raudiez/tfg/README.md

**Deaf Alert System**
=================

This **Final Degree Project** consist in a **alert system** that does rgb leds bulvs change its color light and state with every alert, and simultaneously notify an android app with the alert.

You can find more information in "*MemoriaTFG.pdf*" file (in Spanish), like setup instructions.
