raudiez/tfg/src_tex/portadas/portada-especificaciones.tex

\thispagestyle{empty}
\normalsize
\mdseries
\begin{center}

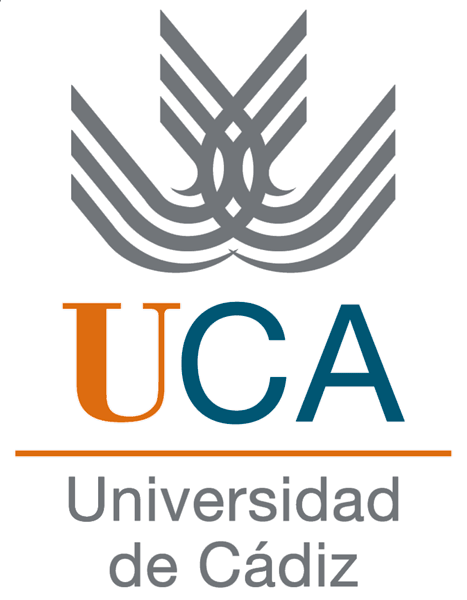
[picture p11: src_tex/img/logo-uca.png]
   \\\

  \vspace{1.5cm}

  \huge{SISTEMA DE AVISOS PARA DISCAPACITADOS AUDITIVOS} \\
  
  \vspace{0.6cm}

  \large{REF: 000001} \\
  
  \vspace{1.0cm}

  \Huge{\textbf{ESPECIFICACIONES DEL SISTEMA}} \\

  \vspace{2.5cm}

\end{center}
\begin{itemize}
\item {\textbf{CLIENTE:} UNIVERSIDAD DE CÁDIZ (ESCUELA SUPERIOR DE INGENIERÍA)\\
            AVENIDA DE LA UNIVERSIDAD DE CÁDIZ Nº 10, 11519 PUERTO REAL\\
            956 48 32 00\\
            \underline{DIRECCION.ESI@UCA.ES}
            }
            \vspace{0.5cm}
\item {\textbf{AUTOR:} RAÚL DÍEZ SÁNCHEZ\\
            INGENIERO INFORMÁTICO\\
            77171812-G\\
            \underline{RA.DIEZSANCHEZ@ALUM.UCA.ES}}
\end{itemize}

\vspace{0.2cm}

\begin{flushright}
  \large{Cádiz, \today} \\
\end{flushright}
