raudiez/tfg/src_tex/contenido/0_hoja_identificacion.tex

\begin{itemize}
    \item \textbf{Título del proyecto:} Sistema de avisos para discapacitados auditivos \\
    \item \textbf{Código del proyecto:} 000001 \\
    \item \textbf{Datos del cliente:} \\
        \begin{itemize}
            \vspace{-0.4cm}
            \item Universidad de Cádiz (Escuela Superior de Ingeniería)
            \item Avenida de la Universidad de Cádiz Nº10, 11519 Puerto Real
            \item 956 48 32 00
            \item direccion.esi@uca.es
        \end{itemize}
    \item \textbf{Datos del suministrador:} \\
        \begin{itemize}
            \vspace{-0.4cm}
            \item Raúl Díez Sánchez
            \item Ingeniero Informático
            \item Calle Sagasta Nº 56 1ºA, 11002 Cádiz
            \item 653 50 41 47
            \item ra.diezsanchez@alum.uca.es
        \end{itemize}
\end{itemize}

\vspace{2cm}

Firmado:

\vspace{-0.9cm} 
\begin{flushright} Cádiz, \today \end{flushright}

\vspace{2cm}

\begin{table}[h]
    \centering
    \begin{tabular}{lr}
        Raúl Díez Sánchez & \hspace{9cm}Cliente
    \end{tabular}
\end{table}
