raudiez/tfg/src_tex/contenido/18_presupuesto.tex

\section{Presupuesto para la realización del Proyecto}

En la tabla~\ref{tab:presupuesto_demo} se incluye el presupuesto total para la realización de este Proyecto, incluyendo también los costes asociados a la implementación del sistema de demostración, IVA incluido.

\begin{table}[!ht]
    \centering
    \resizebox{\textwidth}{!}{%
    \begin{tabular}{|P{4.5cm}|c|c|c|c|}
        \hline
        \textbf{Artículo} & \textbf{Detalles} & \textbf{Cantidad} & \textbf{Precio} & \textbf{Total} \\ \hline
        Raspberry Pi B &~\cite{presupuesto_raspberry} & 1 & 31,52 €/u & 31,52 €\\ \hline
        Adaptador de corriente para Raspberry Pi &~\cite{presupuesto_corriente_raspi} & 1 & 5,78 €/u & 5,78 € \\ \hline
        Relé 40.31 12V &~\cite{presupuesto_rele12} & 1 & 5,37 €/u & 5,37 € \\ \hline
        Relé T92S7A12-240 240V &~\cite{presupuesto_rele240} & 1 & 17,69 €/u & 17,69 € \\ \hline
        Terminal para PCB &~\cite{presupuesto_terminal} & 4 & 0,24 €/u & 0,96 € \\ \hline
        Tarjeta SD 8GB para Raspberry Pi &~\cite{presupuesto_sd} & 1 & 12,95 €/u & 12,95 € \\ \hline
        Kit de inicio Philips Hue &~\cite{huestarterprice} & 1 & 199,95 €/u & 199,95 € \\ \hline
        Latiguillo 1m RJ-45 Cat5e &~\cite{presupuesto_rj45} & 1 & 2,06 €/u & 2,06 € \\ \hline
        Resistencia de 4,7K$\Omega$ &\cite{presupuesto_resistencia} & 2 & 0,04 €/u & 0,8 € \\ \hline
        Arduino Mega &~\cite{presupuesto_arduino} & 1 & 56,94 €/u & 56,94 € \\ \hline
        Arduino Ethernet Shield &~\cite{presupuesto_arduino_shield} & 1 & 24,01 €/u & 24,01 € \\ \hline
        Cable USB para Arduino Mega &~\cite{presupuesto_arduino_usb} & 1 & 3,31 €/u & 3,31 € \\ \hline
        Zumbador 230V para timbre & - & 1 & 4,50 €/u & 4,50 € \\ \hline
        Zumbador 12V para telefonillo &~\cite{presupuesto_timbre} & 1 & 2,71 €/u & 2,71 € \\ \hline
        Fuente de alimentación 12V &~\cite{presupuesto_fuente12v} & 1 & 14,92 €/u & 14,92 € \\ \hline
        Pulsador timbre & - & 1 & 2,75 €/u & 2,75 € \\ \hline
        Portalámparas E27 & - & 2 & 0,90 €/u & 1,80 € \\ \hline
        \textbf{Total}& \multicolumn{3}{c|}{} & 388,02 € \\ \hline
    \end{tabular}
    }
    \caption{Presupuesto para la realización del Proyecto.}
    \label{tab:presupuesto_demo}
\end{table}

\clearpage
\section{Presupuesto de implantación del Proyecto}
\label{sec:presupuesto}

En la tabla~\ref{tab:presupuesto_final} se incluye el presupuesto total para la implantación de este Proyecto, IVA incluido.

\begin{table}[!ht]
    \centering
    \resizebox{\textwidth}{!}{%
    \begin{tabular}{|P{4cm}|c|c|c|c|}
        \hline
        \textbf{Artículo} & \textbf{Detalles} & \textbf{Cantidad} & \textbf{Precio} & \textbf{Total} \\ \hline
        Raspberry Pi B &~\cite{presupuesto_raspberry} & 1 & 31,52 €/u & 31,52 €\\ \hline
        Adaptador de corriente para Raspberry Pi &~\cite{presupuesto_corriente_raspi} & 1 & 5,78 €/u & 5,78 € \\ \hline
        Relé 40.31 12V &~\cite{presupuesto_rele12} & 1 & 5,37 €/u & 5,37 € \\ \hline
        Relé T92S7A12-240 240V &~\cite{presupuesto_rele240} & 1 & 17,69 €/u & 17,69 € \\ \hline
        Terminal para PCB &~\cite{presupuesto_terminal} & 4 & 0,24 €/u & 0,96 € \\ \hline
        Tarjeta SD 8GB para Raspberry Pi &~\cite{presupuesto_sd} & 1 & 12,95 €/u & 12,95 € \\ \hline
        Kit de inicio Philips Hue &~\cite{huestarterprice} & 1 & 199,95 €/u & 199,95 € \\ \hline
        Latiguillo 1m RJ-45 Cat5e &~\cite{presupuesto_rj45} & 1 & 2,06 €/u & 2,06 € \\ \hline
        Resistencia de 4,7K$\Omega$ &\cite{presupuesto_resistencia} & 2 & 0,04 €/u & 0,8 € \\ \hline
        \textbf{Total}& \multicolumn{3}{c|}{} & 277,08 € \\ \hline
    \end{tabular}
    }
    \caption{Presupuesto de implantación del Proyecto.}
    \label{tab:presupuesto_final}
\end{table}

Este presupuesto no cubre el coste de un router integrado, el cual como se observa en el apartado~\ref{sec:routerintegrado}, se supone ya instalado en la vivienda.

    \subsection{Mano de obra}

    La mano de obra asociada al Proyecto es de 35 € por instalación de dispositivo en portal, más 35 € por instalación de dispositivo en la puerta de la vivienda, más 60 € por instalación del sistema central y configuración. Esto hace un total de \textbf{130 €}, tal como se observa en la tabla~\ref{tab:presupuesto_manoobra}.

    \begin{table}[!ht]
        \centering
        \resizebox{0.6\textwidth}{!}{%
        \begin{tabular}{|l|c|}
            \hline
            \textbf{Descripción} & \textbf{Precio} \\ \hline
            Instalación de dispositivo en portal & 35 €\\ \hline
            Instalación de dispositivo en puerta de la vivienda & 35 €\\ \hline
            Instalación de sistema central y configuración & 60 €\\ \hline
            \textbf{Total}& 130 € \\ \hline
        \end{tabular}
        }
        \caption{Presupuesto de mano de obra.}
        \label{tab:presupuesto_manoobra}
    \end{table}

    \subsection{Resumen del presupuesto}

    Los costes de presupuesto para la implantación en una vivienda real son de 277.08 €, debiéndose sumar además el coste de mano de obra, que asciende a los 130 €. Esto supone un \textbf{coste total de 407.08 €}. Se debe tener en cuenta además que este precio es el relativo a instalar 3 bombillas Hue, teniendo un coste de 52.99 € por bombilla extra a instalar~\cite{hueindividualprice}, tal como se muestra en la tabla~\ref{tab:presupuesto_resumen}.

    \begin{table}[!ht]
        \centering
        \resizebox{0.6\textwidth}{!}{%
        \begin{tabular}{|l|c|}
            \hline
            \textbf{Descripción} & \textbf{Precio} \\ \hline
            Implantación del Proyecto en vivienda real & 277.08 €\\ \hline
            Mano de obra & 130 €\\ \hline
            \textbf{Total}& 407.08 € \\ \hline
        \end{tabular}
        }
        \caption{Resumen del presupuesto de implantación del Proyecto}
        \label{tab:presupuesto_resumen}
    \end{table}
