raudiez/tfg/src_tex/portadas/portada-inicial.tex

\begin{titlepage}

  \begin{center}

     \\
    
    \vspace{2.5cm}
    
    \LARGE{\textbf{ESCUELA SUPERIOR DE INGENIERÍA}} \\
    
    \vspace{1.0cm}
    
    \Large{\textbf{GRADO EN INGENIERÍA INFORMÁTICA}} \\
    
    \vspace{3.0cm}
    
    \Large{SISTEMA DE AVISOS PARA DISCAPACITADOS AUDITIVOS} \\
    
    \vspace{2.5cm}
    
    \Large{Raúl Díez Sánchez} \\
  
    \vspace{0.5cm}

    \large{\today}
    
  \end{center}
\end{titlepage}
