raudiez/tfg/src_tex/portadas/portada-secundaria.tex

\begin{center}

   \\

  \vspace{2.0cm}

  \Large{ESCUELA SUPERIOR DE INGENIERÍA} \\

  \vspace{1.0cm}

  \large{GRADO EN INGENIERÍA EN INFORMÁTICA} \\

  \vspace{1.5cm}

  \huge{SISTEMA DE AVISOS PARA DISCAPACITADOS AUDITIVOS} \\

  \vspace{2.0cm}

\end{center}

\begin{itemize}
\item \large{Departamento: Ingeniería Automática, Electrónica, Arquitectura y Redes de Computadores.}
\item \large{Director del proyecto: Carlos Rodríguez Cordón}
\item \large{Codirector del proyecto: Arturo Morgado Estévez}
\item \large{Autor del proyecto: Raúl Díez Sánchez}
\end{itemize}

\vspace{0.2cm}

\begin{flushright}
  \large{Cádiz, \today} \\

  \vspace{1.5cm}

  \large{Fdo: Raúl Díez Sánchez}
\end{flushright}
