raudiez/tfg/MemoriaTFG.pdf

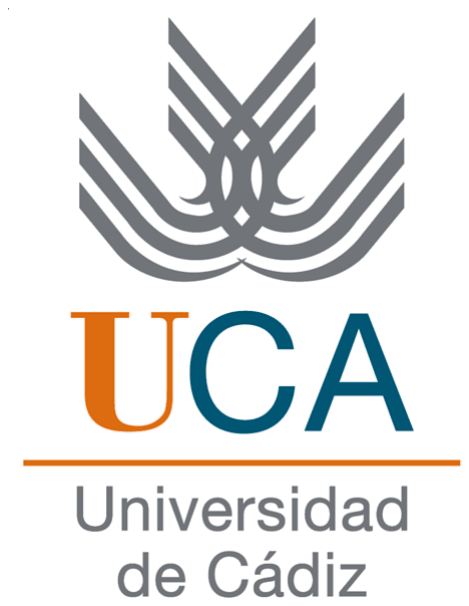
[picture p22: figure]

## ESCUELA SUPERIOR DE INGENIERÍA

## GRADO EN INGENIERÍA INFORMÁTICA

## SISTEMA DE AVISOS PARA DISCAPACITADOS AUDITIVOS

## Raúl Díez Sánchez

3 de febrero de 2016

## ESCUELA SUPERIOR DE INGENIERÍA

GRADO EN INGENIERÍA EN INFORMÁTICA

# SISTEMA DE AVISOS PARA DISCAPACITADOS

# AUDITIVOS

Departamento: Ingeniería Automática, Electrónica, Arquitectura y Redes de Computadores.

Director del proyecto: Carlos Rodríguez Cordón

Codirector del proyecto: Arturo Morgado Estévez

Autor del proyecto: Raúl Díez Sánchez

Cádiz, 3 de febrero de 2016

Fdo: Raúl Díez Sánchez

## Agradecimientos

Quiero agradecer este trabajo a todas las personas que siempre han estado cerca, apoyándome y animándome a continuar en esta etapa de mi vida, gracias a ellos he conseguido cumplir uno de los grandes sueños de mi vida.

A mi familia, en especial a mis padres, por enseñarme que la vida es dura, y que hay que estudiar y trabajar para salir adelante en la vida. Por toda la confianza depositada en mí a lo largo de todos mis estudios. También a Rafael, que aunque no sea de la familia es como si lo fuese, y siempre está ahí para ayudar y apoyar en lo que haga falta.

A mis amigos de toda la vida, Iñaki, José, y María, que, desde el instituto en especial, me han apoyado en todo lo que he hecho, además de pasar muy buenos momentos que siempre me han servido para desconectar. También a todos los demás, los que han estado ahí, todos aportando su granito de arena en todo momento.

A todos mis compañeros, con los que de verdad he hecho amistad, en especial a Alejandro (a ambos), David, Ismael, Joaquín, Paco y Pepe, que tanta ayuda me han proporcionado y con los que tan buenos momentos he pasado a lo largo de mi etapa universitaria.

Por último, a todos los profesores que he tenido, en especial mis profesores del instituto y de la universidad, todos los que me han ayudado a ver que la informática era lo mío. A Javier, que desde el instituto me enseñó lo interesante que puede llegar a ser el mundo de los ordenadores. A Arturo y Carlos, mis tutores, quienes han sabido guiarme para que este trabajo llegase a buen puerto, y me han enseñado lo bonito que puede ser el tema que trato en él.

A todos, gracias. Se acabó.

# SISTEMA DE AVISOS PARA DISCAPACITADOS

# AUDITIVOS

REF: 000001

# ÍNDICE GENERAL

CLIENTE: UNIVERSIDAD DE CÁDIZ (ESCUELA SUPERIOR DE INGENIERÍA) AVENIDA DE LA UNIVERSIDAD DE CÁDIZ No 10, 11519 PUERTO REAL
956 48 32 00
DIRECCION.ESI@UCA.ES

AUTOR: RAÚL DÍEZ SÁNCHEZ
INGENIERO INFORMÁTICO
77171812-G
RA.DIEZSANCHEZ@ALUM.UCA.ES

Cádiz, 3 de febrero de 2016

# Índice general

I | Memoria | 1
0. Hoja de Identificación | 1
1. Introducción | 2
2. Objetivo | 2
3. Antecedentes | 2
4. Descripción de la Situación Actual | 3
5. Normas y Referencias | 4
6. Definiciones y Abreviaturas | 8
7. Requisitos Iniciales | 10
8. Alcance | 10
9. Estudio de Alternativas y Viabilidad | 10

10.Descripción de la Solución Propuesta | 19
11.Planificación Temporal | 45

12.Resumen del Presupuesto | 47
II | Planos | 49
13.Plano 1: Esquemático PCB para conexión con telefonillo | 53
14.Plano 2: Layout PCB para conexión con telefonillo | 54
15.Plano 3: Esquemático PCB para conexión con timbre | 55
16.Plano 4: Layout PCB para conexión con timbre | 56
III | Anexos | 57
17.Documentación de Entrada | 61
18.Análisis y Diseño del Sistema | 62
19.Plan de Pruebas | 76
20.Instalación de Sistema Operativo en Raspberry Pi | 82
21.Estimación de Tamaño y Esfuerzos | 85

22.Hojas técnicas de componentes empleados | 86
IV | Especificaciones del Sistema | 89
23.Especificaciones del Sistema | 93
V | Presupuesto | 101
24.Presupuesto | 105

# Índice de figuras

10.1. Diagrama de bloques del sistema | | 19
10.2. Estructura de directorios y ficheros del software del nodo central | | 32
10.3. Diseño del circuito de interconexión telefonillo-nodo central | | 33
10.4. Diseño del circuito de interconexión timbre-nodo central | | 33
10.5. Diagrama de integración del sistema con el nodo central | | 34
10.6. Diseño final de la arquitectura del sistema | | 35
10.7. Pantalla principal de la aplicación para Android | | 36
10.8. Borrado de alertas en aplicación para Android | | 36
10.9. Menú de configuración de aplicación para Android | | 37
11.1. Diagrama de Gantt de la planificación temporal del Proyecto | | 46
18.1. Diagrama de subsistemas | | 63
18.2. Diagrama de subsistema de gestión de alertas | | 63
18.3. Diagrama de subsistema de gestión de puente Hue | | 64
18.4. Diagrama de casos de uso de aplicación para smartphone | | 69
18.5. Diagrama de diseño del sistema software del nodo central | | 72
18.6. Diagrama de diseño de la aplicación para smartphone | | 72
18.7. Prototipo de la pantalla principal de la aplicación para smartphones | | 73
18.8. Prototipo del menú desplegable | | 74
18.9. Prototipo de ventana emergente para eliminar alertas | | 74
18.10.Prototipo de menú de configuración | | 75
23.1. Resultados para “¿Qué avisos son importantes para ti en tu hogar?” | | 93
23.2. Resultados para “En la actualidad, ¿cómo te percatas de estos avisos?” | | 94
23.3. Resultados para “Haciendo uso de las nuevas tecnologías, ¿crees que puede mejo-
rarse?,¿cómo te gustaría percatarte de los avisos?” | 94
23.4. Resultados para “Continuando con las nuevas tecnologías, ¿crees que sería útil
recibir las mismas alertas en smartphones Android?” | | 94
23.5. Diagrama de Casos de Uso | | 96

# Índice de tablas

9.1. Comparativa de bombillas LED | | 11
9.2. Especificaciones técnicas principales de interés del estándar Bluetooth | | 12
9.3. Especificaciones técnicas principales de interés del estándar IEEE 802.11n | | 13
9.4. Características técnicas principales de interés de Arduino Mega | | 15
9.5. Características técnicas principales de interés de Raspberry Pi B | | 18
12.1. Resumen del presupuesto de implantación del Proyecto | | 47
18.1. Objetivo 1 del nodo central: Utilizar el puente Hue | | 62
18.2. Objetivo 2 del nodo central: Detectar llamadas | | 62
18.3. Objetivo 3 del nodo central: Alertar mediante bombillas | | 62
18.4. Objetivo 4 del nodo central: Alertar mediante smartphone | | 63
18.5. Actor 01: Sistema | | 64
18.6. Caso de Uso 01: Conectar con puente Hue | | 65
18.7. Caso de Uso 02: Configurar puente Hue | | 65
18.8. Caso de Uso 03: Enviar petición a puente Hue | | 66
18.9. Caso de Uso 04: Encontrar nuevas bombillas | | 66
18.10.Caso de Uso 05: Leer estado de pines GPIO | | 67
18.11.Caso de Uso 06: Cambiar estado de bombillas | | 67
18.12.Caso de Uso 07: Enviar alerta a smartphone | | 68
18.13.Objetivo 1 de la aplicación para smartphone: Conectar con nodo central | | 68
18.14.Objetivo 2 de la aplicación para smartphone: Mostrar alerta a usuario | | 68
18.15.Objetivo 3 de la aplicación para smartphone: Gestionar alertas | | 69
18.16.Actor 01: Usuario | | 69
18.17.Caso de Uso 01: Configurar aplicación | | 70
18.18.Caso de Uso 02: Mostrar alerta en pantalla | | 70
18.19.Caso de Uso 03: Mostrar notificación en sistema | | 71
18.20.Caso de Uso 04: Eliminar alerta vista | | 71
19.1. Trazabilidad de Casos de Prueba - Requisitos (Casos de Uso) | | 76
19.2. CP-01: Comprobar recepción de alertas en Raspberry Pi y Hue | | 76
19.3. CP-02: Comprobar recepción de alertas en smartphone | | 77
19.4. CP-03: Comprobar funcionamiento con nuevas bombillas Hue | | 77
19.5. CP-04: Comprobar recepción de alerta de telefonillo en bombillas Hue y aplicación
para smartphone | 78
19.6. CP-05: Comprobar recepción de alerta de timbre en bombillas Hue y aplicación
para smartphone | | 79
19.7. CP-06: Comprobar recepción de notificación en smartphone | | 79

19.8. CP-07: Comprobar gestión de alertas en smartphone | | 80
19.9. CP-08: Comprobar funcionamiento tras caída de red eléctrica | | 80
19.10.CP-09: Comprobar compatibilidad con aplicación oficial de control de bombillas
Hue | | 81
23.1. Objetivo 1 del sistema: Alertar a usuario de llamada al timbre | | 95
23.2. Objetivo 2 del sistema: Alertar a usuario de llamada al telefonillo | | 95
23.3. Requisitos de restricciones de información | | 96
23.4. Requisitos de almacenamiento de información | | 96
23.5. Actor 01: agente externo | | 97
23.6. Actor 02: usuario del sistema | | 97
23.7. Caso de Uso 01: Alertar telefonillo | | 97
23.8. Caso de Uso 02: Alertar timbre | | 98
23.9. Caso de Uso 03: Mostrar alerta en bombilla RGB | | 98
23.10.Caso de Uso 04: Mostrar alerta en smartphone | | 99
24.1. Presupuesto para la realización del Proyecto | 105
24.2. Presupuesto de implantación del Proyecto | 106
24.3. Presupuesto de mano de obra | 106
24.4. Resumen del presupuesto de implantación del Proyecto | 107

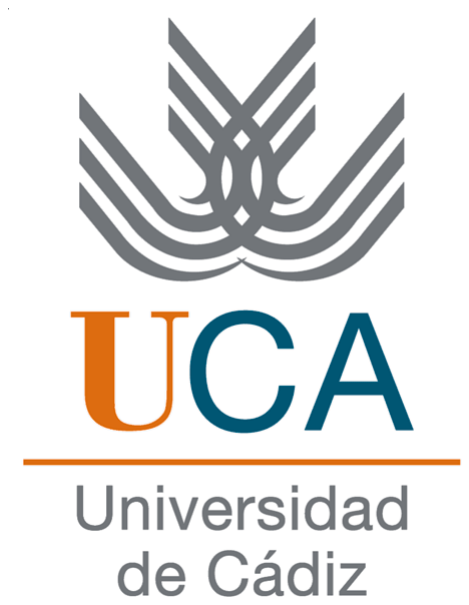
[picture p23: figure]
Parte I

# SISTEMA DE AVISOS PARA DISCAPACITADOS

# AUDITIVOS

REF: 000001

# MEMORIA

CLIENTE: UNIVERSIDAD DE CÁDIZ (ESCUELA SUPERIOR DE INGENIERÍA) AVENIDA DE LA UNIVERSIDAD DE CÁDIZ No 10, 11519 PUERTO REAL
956 48 32 00
DIRECCION.ESI@UCA.ES

AUTOR: RAÚL DÍEZ SÁNCHEZ
INGENIERO INFORMÁTICO
77171812-G
RA.DIEZSANCHEZ@ALUM.UCA.ES

Cádiz, 3 de febrero de 2016

# Índice

0. Hoja de Identificación | 1
1. Introducción | 2
2. Objetivo | 2
3. Antecedentes | 2
4. Descripción de la Situación Actual | 3
5. Normas y Referencias | 4
6. Definiciones y Abreviaturas | 8
7. Requisitos Iniciales | 10

8. Alcance | 10
9. Estudio de Alternativas y Viabilidad | 10
10. Descripción de la Solución Propuesta | 19
11. Planificación Temporal | 45
12. Resumen del Presupuesto | 47

# Hoja de Identificación

Título del proyecto: Sistema de avisos para discapacitados auditivos

Código del proyecto: 000001

Datos del cliente:

- Universidad de Cádiz (Escuela Superior de Ingeniería)
- Avenida de la Universidad de Cádiz No10, 11519 Puerto Real
- 956 48 32 00
- direccion.esi@uca.es

Datos del suministrador:

- Raúl Díez Sánchez
- Ingeniero Informático
- Calle Sagasta No 56 1oA, 11002 Cádiz
- 653 50 41 47
- ra.diezsanchez@alum.uca.es
Firmado: | Cádiz, 3 de febrero de 2016
Raúl Díez Sánchez | Cliente

MEMORIA

SISTEMA DE AVISOS PARA DISCAPACITADOS AUDITIVOS

# 1. Introducción

Cada día más, la tecnología nos muestra lo útil que puede llegar a ser para simplificar o ayudar en nuestro día a día. Un ejemplo de esto son la domótica y los proyectos AAL (o de vida asistida en la vivienda, por sus siglas en inglés) que surgen a raíz de la domotización.

La tecnología ayuda a solventar grandes necesidades, con soluciones cada vez mejores y más adaptadas. La accesibilidad es una de las grandes necesidades de la sociedad: permitir que un producto o servicio pueda ser utilizado por todos los posibles usuarios, incluyendo personas con diferentes capacidades o discapacidades.

Existen diversas discapacidades, y todas presentan un gran problema a la hora de que las personas que las padecen sean autónomas. Una de estas discapacidades es la auditiva. El simple hecho de estar en casa puede ser un gran problema, como lo es no saber cuándo llaman a la puerta.

# 2. Objetivo

El objetivo de este proyecto es crear un sistema para adaptar la vivienda de una persona o personas con discapacidad auditiva, de manera que puedan determinar en todo momento si alguien del exterior está intentando comunicarse con alguien en el interior de la vivienda.

Se pretende implantar un sistema de avisos visuales, que el discapacitado pueda ver, comprender y actuar conforme a la alerta.

# 3. Antecedentes

Actualmente existen varias soluciones a los problemas que pueda tener una persona con discapacidad auditiva, independientes del grado de discapacidad que padezca.

Una de las soluciones consiste en un aparato de bolsillo de avisos por señales de vibración y luces de colores [42], que recibe los avisos de distintos aparatos receptores de ruido que pueden obtener información del ruido generado por el timbre, el teléfono, el portero automático...

Esta solución requeriría que el discapacitado lleve consigo siempre un aparato en el bolsillo, lo cual puede ser un poco molesto. Además, tiene una limitación de número de alarmas a captar.

Otra posible solución es la instalación de ventanas en la mayoría de las paredes de la vivienda (paredes interiores), que permitiría ver las alertas visuales desde cualquier habitación. Este sistema necesitaría que previamente se modificasen los aparatos que emiten alertas sonoras para que emitan alertas visuales, además de reducir la intimidad de las personas que habiten en la

MEMORIA

vivienda.

Una solución diferente a las anteriores es adaptar la instalación eléctrica de la vivienda [41], instalando tantas lámparas por habitación como alertas visuales se quieran mostrar. Estas lámparas mostrarían alertas visuales para el teléfono, el timbre, etc. La mayor desventaja aquí es el consumo de bombillas necesarias para una instalación completa, y el espacio que estas ocuparían.

# 4. Descripción de la Situación Actual

Hoy día, en cualquier vivienda existen demasiadas alertas sonoras como para controlarlas todas. Se pretende así por tanto tratar las alertas más importantes para que las personas con discapacidad puedan percibir los avisos más importantes.

## 4.1. Informe de diagnóstico

En este punto se tratan los distintos aspectos a tener en cuenta dentro de una vivienda estándar en cuanto a alertas se refiere. Este informe es la base de parte de los requisitos no funcionales.

### 4.1.1. Timbre de la puerta

Un caso es el timbre de la puerta, donde una persona con discapacidad auditiva es poco probable que sea capaz de percibir las alertas que genere.

### 4.1.2. Telefonillo (portero automático)

Otro caso es el del portero automático, del cual existen 2 tipos básicos: analógicos y digitales. Pese a que los telefonillos digitales son tecnológicamente superiores, se siguen utilizando telefonillos analógicos, debido a su bajo coste en comparación. Además, históricamente, el uso del telefonillo analógico es más extendido. Debido a estas razones, en este Proyecto se tendrá en cuenta el uso de telefonillo analógico, para abarcar un mayor rango de posibles instalaciones.
Entre los telefonillos analógicos, existen 2 tipos atendiendo al tipo de llamada que realizan:

Llamada zumbador.

Llamada electrónica.

La diferencia principal entre ambos reside en su funcionamiento y la forma de generar la alerta sonora [1].

Telefonillos analógicos de llamada zumbador: En los telefonillos con llamada zumbador, una vez que se realiza la llamada, el grupo fónico de la placa exterior a la vivienda genera una señal alterna de 12 Vac que envía por el hilo de llamada. La señal alterna llega al zumbador situado en el teléfono, haciendo que el zumbador vibre y finalmente produzca el sonido de la llamada.

Telefonillos analógicos de llamada electrónica: En los telefonillos con llamada electrónica, una vez que se realiza la llamada, el grupo fónico de la placa exterior a la vivienda genera una señal formada por diferentes frecuencias, y la envía por el hilo de llamada. La

MEMORIA

señal llega al altavoz del auricular del teléfono, produciendo el sonido de la llamada. La llamada puede ser de varios tipos en función del número de frecuencias utilizadas.

Teniendo en cuenta que los de llamada zumbador envían una señal de 12 Vac, y los de llamada electrónica una señal de varias frecuencias, es más fácil trabajar con los del primer tipo, pudiendo darse soluciones electrónicas bastante sencillas. Además, son el tipo más extendido, y el que más probabilidades hay de encontrar en una vivienda. Se utilizará por tanto un telefonillo de este tipo para la implementación del sistema y la demostración de funcionamiento.

### 4.1.3. Bombillas

En cuanto a las bombillas existentes en una vivienda, las más empleadas son las bombillas de casquillo E27, también llamadas bombillas de rosca Edison. Por tanto, para abarcar un mayor rango de posibles instalaciones, este Proyecto se basará en el uso de bombillas de este tipo.

En caso de manipular estas bombillas, existen dos posibilidades: hacerlo mediante la propia instalación eléctrica, o manipularlas de manera inalámbrica.

### 4.1.4. Router integrado

Dentro de una vivienda habitualmente se puede encontrar un router integrado, dispositivo que integra las funciones y conexiones de un router, un punto de acceso WiFi y un switch Ethernet. Este dispositivo suele ser instalado por el Proveedor de Servicio de Internet (ISP) o incluso hay usuarios que adquieren un router integrado neutro (no ligado a un ISP) por separado.

# 5. Normas y Referencias

## 5.1. Disposiciones legales y Normas aplicadas

UNE 157801:2007 - Criterios generales para la elaboración de proyectos de sistemas de información.

UNE 157001:2014 - Criterios generales para la elaboración formal de los documentos que constituyen un proyecto técnico.

## 5.2. Bibliografía

[1] ALCAD Electronics. Manual Técnico Sistemas Convencionales. http://www.alcad.net/uploads/publicaciones/catalogos/pdf/MANUAL%20CONVENCIONAL.pdf. (http://www.alcad.net/uploads/publicaciones/catalogos/pdf/MANUAL%20CONVENCIONAL.pdf) [29-01-2016].
[2] Amazon. | Phillips Hue Bombilla Individual - Amazon. | http://www.amazon.es/
Philips-Hue-8718696461730-individual-app-control/dp/B016151IW6. (http://www.amazon.es/Philips-Hue-8718696461730-individual-app-control/dp/B016151IW6) [29-01-2016].
[3] Amazon. | Phillips Hue Starter Kit - Amazon. | http://www.amazon.es/
Philips-Hue-eficiencia-energ%C3%A9tica-a_plus_plus_plus/dp/ B016H0R0EA. (http://www.amazon.es/Philips-Hue-eficiencia-energ%C3%A9tica-a_plus_plus_plus/dp/B016H0R0EA) [29-01-2016].

MEMORIA

[4] Arduino. | Arduino Mega Specifications. | https://www.arduino.cc/en/Main/
ArduinoBoardMega. (https://www.arduino.cc/en/Main/ArduinoBoardMega) [29-01-2016].
[5] Arduino. Arduino Playground - Available Memory. http://playground.arduino.cc/Code/AvailableMemory. (http://playground.arduino.cc/Code/AvailableMemory) [29-01-2016].
[6] Arduino. Memory leak in WString / TextString Library? - Arduino Forum. http://forum.arduino.cc/index.php?topic=46753.0. [29-01-2016].
[7] Belkin. | Belkin | WeMo | - | Página | oficial. | http://www.belkin.es/
productos-el-hogar-conectado-domotica-wemo/. (http://www.belkin.es/productos-el-hogar-conectado-domotica-wemo/) [29-01-2016].
[8] Belkin. | Belkin | WeMo | Bombilla | Individual. | http://www.belkin.es/
f7c033vfe27es-bombilla-wemo-smart-led.html. (http://www.belkin.es/f7c033vfe27es-bombilla-wemo-smart-led.html) [29-01-2016].
[9] Belkin. | Belkin | WeMo | | Starter | Kit. | http://www.belkin.es/
f5z0489vfes-kit-basico-wemo-iluminacion-led.html. (http://www.belkin.es/f5z0489vfes-kit-basico-wemo-iluminacion-led.html) [29-01-2016].
[10] Benoît Blanchon. | ArduinoJson - GitHub. | https://github.com/bblanchon/
ArduinoJson. (https://github.com/bblanchon/ArduinoJson) [29-01-2016].
[11] Castro, Rodrigo. Avanzando en la seguridad de las redes WIFI. http://www.rediris.es/difusion/publicaciones/boletin/73/ENFOQUE1.pdf, (http://www.rediris.es/difusion/publicaciones/boletin/73/ENFOQUE1.pdf) 2005. [29-01-2016].
[12] Chris Continanza. | RestClient - GitHub. | https://github.com/csquared/
arduino-restclient. (https://github.com/csquared/arduino-restclient) [29-01-2016].
[13] Cisco Networking Academy. Switched Networks Companion Guide. Cisco Press, 2014.
[14] Durán Toro, Amador y Bernárdez Jiménez, Beatriz. Metodología para la Elicitación de Requisitos de Sistemas Software. http://www.infor.uva.es/~mlaguna/is1/materiales/metodologia_elicitacion.pdf, (http://www.infor.uva.es/~mlaguna/is1/materiales/metodologia_elicitacion.pdf) 2002. [29-01-2016].
[15] Gadgetoid. Raspberry Pi Pinout. http://pinout.xyz/pinout/pin1_3v3_power. [29-01-2016].
[16] Google Inc. | Android Developers. | http://developer.android.com/intl/es/
index.html. (http://developer.android.com/intl/es/index.html) [29-01-2016].
[17] Houda Labiod, Houssam Afifi y Constantino de Santis. Wi-Fi, Bluetooth, ZigBee and WiMax. Springer, 2007.
[18] Interactive | Matter. | aJson | - | GitHub. | https://github.com/
interactive-matter/aJson. (https://github.com/interactive-matter/aJson) [29-01-2016].
[19] LimitlessLED. LimitlessLED Bombilla Individual. http://www.limitlessled.com/shop/rgbw-color-led-light-bulb. (http://www.limitlessled.com/shop/rgbw-color-led-light-bulb) [29-01-2016].
[20] LimitlessLED. LimitlessLED Puente WiFi. http://www.limitlessled.com/shop/wifi-udp-receiver-bridge. (http://www.limitlessled.com/shop/wifi-udp-receiver-bridge) [29-01-2016].
[21] LimitlessLED. | LimitlessLED Smart-Light - Página oficial. | http://www.
limitlessled.com. [29-01-2016].

MEMORIA

[22] LimitlessLED. LimitlessLED Starter Kit. http://www.limitlessled.com/shop/limitless-led-starter-kit. (http://www.limitlessled.com/shop/limitless-led-starter-kit) [29-01-2016].
[23] Neil McNeight. | MemoryFree - GitHub. | https://github.com/McNeight/
MemoryFree. (https://github.com/McNeight/MemoryFree) [29-01-2016].
[24] Philips. How Hue Works - Philips Hue API. http://www.developers.meethue.com/documentation/how-hue-works. (http://www.developers.meethue.com/documentation/how-hue-works) [29-01-2016].
[25] Philips. Philips Hue - Página oficial. http://www2.meethue.com/es-ES. [29-01-2016].
[26] Raspberry Pi Foundation. GPIO: Raspberry Pi models A and B - Raspberry Pi Documentation. https://www.raspberrypi.org/documentation/usage/gpio/. [29-01-2016].
[27] Raspberry Pi Foundation. Raspberry Pi Hardware - Raspberry Pi Documentation. https://www.raspberrypi.org/documentation/hardware/raspberrypi. [29-01-2016].
[28] RS Components. Arduino Ethernet Shield 2 - RS Online. http://es.rs-online.com/web/p/kits-de-desarrollo-de-procesador-y-microcontrolador/8732285. (http://es.rs-online.com/web/p/kits-de-desarrollo-de-procesador-y-microcontrolador/8732285) [29-01-2016].
[29] RS Components. Arduino Mega - RS Online. http://es.rs-online.com/web/p/kits-de-desarrollo-de-procesador-y-microcontrolador/7154084. (http://es.rs-online.com/web/p/kits-de-desarrollo-de-procesador-y-microcontrolador/7154084) [29-01-2016].
[30] RS Components. Cable USB 1m A macho a B macho - RS Online. http://es.rs-online.com/web/p/latiguillos-usb/7587490. (http://es.rs-online.com/web/p/latiguillos-usb/7587490) [29-01-2016].
[31] RS Components. | Conexión de fuente de alimentación - RS Online. | http://es.
rs-online.com/web/p/fuente-de-alimentacion-enchufable/8226373. (http://es.rs-online.com/web/p/fuente-de-alimentacion-enchufable/8226373) [29-01-2016].
[32] RS Components. Fuente de alimentación 12 V - RS Online. http://es.rs-online.com/web/p/fuente-de-alimentacion-enchufable/7300234. (http://es.rs-online.com/web/p/fuente-de-alimentacion-enchufable/7300234) [29-01-2016].
[33] RS Components. Latiguillo de Ethernet Cat5e - RS Online. http://es.rs-online.com/web/p/latiguillos-cat5e/0557032. (http://es.rs-online.com/web/p/latiguillos-cat5e/0557032) [29-01-2016].
[34] RS Components. | Raspberry Pi Type B - RS Online. | http://es.rs-online.
com/web/p/kits-de-desarrollo-de-procesador-y-microcontrolador/ 7568308. (http://es.rs-online.com/web/p/kits-de-desarrollo-de-procesador-y-microcontrolador/7568308) [29-01-2016].
[35] RS Components. Relé 40.31 12V - RS Online. http://es.rs-online.com/web/p/reles-sin-enclavamiento/7083131. (http://es.rs-online.com/web/p/reles-sin-enclavamiento/7083131) [29-01-2016].
[36] RS Components. Relé T92S7A12-240 240V - RS Online. http://es.rs-online.com/web/p/reles-sin-enclavamiento/7456031. (http://es.rs-online.com/web/p/reles-sin-enclavamiento/7456031) [29-01-2016].
[37] RS Components. Resistencia de 4,7KΩ - RS Online. http://es.rs-online.com/web/p/resistencias-fijas-de-orificio-pasante/0135904. (http://es.rs-online.com/web/p/resistencias-fijas-de-orificio-pasante/0135904) [29-01-2016].

MEMORIA

[38] RS Components. Tarjeta SD 8GB - RS Online. http://es.rs-online.com/web/p/tarjetas-sd/8752692. (http://es.rs-online.com/web/p/tarjetas-sd/8752692) [29-01-2016].
[39] RS Components. Terminal para PCB - RS Online. http://es.rs-online.com/web/p/bloques-terminales-para-pcb/4258720. (http://es.rs-online.com/web/p/bloques-terminales-para-pcb/4258720) [29-01-2016].
[40] RS Components. Zumbador 12V - RS Online. http://es.rs-online.com/web/p/componentes-de-piezo-buzzer/2456528. (http://es.rs-online.com/web/p/componentes-de-piezo-buzzer/2456528) [29-01-2016].
[41] Valinsta Valencia. Ayudas Técnicas para Sordos: Sistema de aviso luminoso. http: //instatronica.blogspot.com.es/2012/09/pruebas.html. [29-01-2016].
[42] Visiofarma. Aviso para sordos por señales de vibración y luces de colores. https://goo.gl/HinrdW. (https://goo.gl/HinrdW) [29-01-2016].
[43] Wikipedia. Tables of AWG wire sizes - Wikipedia. https://en.wikipedia.org/wiki/American_wire_gauge#Tables_of_AWG_wire_sizes. (https://en.wikipedia.org/wiki/American_wire_gauge#Tables_of_AWG_wire_sizes) [29-01-2016].
[44] Wiznet. WIZnet Ethernet Library - GitHub. https://github.com/Wiznet/WIZ_Ethernet_Library. (https://github.com/Wiznet/WIZ_Ethernet_Library) [29-01-2016].

## 5.3. Metodología de desarrollo

En este Proyecto se ha decidido optar por aplicar lo que se conocen como metodologías ágiles, siendo este tipo de metodologías las que se basan en la división del trabajo en determinadas secciones funcionales o etapas que se van revisando e incrementando, con el objetivo de detectar errores y corregirlos poco a poco, llegando a una solución del Proyecto más rápidamente que con las metodologías de desarrollo clásicas.

Dentro de las metodologías ágiles se ha decidido utilizar la denominada SCRUM, metodología que permite seguir un proceso incremental basado en la división y el desarrollo de funcionalidades que se validan y corrigen conforme se avanza en la realización del Proyecto.

Esto proporciona cierta flexibilidad en el desarrollo frente a cualquier tipo de cambio, ya que se pueden tratar como cambios menores. Si se compara esta con otro tipo de metodología, se puede apreciar que es una gran ventaja, ya que en otras metodologías en las que hay que desarrollar una versión de prototipo o una versión totalmente operativa a partir de la cual se corregirá lo que sea necesario, cualquier modificación puede suponer un sobre-coste o un gasto de tiempo con el que al seguir la metodología SCRUM se ahorra.

Otra gran ventaja de esta metodología es que el resultado suele ser de mayor calidad, ya que al abordar funcionalidades poco a poco, y no la totalidad funcional del producto final, el desarrollo se lleva a cabo de una forma más cuidadosa, y es más fácil evitar fallos en el producto final.

Esta metodología, SCRUM, se ha aplicado durante toda la realización del Proyecto, ya sea para el diseño del sistema, el software del nodo central, la aplicación para smartphone o incluso el diseño de los sistemas de interconexión creados.

MEMORIA

## 5.4. Herramientas

### 5.4.1. Herramientas software

Android Studio - Software para el desarrollo de aplicaciones Android proporcionado por Google, utilizado para la programación de la aplicación desarrollada en este Proyecto.

Eagle - Software de creación de circuitos electrónicos para su implementación en placas de circuito impreso. Utilizado para crear las PCB utilizadas en el Proyecto.

Electrodroid - Aplicación para smartphone que contiene una colección de herramientas software electrónicas y documentación técnica, como calculadoras de ancho de pistas para PCB, de caída de voltaje y otras herramientas útiles.

LPKF Circuit Pro - Software propio de la fresadora para PCB utilizada, usado para la fabricación de las placas de circuito impreso del Proyecto.

NinjaMock - Herramienta online para la creación de mockups o prototipos de diseño de aplicaciones, empleado en la realización del prototipado de la aplicación.

Python - Lenguaje de programación en el que se basa el sistema principal de este Proyecto, cada vez más extendido.

Sublime Text - Editor de texto especialmente diseñado para código, con multitud de complementos para auto-generar código rápidamente.

### 5.4.2. Herramientas mecánicas

Fresadora PCB LPKF ProtoMat S103 - Utilizada para obtener las placas de circuito impreso utilizadas en el Proyecto.

## 5.5. Otras referencias

### 5.5.1. Repositorio en GitHub

Tanto la documentación como el código fuente asociado descrito en este documento, están alojados en GitHub, disponibles en https://github.com/raudiez/tfg.

# 6. Definiciones y Abreviaturas

AAL Ambient Assisted Living (Vida Asistida en la Vivienda).

Arduino Plataforma electrónica de hardware libre de fácil uso, utilizada normalmente para el montaje de dispositivos multifuncionales.

MEMORIA

AWG American Wire Gauge, es una escala de medidas o calibres para conductores eléctricos adoptada como estándar. Es necesario utilizar una tabla de equivalencias [43] para encontrar la correspondencia en diámetro de cable entre AWG y mm.

Bluetooth Especificación industrial para WPAN que posibilita la transmisión de datos entre diferentes dispositivos con corto alcance.

Domótica Conjunto de sistemas capaces de automatizar una vivienda.

Ethernet Estándar de red local para computadores (IEEE 802.3).

GPIO General Purpose Input/Output (Entrada/Salida de Propósito General).

IDE Integrated Development Environment, o Ambiente de Desarrollo Integrado, es una herramienta software que proporciona servicios integrales en el desarrollo software.

IEEE Institute of Electrical and Electronics Engineers (Instituto de Ingeniería Eléctrica y Electrónica).

JSON JavaScript Object Notation, es un formato de texto ligero para el intercambio de datos, muy simple y extendido, y representa la estructura de los datos en el propio texto.

Metodología Una metodología es el conjunto de pasos, procedimientos, técnicas, herramientas y el soporte documental que ayudan a desarrollar un producto.

LAN Local Area Network (Red de Área Local).

PAN Personal Area Network (Red de Área Personal).

PCB Printed Circuit Board (Placa de Circuito Impreso).

Piconet Red informática cuyos nodos se conectan utilizando Bluetooth. Puede constar de 2 a 7 dispositivos.

Raspberry Pi Computador embebido de bajo coste desarrollado en Reino Unido por la Raspberry Pi Foundation.

REST Representational State Transfer, es un estilo de arquitectura software para sistemas hipermedia distribuidos, y describe cualquier interfaz entre sistemas que utilice directamente métodos HTTP (GET, POST, PUT y DELETE) realizar operaciones con datos.

WEP Wired Equivalent Privacy (Privacidad Equivalente a Cableado).

WiFi WiFi (o Wi-Fi) es el nombre de una marca comercial de Wi-Fi Alliance, definido como cualquier producto basado en conexión WLAN que cumple con el estándar IEEE 802.11. Comúnmente se confunde con ese estándar, IEEE 802.11.

WLAN Wireless Local Area Network (Red de Área Local Inalámbrica).

WPA Wi-Fi Protected Access (Acceso Wi-Fi Protegido).

WPAN Wireless Personal Area Network (Red de Área Personal Inalámbrica).

MEMORIA

# 7. Requisitos Iniciales

A partir de la encuesta realizada, disponible en el apartado 23, junto con información facilitada por el Cliente, se obtienen los requisitos iniciales del Proyecto:

Se deben detectar las llamadas de timbre.

Se deben detectar las llamadas de telefonillo.

Alertar de los avisos mediante luces de distintos colores.

Conectar smartphones Android al sistema de avisos.

Notificar las alertas en smartphones Android.

Estos requisitos se exponen de una manera más detallada en el apartado 23, “Especificaciones del Sistema”.

# 8. Alcance

El alcance de este proyecto engloba los siguientes puntos:

Desarrollo de la especificación de requisitos del sistema y su análisis.

Diseño de la arquitectura general del sistema.

Diseño de la interfaz de conexión entre los dispositivos generadores de alertas y los nodos informativos visuales.

Elección de la tecnología de comunicación a emplear en el sistema.

Implementación del software del sistema.

Implementación del sistema con dos nodos informativos visuales como demostración.

# 9. Estudio de Alternativas y Viabilidad

Para la realización del Proyecto, se han tenido en cuenta diversas alternativas para los diferentes aspectos del Proyecto, ya sea la plataforma a utilizar para la recogida de datos de los generadores de alertas, la forma de generar las alertas visuales o la comunicación entre los diferentes elementos que engloben el sistema, entre otros.

Por ello se analizarán en distintos apartados las alternativas para cada caso.

MEMORIA

## 9.1. Nodos informativos visuales

Teniendo claro a raíz del estudio de requisitos y de los resultados obtenidos en las encuestas realizadas, disponible en el apartado 23, los elementos principales que conformarán las alertas visuales serán luces RGB, a modo de bombillas de rosca E27 de acuerdo con los requisitos no funcionales NFR-01 y NFR-03, que puedan ser fácilmente implantadas en una vivienda real; y algún smartphone Android que conectar al sistema, de acuerdo con el requisito no funcional NFR-02, que recibirá las alertas en forma de notificación de texto.

Se analizaron por tanto las principales bombillas LED del mercado que fuesen controlables mediante alguna tecnología de red, para poder comunicar estas con el nodo central de recogida y envío de información. Las bombillas tenidas en cuenta fueron las que se muestran en la tabla 9.1.

Modelo | Color | Comunicación | Precio | Observaciones
Philips Hue [25] | RGB | Puente- bombillas: ZigBee
Conexión | a
| | puente median- te Ethernet | Starter Kit: 199.95 e [3] Bombilla E27: 52.99 e [2] | El puente no se vende por sepa- rado, es necesario adquirir el Starter Kit.
Belkin | We-
Mo [7]

Blanco Puentebombillas:
ZigBee
Conexión a
puente mediante WiFi

Starter Kit: 99.90 e [9]
Bombilla E27: 29.99 e [8]

El puente no se
vende por separado, es necesario
adquirir el Starter
Kit.

LimitLessLED
[21]
RGB | Puente-
bombillas:
WiFi
Conexión a
puente mediante WiFi

Starter Kit: 62.45 e [22]
Bombilla E27: 20.82 e
[19]
Puente: 17.65 e [20]

Puente disponible
por separado.

Tabla 9.1: Comparativa de bombillas LED

Ya sea a través de ZigBee o WiFi, queda claro observando la tabla que las 3 opciones de bombillas disponibles requieren de un puente inalámbrico al que conectar, que será el controlador principal de las bombillas y su estado. En todo caso, estos puentes deben ir conectados a través de red local al nodo central que manejará las alertas, ya sea mediante WiFi o cable Ethernet.

MEMORIA

## 9.2. Conexión nodo central-smartphone

Como se ha comprobado, en el sistema se debe contemplar el uso de un smartphone Android que reciba las mismas alertas a modo de texto, para que el usuario pueda recibir las alertas de varias formas, pudiendo no estar atento a las luces de la vivienda o pudiendo tenerlas apagadas.

Será necesario por tanto conectar de alguna forma este dispositivo al sistema. Existen en esencia 2 alternativas para ello:

Conexión mediante red WiFi (IEEE 802.11).

Conexión mediante Bluetooth.

Para la primera opción, teniendo en cuenta que las bombillas utilizadas también requerirán conexión de red, lo más apropiado será utilizar un router WiFi con capacidad para varias conexiones Ethernet. De este modo, el nodo central podrá conectarse al router WiFi ya sea mediante WiFi o cable Ethernet, y a su vez estarán conectados también al router el puente controlador de las bombillas, y el smartphone Android.

Para la segunda opción, será necesario que el nodo central cuente con algún dispositivo de comunicación Bluetooth, mediante el cual enviar las alertas al smartphone Android.

### 9.2.1. Bluetooth

El Bluetooth es un tipo de red WPAN de los más utilizados en el mercado. Cualquier smartphone Android cuenta hoy día con conexión Bluetooth. Aunque la distancia que cubre es relativamente pequeña (10 metros normalmente, hasta 100 metros utilizando repetidores), el objetivo de esta tecnología es sustituir los cables de interconexión entre dispositivos, objetivo que cumple porque la mayoría de estas conexiones no superan los 10 metros de distancia.

### 9.2.1.1. Especificaciones técnicas

Las especificaciones técnicas principales del estándar Bluetooth de interés para este proyecto se recogen en la tabla 9.2.

Banda de Frecuencia | 2,4 GHz.
Velocidad de datos | Hasta 721 kbps por piconet.
Distancia máxima | 10 m.

Tabla 9.2: Especificaciones técnicas principales de interés del estándar Bluetooth.

### 9.2.1.2. Seguridad

Bluetooth define tres niveles de seguridad:

No seguro: no se emplea ningún mecanismo de seguridad.

Seguridad a nivel de servicio: permiso concedido por servicio (se puede acceder a un servicio pero no al resto).

MEMORIA

Seguridad a nivel de enlace: requiere de autenticación y autorización del dispositivo al que desea conectarse.

El último es el nivel más seguro y el más extendido en la actualidad.

### 9.2.1.3. Aplicaciones

Las características del estándar Bluetooth hacen de esta conexión adecuada para:

Conexión a otras redes a través de otro dispositivo que funcione como punto de acceso.

Conexión entre periféricos y dispositivos, sustituyendo el cable por un enlace inalámbrico.

Conexión entre dispositivos para transferencia de datos y sincronización.

En resumen, una conexión Bluetooh es apta para cualquier conexión entre dispositivos que no requiera un gran alcance (10 metros).

### 9.2.2. WiFi (IEEE 802.11)

Aunque comúnmente conocido como WiFi (o Wi-Fi), el estándar IEEE 802.11 es un conjunto de especificaciones que implementan WLAN en las bandas de frecuencia 2.4 GHz, 3.6 GHz, 5 GHz y 60GHz. Inicialmente, Wi-Fi es el nombre de una marca comercial de la WECA (actualmente Wi-Fi Alliance), organización comercial que aprueba y certifica que los dispositivos de comunicación WLAN cumplen con el estándar IEEE 802.11. Actualmente, la misma Wi-Fi Alliance define “Wi-Fi” como cualquier producto basado en conexión WLAN que cumple con ese estándar IEEE 802.11. Aún así, es tan extendido el uso de la palabra “WiFi” que resulta raro hablar del estándar. En este documento, cuando se emplee la palabra “WiFi”, se referirá a una red WLAN que cumpla con el estándar IEEE 802.11.

La distancia que es capaz de cubrir es bastante amplia (si el dispositivo cumple con 802.11g u 802.11n), pudiendo llegar hasta los 100 metros con facilidad.

### 9.2.2.1. Especificaciones técnicas

Las especificaciones técnicas principales del estándar 802.11n (utilizado actualmente) de interés para este proyecto se recogen en la tabla 9.3.

Banda de Frecuencia | 2,4 GHz y 5 GHz.
Velocidad de datos | Hasta 150 Mbps.
Distancia máxima | 70 m en interior, 250 m en exterior.

Tabla 9.3: Especificaciones técnicas principales de interés del estándar IEEE 802.11n.

### 9.2.2.2. Seguridad

Actualmente existen varias formas de securizar una red WiFi, entre las que destacan:

Sin seguridad: Red abierta, sin necesidad de autenticar el dispositivo a conectar.

MEMORIA

WEP: Cifrado muy común en los inicios de esta tecnología, se compone de claves de entre 64 y 128 bits. Cada cierto tiempo, el dispositivo conectado envía parte de la clave al dispositivo que genera la conexión de red, para verificar que está conectado a la red. Esto supone una brecha importante de seguridad.

WPA: Cifrado que mejora a su predecesor WEP, e incluye otras mejoras, generación dinámica de claves, y anticipa el entonces en desarrollo estándar IEEE 802.11i. Además palia los fallos de seguridad del cifrado WEP. Incrementa el tamaño de las claves y el número en uso e introduce un nuevo mensaje de control de integridad más seguro.

WPA2: Mejora de WPA, que cambia el esquema de encriptado utilizado por AES, por lo que mejora nuevamente en nivel de seguridad.

### 9.2.2.3. Aplicaciones

Gracias a sus características, y sobre todo a su amplia distancia máxima que cubre, hacen de esta tecnología adecuada para:

Conexión a otras redes a través de un dispositivo que funcione como punto de acceso.

Conexión entre periféricos, cada vez más extendido, gracias a la inclusión de chips con conexión WiFi en los dispositivos más modernos.

Conexión entre dispositivos para transferencia de datos, sincronización y creación de redes locales con otros fines.

En resumen, una conexión WiFi es apta para cualquier conexión entre dispositivos, con la posibilidad de abarcar una gran distancia (100 metros).

## 9.3. Plataforma para nodo central

El sistema deberá contar con un nodo central que maneje la información recibida, y genere las alertas necesarias, activando las alertas visuales mediante luces, y enviando las mismas alertas al smartphone Android. Este nodo central estará integrado en el sistema implementado en la vivienda, y no será visible ni accesible por el usuario final una vez instalado.

Por ello, se han tenido en cuenta dos alternativas: utilizar una placa Arduino, o usar una computadora Raspberry Pi.

### 9.3.1. Arduino

Arduino es una plataforma de hardware libre, basada en una placa con microcontrolador. En concreto, para este Proyecto se ha tenido en cuenta la placa Arduino Mega, al ser una de las placas Arduino con mayor capacidad de memoria flash programable.

La programación de estas placas es bastante sencilla, bastando con conectar la placa mediante su conector USB a un ordenador, y utilizar el entorno de desarrollo de Arduino (o cualquier editor que admita el uso de este entorno como plug-in) para escribir y cargar los programas en la placa.

MEMORIA

### 9.3.1.1. Características técnicas

La Arduino Mega está basada en el microcontrolador ATMega1280, es una de las de mayor tamaño, sus pines digitales operan con una corriente de 5 V y sus características principales son las reflejadas en la tabla 9.4 [4].

Pines I/O digitales | 54, de los cuales 15 proporcionan salida PWM.
Pines de entrada analógica | 16.
Memoria flash | 128 kB, de los cuales 4 kB son utilizados por el bootloader.
Alimentación | USB o conector jack, con voltaje máximo recomendado de entre 7 y 12 V.
Consumo | ∼ 50 mA, 0.3 W.

Tabla 9.4: Características técnicas principales de interés de Arduino Mega.

Las placas Arduino son cada vez más utilizadas en entornos donde el funcionamiento del sistema será siempre el mismo, sin desaprovechar así un sistema operativo interno ni funcionalidades extra no necesarias.

Además, Arduino cuenta con una gran variedad de placas adicionales para dotar a sus placas Arduino de características o conexiones que no están disponibles por defecto.

### 9.3.1.2. Estudio de viabilidad de la alternativa

Como paso previo a la solución final, se estudió la posibilidad de utilizar Arduino como nodo central del sistema para la solución del Proyecto. Por ello, es necesario tener en cuenta en este apartado la elección de solución para cada alternativa anteriormente mencionada, expuesta en el apartado 10.

Es necesario por tanto acoplar una Shield propia de Arduino a la Arduino Mega, para dotarla de conexión a la red. Existen dos alternativas: utilizar una Shield WiFi, o utilizar una Shield Ethernet. Con la segunda opción se asegura una conexión estable (cable). Además, la Shield WiFi ha sido descatalogada como producto oficial de Arduino, y ya no se le da soporte ni a la placa ni a la documentación sobre esta. Por tanto se utilizará una Shield Ethernet para conectar la Arduino a la red, y con ello conectar con el smartphone Android y con el puente Hue de Phillips.

La Shield Ethernet utilizada monta un chip Ethernet nuevo (WIZnet W5500) para el que, a fecha de realización de este estudio, Arduino no da soporte a través de su entorno de desarrollo, por lo que es necesario utilizar una librería del propio fabricante del chip [44].

Para la comunicación con el puente Philips Hue, es necesario realizar peticiones HTTP mediante una interfaz RESTful [24] (peticiones GET, PUT, POST y DELETE), de acuerdo además con el requisito no funcional NFR-04. El puente además gestionará las peticiones y dará como resultado a estas, respuestas en formato JSON, por lo que será necesario gestionar estas cadenas formateadas para poder obtener los datos necesarios facilitados por la interfaz del puente. De acuerdo a la API de Philips Hue, las peticiones y respuestas se dan únicamente en formato JSON, por lo que se hace obligatorio utilizarlo (requisito no funcional NFR-05). Arduino no cuenta entre las librerías de su entorno con ninguna herramienta para el manejo de cadenas JSON (parser de JSON),

MEMORIA

por lo que de entre todas las posibilidades existentes para el manejo de estas cadenas en lenguaje C/C++, se estudian dos alternativas posibles desarrolladas con licencia de software libre: utilizar la librería ArduinoJson desarrollada por Benoît Blanchon disponible en GitHub [10], o utilizar la librería aJson desarrollada por el equipo Interactive Matter disponible también en GitHub [18].

La primera librería, ArduinoJson, está más optimizada para su uso en placas Arduino, gestionando de mejor manera la corta memoria programable de la placa. La segunda, es una librería para manejo de cadenas JSON, desarrollada también para placas Arduino, pero sin optimizar tanto la memoria, sino centrándose en las funcionalidades. La segunda librería es más completa, pero la primera está más optimizada. Debido a la escasa memoria con la que cuenta Arduino, se decidió utilizar la librería ArduinoJson, para optimizar el uso de recursos de la placa.

Con Arduino además, al estar bastante limitado en lo que a memoria se refiere, se encuentran problemas al utilizar cadenas de caracteres en objetos de la clase String, los cuales consumen mucha memoria. Además, entre las implementaciones de la clase String con las que cuenta Arduino en su entorno de desarrollo, String es la más ligera de las implementaciones, contando además con WString o TextString dentro de las librerías del entorno. Esto hace que sea necesario utilizar variables de tipos más ligeros, como el tipo char, utilizando arrays dinámicos de este tipo.

Tras varias pruebas, se decidió además optar por usar una adaptación de la librería de software libre para el manejo de peticiones REST, RestClient [12], optimizando el uso de recursos de la librería, y cambiando el uso de variables de la clase String por arrays dinámicos de caracteres char. Esta librería modificada puede consultarse en el código asociado a este documento, disponible también en un repositorio en GitHub (apartado 5.5.1).

Para comprobar el uso de memoria que tenía el programa en la placa Arduino, se utilizó un sencillo código puesto a disposición en la web oficial de Arduino [5][23], el cual examina la memoria disponible restante de la placa.

#include <Ethernet.h>

#include <SPI.h>

#include "RestClient.h"

//https://github.com/bblanchon/ArduinoJson #include "ArduinoJson.h"
//http://playground.arduino.cc/Code/AvailableMemory #include "MemoryFree.h"
byte mac[]={ 0x90, 0xA2, 0xDA, 0x0F, 0xF9, 0x41 }; //MAC byte ip[] = { 192, 168, 2, 146 };//IP
const char* hueuser = "d3dede62b969c73f21574a17b7a8fb";

RestClient hue = RestClient("192.168.2.121");

StaticJsonBuffer<200> jsonBuffer;

void setup(){
Serial.print("Inicio - freeMemory()="); Serial.println(freeMemory());
Serial.begin(9600);
Ethernet.begin(mac,ip);
Serial.print("Tras conectar por ethernet - freeMemory()="); Serial.println(freeMemory());

MEMORIA

}

void loop(){
initHue();
Serial.print("freeMemory()="); Serial.println(freeMemory()); int n = getNumHueLights(); Serial.println(n);
delay(5000);

}

void initHue(){
hue.setContentType("application/json");

}

char* getHueList(){
char* response;
char* aux = new char[13+strlen(hueuser)]; strcpy(aux,"/api/");
strcat(aux,hueuser);
strcat(aux,"/lights");
const char* path = aux;
int status = hue.get(path, response); return response;

}

int getNumHueLights(){
char* json = getHueList();
Serial.print(json);
JsonObject& root = jsonBuffer.parseObject(json);
int num = 0;
for(JsonObject::iterator it=root.begin(); it!=root.end(); ++it) num++;

return num;

}

En el último programa de test realizado para Arduino, los resultados obtenidos seguían siendo desfavorables:

Al iniciar el programa, e inicializar la Shield Ethernet (sin realizar aún conexión con el puente), la función freeMemory() devolvía un resultado de 7198 B, ejecutando todo esto en la función setup() propia de Arduino.

Tras terminar la función setup(), y conectar con el puente Philips Hue, freeMemory() retornaba un valor de 6920 B.

Finalmente, al concluir toda una iteración de la función loop() (la primera iteración), freeMemory() devolvía un valor de 2560 B, habiendo ahora realizado una petición al puente para recibir un JSON con información sobre todas las bombillas conectadas, y contando estas bombillas para obtener el número que había de ellas (ya que no hay ninguna forma propia en la API para realizar esta operación).

Justo después, al realizar la segunda iteración del loop(), la ejecución quedaba parada con la placa Arduino bloqueada, necesitando realizar un reset a esta para que volviese a iniciar su ejecución.

MEMORIA

Tras dos meses de pruebas, corrección de errores y optimizaciones, y tras obtener estos resultados, esta solución fue descartada, debido a la gran falta de memoria de Arduino, que tenía que trabajar con grandes cadenas JSON de caracteres, dando paso a la solución final del Proyecto.

### 9.3.2. Raspberry Pi

Raspberry Pi es un computador embebido de bajo coste, el cual opera un sistema operativo GNU/Linux. En concreto, para este Proyecto se ha estudiado la posibilidad de utilizar una Raspberry Pi modelo B, al tener un rendimiento más que suficiente para la tarea que realizaría.

### 9.3.2.1. Características técnicas

La Raspberry Pi B, la versión más básica a la venta de Raspberry Pi con conexión Ethernet, cuenta con un procesador Broadcom BCM2835, un lector de tarjetas microSD en la cual se carga el sistema operativo y cuenta con las características mostradas en la tabla 9.5 [27].

Pines I/O digitales | 26 pines GPIO.
Pines de entrada analógica | No.
Memoria | 512 MB de memoria RAM, sin memoria flash. Los programas se ejecutan bajo el sistema operativo GNU/Linux.
Alimentación | MicroUSB.
Consumo | 700 mA, 3.5 W.

Tabla 9.5: Características técnicas principales de interés de Raspberry Pi B.

Gracias a ejecutar un sistema operativo GNU/Linux completo, este ordenador embebido es bastante completo y potente, pudiéndose ejecutar casi cualquier tipo de código y programas en él. Los pines GPIO de Raspberry Pi operan a 3.3 V, y utilizar un mayor voltaje derivaría en la destrucción del bloque GPIO y el SoC.

### 9.3.2.2. Sistema operativo

Existen varias alternativas, como son ArchLinux ARM, Raspbian o Minibian; pero se decide instalar como sistema operativo ArchLinux ARM, siendo más ligero que las variantes basadas en la distribución GNU/Linux Debian, al incluir un sistema más limpio de serie, sin entorno de escritorio ni servicios externos ya incluidos. Cualquiera de los 3 sistemas puede utilizarse para este Proyecto, siendo Raspbian el más pesado.

En el anexo 20 se detalla el procedimiento de instalación de Arch Linux ARM en una Raspberry Pi B, además de la configuración del sistema y la instalación de las herramientas software necesarias.

## 9.4. Electrónica para la detección de alertas

Para la detección de la señal enviada por el telefonillo y el timbre, se han tenido en cuenta varias alternativas que surgen a raíz de la elección del tipo de telefonillo y de la necesidad de detectar las alertas generadas por este y por el timbre.

MEMORIA

La primera de las alternativas es utilizar un relé de 12 Vac con salida hasta 5 V para el telefonillo y un relé de 230 Vac con salida hasta 5 V para el timbre, teniendo la salida conectada directamente al nodo central, y detectando las llamadas a ambos.

La segunda alternativa propuesta es utilizar un conversor de 12 Vac a 5 V para el telefonillo y un relé de 230 Vac con salida hasta 5 V para el timbre, realizando un sistema basado en un regulador de tensión o utilizando un conversor ya implementado que se encuentre en el mercado para la detección de llamadas al telefonillo.

# 10. Descripción de la Solución Propuesta

Una vez vistas todas las alternativas para cada caso en el capítulo anterior, es necesario elegir las alternativas que se adapten más a la solución pretendida para este Proyecto.

## 10.1. Diseño de arquitectura de la solución

En la figura 10.1 se observa el diagrama de bloques del sistema. El timbre conecta con el nodo central a través de un sistema de interconexión. El telefonillo conecta de la misma manera con el nodo central, a través de otro sistema de interconexión. A su vez, el nodo central se conecta al smartphone y a los nodos informativos visuales a través de un sistema de comunicación. Es necesario considerar este diagrama de bloques a lo largo de la exposición de la solución propuesta, para entender todo el conjunto que conforma el sistema final.


Figura 10.1: Diagrama de bloques del sistema.

MEMORIA

## 10.2. Elección de los nodos informativos visuales

Teniendo en cuenta la tabla 9.1, a raíz del estudio de Requisitos dentro de las Especificaciones del Sistema [ 23], y sobre todo, de acuerdo con el requisito no funcional NFR-01, se busca utilizar bombillas capaces de generar luces de colores (RGB), la segunda alternativa mostrada en la tabla queda descartada, pues tan solo proporciona luz en distintos tonos de blanco (ya sea luz más cálida o más fría, y variaciones de luminosidad).

Además, la tercera opción expuesta podría resultar a primera vista la solución más económica, pues permite la compra por separado del puente que comunica con las bombillas, pero debido a ser compra en el extranjero, con importantes gastos de transporte, y la imposibilidad de facturar estos gastos a través de la universidad, se descarta también esta opción.

Queda claro por tanto que la opción elegida es la primera, utilizar las bombillas Hue de Philips. Estas bombillas utilizan un puente ZigBee-Ethernet, al que se conecta mediante cable Ethernet y se utiliza una interfaz propia para alterar el estado de las bombillas. Estas se controlan mediante métodos HTTP a través de una interfaz RESTful, los cuales deben recibir y generar cadenas en formato JSON, por lo que es necesario poder manipular estas cadenas de alguna manera.

## 10.3. Elección de dispositivo de interconexión de red

Se ha visto la necesidad de conectar un smartphone Android al sistema (según el requisito no funcional NFR-02), y la solución más acertada para la conexión de este dispositivo parece Wi-Fi, ya que como se ha visto, tiene mayor alcance que Bluetooth, pudiendo funcionar por tanto mucho mejor en el entorno del interior de una vivienda (teniendo en cuenta las paredes que se encuentran dentro de una vivienda).

Con Bluetooth, se tiene un alcance de 10 metros, 100 en condiciones óptimas (sin obstáculos) y mediante el uso de repetidores. Con WiFi, el alcance es mucho mayor, llegando a 70-100 metros en interior, y hasta 250 metros en condiciones óptimas (en exteriores). Siendo estas dos las únicas opciones de conexión posibles para un smartphone Android, queda descartado el uso de Bluetooth, eligiendo así utilizar WiFi como medio de comunicación.

Es necesario por tanto el uso de un punto de acceso WiFi al que el smartphone Android pueda conectar, comunicando así el smartphone y el nodo central. Además, para la conexión del nodo central con el puente Hue utilizado para la comunicación con las bombillas elegidas, es necesario el uso de un dispositivo que realice la función de un switch Ethernet. Debido a estas necesidades y teniendo en cuenta lo expuesto en el apartado 4.1.4 del Informe de Diagnóstico, en el que se explica que habitualmente dentro de una vivienda se cuenta con un dispositivo que cumple con estas características (un router integrado)[13], se decide utilizar este dispositivo para la interconexión de los tres sistemas: el nodo central, el smartphone y el puente Hue.

Tanto Arduino como Raspberry Pi, las dos opciones analizadas para utilizar como nodo central, pueden lograr conexión a la red mediante un latiguillo Ethernet como solución más simple, necesitando Arduino de una placa Ethernet para lograr la conexión.

MEMORIA

## 10.4. Elección del nodo central

Tras descartar Arduino como placa programable que funcionase como nodo central, se decidió continuar con la otra alternativa estudiada: utilizar una Raspberry Pi B como nodo central.

En la Raspberry Pi B se cuenta ya con interfaz de red Ethernet, por lo que no es necesario utilizar ninguna placa añadida. Además esta placa también cuenta con pines de entrada/salida programables, lo cual es indispensable para el desarrollo del Proyecto.

## 10.5. Aplicación para nodo central

Se utilizará Python como lenguaje de programación para los programas del sistema, lenguaje cada vez más utilizado en proyectos de este tipo en los que se necesita dotar a Raspberry Pi de funcionamiento junto a sensores y otros sistemas hardware. Además, Python incluye librerías que permiten manejar cadenas JSON, establecer comunicaciones mediante peticiones HTTP, y más. Se utilizará la implementación 2.7 de Python, con soporte para todas las librerías necesarias en el Proyecto, como son las de manejo de direcciones URL.

Es necesario además instalar en el sistema operativo la librería RPi.GPIO, librería externa facilitada por Python para el manejo de los pines GPIO de Raspberry Pi, necesario para la lectura del estado de los relés empleados para la detección de llamadas al telefonillo o al timbre.

### 10.5.1. Librerías desarrolladas

Se ha desarrollado por tanto un conjunto de programas que sean capaces de comunicarse con el puente Philips Hue mediante métodos REST y cadenas JSON (utilizadas tanto para parámetros como para respuestas del puente), detectar las alertas de las llamadas entrantes tanto de telefonillo como de timbre a través de los relés empleados para ello, y comunicarse con un dispositivo Android para replicar las mismas alertas, a modo de texto.

Se desarrollan para ello dos librerías en Python: una para el uso de métodos REST, y otra para el control del puente Philips Hue.

### 10.5.1.1. Librería RESTful

Para ello, se ha desarrollado en primer lugar una librería REST en Python, que facilita la comunicación de Raspberry Pi con el puente Philips Hue. Esta librería, implementada en un único fichero, cuenta con 4 métodos principales, que serán los utilizados por el usuario: get, post, put y delete. Cada uno de ellos recibe la dirección del dispositivo al que realizar la petición, el dato a utilizar en caso de que sea necesario (POST y PUT), y el tipo de contenido del mensaje, que en este caso será siempre texto formateado en JSON.

1 | import json
2 | import urllib
3 | import urllib2

MEMORIA

4 class RestObject:

5
6 | def get(self, url, data=None, content_type=’application/json’):
7 | return self._request(url, data, ’GET’, content_type)

8
9 | def post(self, url, data={}, content_type=’application/json’):
10 | return self._request(url, data, ’POST’, content_type)

11
12 | def put(self, url, data={}, content_type=’application/json’):
13 | return self._request(url, data, ’PUT’, content_type)

14
15 | def delete(self, url, data=None, content_type=’application/json’):
16 | return self._request(url, data, ’DELETE’, content_type)

Además, la misma clase de la librería cuenta con un método genérico privado el cual utilizan las 4 funciones anteriores. Este método es el verdadero encargado de establecer la conexión con el dispositivo deseado, y realizar la petición REST proporcionando además los datos que sean necesarios, y recogiendo la respuesta proporcionada por el dispositivo en formato JSON.

1 | def _request(self, url, data, method, content_type):
2 | if ((data or isinstance(data, dict)) and method not in (’GET’,’DELETE’)):
3 | # "data" is defined or is an instance of "dict" type.
4 | data = json.dumps(data)
5 | if (method == ’PUT’):
6 | url_opener = urllib2.build_opener(urllib2.HTTPHandler)
7 | request = urllib2.Request(url, data=data)
8 | request.add_header(’Content-Type’, content_type)
9 | request.get_method = lambda: ’PUT’
10 | conn = url_opener.open(request)
11 | else: # (method == ’POST’)
12 | headers = {’Content-Type’: content_type}
13 | try:
14 | request = urllib2.Request(url, data, headers)
15 | conn = urllib2.urlopen(request)
16 | except TypeError:
17 | # POST without body.
18 | data = urllib.urlencode(data, 1)
19 | request = urllib2.Request(url, data, headers)
20 | conn = urllib2.urlopen(request)
21 | elif (method == ’DELETE’):
22 | url_opener = urllib2.build_opener(urllib2.HTTPHandler)
23 | request = urllib2.Request(url)
24 | request.get_method = lambda: ’DELETE’
25 | conn = url_opener.open(request)
26 | else: # (method == ’GET’)
27 | request = urllib2.Request(url)
28 | conn = urllib2.urlopen(request)
29 | response = conn.read()
30 | conn.close()
31 | try:
32 | content = json.loads(response)
33 | except:
34 | content = response
35 | return content

MEMORIA

Lo primero que hace este método es comprobar si hay datos entrantes, si los hay, los formatea como JSON mediante la librería propia de Python, y luego comprueba el tipo de petición (PUT o POST, las dos peticiones que pueden recibir datos entrantes).

Para efectuar el PUT, establece la conexión utilizando la dirección recibida, añade los datos a enviar, y la cabecera con el tipo de contenido. Finalmente realiza la petición. Por otro lado, para POST, se distinguen dos tipos: con y sin cuerpo del mensaje. Se realizan los mismos pasos, salvo que efectuando una petición POST.

En cambio, si no hay datos entrantes, la petición podrá ser GET o DELETE. Se realizan las mismas acciones que en el caso anterior, solo que sin incluir datos en la petición. Finalmente, se almacena la respuesta, se cierra la conexión y se devuelve la respuesta.

### 10.5.1.2. Librería Hue

Por otra parte, se ha creado una librería Python para el control del puente Philips Hue, así como de las bombillas asociadas a él. Gracias a esta librería, se evita utilizar la interfaz web propia del puente, que únicamente debe utilizarse como herramienta para desarrolladores, en concreto para depuración y pruebas. Esta librería se divide en tres clases:

Bridge: clase principal, de la que se debe crear un objeto para poder utilizar el sistema. Contendrá información como el usuario del puente Philips Hue a utilizar, o la dirección IP del mismo.

Light: clase que implementa todas las funciones necesarias para el control de las bombillas, como obtener su estado o modificarlo.

Config: clase que contiene funciones necesarias para la configuración del puente Philips Hue desde el mismo programa, sin necesidad de acceder a la interfaz web de depuración.

Estas clases están repartidas en distintos archivos.

### 10.5.1.2.1. Clase Bridge

La clase principal de la librería está implementada en el fichero __init__.py del paquete de la librería, siguiendo las directrices de Python para la implementación de clases, métodos y otras funciones que se deseen ejecutar como inicialización de las librerías o paquetes creados. Esta clase principal, Bridge, cuenta únicamente con un constructor.

1 class Bridge():

2
3 | def __init__(self, device, user):
4 | from config import Config
5 | from light import Light

6
7 | self.config = Config(device, user)
8 | self.light = Light(device, user)

9
10 | # After create Light object, search for new lights.
11 | self.light.findNewLights()

MEMORIA

El constructor recibe la dirección IP del puente y el nombre del usuario del puente a utilizar, crea un objeto de cada una de las otras clases, Config y Light, utilizando estos parámetros; y busca en la misma inicialización bombillas que hayan sido recientemente instaladas en la vivienda, para asociarlas al puente Hue.

### 10.5.1.2.2. Clase Config

La clase Config únicamente contiene 3 métodos relacionados con la configuración y estado del puente. Esta clase además, utiliza la librería REST anteriormente expuesta, para la comunicación con el puente.

1
2 from libs.rest import RestObject

3
4 class Config:

5
6 | def __init__(self, bridge, user):
7 | self.bridge = bridge
8 | self.user = user

9
10 | def isConnected(self):
11 | rest_obj = RestObject()
12 | path = ’api/{username}’.format(username=self.user[’name’])
13 | url = ’http://{bridge_ip}/{path}’.format(bridge_ip=self.bridge[’ip’], path=path)
14 | response = rest_obj.get(url)
15 | response = dict(resource=response)
16 | if ’lights’ in response[’resource’]:
17 | return True
18 | elif ’error’ in response[’resource’][0]:
19 | error = response[’resource’][0][’error’]
20 | if error[’type’] == 1:
21 | return False

Obviando el constructor, el cual es trivial, el primero de los métodos es un observador que comprueba si se puede conectar al puente con el usuario dado, o por el contrario, es un usuario no autorizado a utilizar dicho dispositivo. Este método realiza una petición GET a la dirección “http://IP_PUENTE/api/USUARIO”, recibiendo como respuesta una cadena JSON con toda la configuración del puente si el usuario está autorizado, o un error si el usuario no está dentro de la lista de usuarios autorizados a realizar operaciones con el puente.

1 | def createUser(self, user):
2 | rest_obj = RestObject()
3 | url = ’http://{bridge_ip}/api’.format(bridge_ip=self.bridge[’ip’])
4 | resource = {’devicetype’: user, ’username’: user}
5 | response = rest_obj.post(url, resource)
6 | return dict(resource=response)

El segundo método recibe una cadena con el nombre de un nuevo usuario, y crea un usuario en el puente con ese nombre. De nuevo, utilizando peticiones REST, en concreto POST, se realiza la operación, resultando una cadena JSON que informará si la operación se ha realizado con éxito.

MEMORIA

1 | def deleteUser(self, user):
2 | rest_obj = RestObject()
3 | service = ’config/whitelist/{id}’.format(id=user)
4 | path = ’api/{username}/{service}’.format(username=self.user[’name’], service=
| service)
5 | url = ’http://{bridge_ip}/{path}’.format(bridge_ip=self.bridge[’ip’], path=path)
6 | response = rest_obj.delete(url)
7 | return dict(resource=response)

Por último, el tercer método realiza justo lo contrario que el anterior: elimina un usuario de la lista de usuarios autorizados a utilizar el puente, recibiendo como parámetro el nombre del usuario a eliminar. Mediante una petición DELETE a la dirección necesaria, se elimina ese usuario, y se devuelve información relativa al resultado de la operación.

### 10.5.1.2.3. Clase Light

La última clase de la librería Python para Hue es Light. Esta clase implementa las funciones necesarias para controlar las bombillas Hue, como son obtener el estado de las bombillas, el número de bombillas conectadas, el estado de una bombilla individual, encontrar nuevas bombillas que conectar al puente Hue, y diversos modificadores de su estado.

1 from libs.rest import RestObject

2
3 class Light:

4
5 | def __init__(self, bridge, user):
6 | self.bridge = bridge
7 | self.user = user

8
9 | def get(self, resource={’which’:’all’}):
10 | rest_obj = RestObject()
11 | services = {
12 | ’all’:{’service’:’lights’},
13 | ’new’:{’service’:’lights/new’}
14 | }
15 | if (isinstance(resource[’which’], int)):
16 | resource[’id’] = resource[’which’]
17 | resource[’which’] = ’one’
18 | if (resource[’which’] == ’one’):
19 | services[’one’] = {’service’:’lights/{id}’.format(id=resource[’id’])}
20 | service = services[resource[’which’]][’service’]
21 | path = ’api/{username}/{service}’.format(username=self.user[’name’], service=
| service)
22 | url = ’http://{bridge_ip}/{path}’.format(bridge_ip=self.bridge[’ip’], path=path)
23 | response = rest_obj.get(url)
24 | if service == ’lights’:
25 | lights = []
26 | for (k, v) in response.items():
27 | v[’id’] = int(k)
28 | lights.append(v)
29 | response = lights
30 | return dict(resource=response)

MEMORIA

Al igual que en la clase Config, el constructor es bastante trivial. El primer método de interés que se encuentra es get, el cual se encarga de obtener del puente Philips Hue la información de todas las bombillas conectadas, las nuevas, o una única bombilla determinada, dependiendo de la información que reciba como parámetro. Una vez controlado de qué bombilla o bombillas debe obtener la información, realiza una petición GET, y devuelve el resultado de esta operación, exceptuando si debe obtener información de todas las bombillas, caso en el que reagrupa la información de las bombillas en un vector de bombillas (vector de información de cada una de las bombillas).

1 | def getNumLights(self):
2 | rest_obj = RestObject()
3 | path = ’api/{username}/lights’.format(username=self.user[’name’])
4 | url = ’http://{bridge_ip}/{path}’.format(bridge_ip=self.bridge[’ip’], path=path)
5 | response = rest_obj.get(url)
6 | lights = []
7 | for (k, v) in response.items():
8 | v[’id’] = int(k)
9 | lights.append(v)
10 | return len(lights)

El método getNumLights se basa en el método anterior, y a diferencia de este no recibe parámetros. Este método realiza directamente una petición GET para obtener el estado de todas las bombillas conectadas al puente, para después transformar la respuesta en un vector de bombillas, y finalmente devolver la longitud de ese vector (o lo que es lo mismo, el número de bombillas).

1 | def getLightState(self, light):
2 | return self.get({’which’:light})[’resource’][’state’]

3
4 | def isPhisicallyOn(self, light):
5 | return self.get({’which’:light})[’resource’][’state’][’reachable’]

Los siguientes métodos, getLightState y isPhisicallyOn reciben como parámetro el número identificador de una bombilla, y utilizan internamente el método get expuesto anteriormente. El primero, filtra la salida de get, devolviendo únicamente el campo state del JSON generado. El segundo, hace lo mismo y además se queda solo con el parámetro reachable de state, el cual determinar si una bombilla está encendida físicamente o no (y no a través del puente Hue).

1 | def findNewLights(self):
2 | rest_obj = RestObject()
3 | path = ’api/{username}/lights’.format(username=self.user[’name’])
4 | url = ’http://{bridge_ip}/{path}’.format(bridge_ip=self.bridge[’ip’], path=path)
5 | response = rest_obj.post(url)
6 | return dict(resource=response)

La función findNewLights realiza una operación parecida a get, cambiando que ejecuta una petición POST en lugar de GET. El resultado de realizar POST a la misma dirección mediante la cual se obtiene información de todas las bombillas con get, es buscar nuevas bombillas pendientes de conectar al puente, y asociarlas automáticamente a este.

MEMORIA

1 | def update(self, resource):
2 | rest_obj = RestObject()
3 | if (resource[’data’].has_key(’attr’)):
4 | service = ’lights/{id}’.format(id=resource[’which’])
5 | data = resource[’data’][’attr’]
6 | elif (resource[’data’].has_key(’state’)):
7 | service = ’lights/{id}/state’.format(id=resource[’which’])
8 | data = resource[’data’][’state’]
9 | else:
10 | raise Exception(’Unknown data type.’)
11 | path = ’api/{username}/{service}’.format(username=self.user[’name’], service=
| service)
12 | url = ’http://{bridge_ip}/{path}’.format(bridge_ip=self.bridge[’ip’], path=path)
13 | response = rest_obj.put(url, data)
14 | return dict(resource=response)

Utilizado por los modificadores de estado como método base, el método update es un método genérico para modificar el estado de una bombilla conectada al puente Hue. Este método recibe un dato, y dependiendo de si ese dato es interno al parámetro attr o state de la bombilla, realiza la petición POST a distintas URL, junto al dato que se ha proporcionado. El resultado de este método es la modificación del estado de la bombilla, además de devolver información sobre la operación realizada.

1 | def setLightColor(self, light, bri, hue, sat):
2 | resource = {
3 | ’which’:light,
4 | ’data’:{’state’:{’bri’:bri,’hue’:hue,’sat’:sat}}
5 | }
6 | return self.update(resource)

7
8 | def setLightState(self, light, on, bri, hue, sat, xy):
9 | resource = {
10 | ’which’:light,
11 | ’data’:{’state’:{’on’:on,’bri’:bri,’hue’:hue,’sat’:sat, ’xy’:xy}}
12 | }
13 | return self.update(resource)

14
15 | def setLightOn(self, light):
16 | resource = {
17 | ’which’:light,
18 | ’data’:{’state’:{"on":True}}
19 | }
20 | return self.update(resource)

21
22 | def setLightOff(self, light):
23 | resource = {
24 | ’which’:light,
25 | ’data’:{’state’:{"on":False}}
26 | }
27 | return self.update(resource)

Los últimos métodos de la clase, los modificadores de estado, son bastante simples, al utilizar internamente el método update genérico anterior. setLightColor recibe el identificador de una bombilla y los parámetros relacionados con el color, y realiza un update para modificar

MEMORIA

estos parámetros. setLightState realiza lo mismo y además, modifica también si la bombilla quedará encendida o apagada, recibiendo este atributo de estado como parámetro. Por otra parte, setLightOn y su contrapartida, setLightOff sirven para alterar el estado de encendido de la bombilla: encenderla y apagarla, respectivamente.

### 10.5.2. Programa principal

El programa principal del nodo central utiliza las librerías anteriores para conectar con el puente Philips y controlar las bombillas. Este programa además utiliza también varias librerías de Python como son socket, sys, threading, y la librería externa RPi.GPIO, entre otras.

### 10.5.2.1. Cabecera del programa y definición de variables globales

1 | ##########################
2 | # Configurable zone:
3 | USERNAME = ’ucahueuser’
4 | DING=17
5 | INTERCOM=18
6 | LANG=’es’
7 | # End of configurable zone.
8 | ###########################

9
10 | # GPIO setup:
11 | GPIO.setmode(GPIO.BCM)
12 | GPIO.setwarnings(False)
13 | GPIO.setup(DING,GPIO.IN)
14 | GPIO.setup(INTERCOM,GPIO.IN)

15
16 | # Used colors:
17 | RED=0
18 | BLUE=46920

19
20 | # Global vars without initial value:
21 | data=""
22 | bridge=None
23 | sock=None

24
25 | # Command to discover Philips Hue bridge’s IP.
26 | cmd = ’repeat_scan=true ; while ($repeat_scan); do hue_ip=$(ip route show|grep \’src
| \’|egrep -o \’([0-9]{1,3}\.){3}[0-9]{1,3}/[0-9]{1,2}\’|xargs arp-scan|grep -i "
| Philips Lighting"|awk \’{print $1}\’) ; if [ "$hue_ip" != "" ]; then repeat_scan
| =false ; echo $hue_ip ; sleep 2 ; fi ; done’

27
28 | # Messages vars:
29 | MSG_LINK = ""
30 | MSG_LINK_ES ="Presiona el botón del puente Hue."
31 | MSG_LINK_EN ="Press the button on the Hue bridge."
32 | MSG_DING = ""
33 | MSG_DING_ES = "Alguien llama al timbre."
34 | MSG_DING_EN = "Somebody rings the bell."
35 | MSG_INTERCOM = ""
36 | MSG_INTERCOM_ES = "Alguien llama al telefonillo."
37 | MSG_INTERCOM_EN = "Somebody calls the intercom."

En la primera parte del programa, se definen varias variables utilizadas a lo largo de este. Las

MEMORIA

cuatro primeras variables pueden modificarse, definiéndose en ellas el nombre de usuario a utilizar para conectar al puente, el idioma de los mensajes enviados al smartphone (español o inglés), y el número de los pines GPIO a los que se conectarán las señales del telefonillo y el timbre.

El resto de variables definidas son variables de cadenas de caracteres en los distintos idiomas, el identificador Hue de los colores a utilizar para mostrar las alertas mediante las bombillas, la configuración de los pines GPIO, y el comando a utilizar para descubrir la dirección IP asociada al puente Hue de manera automática. Este último utiliza comandos de consola del sistema para obtener la dirección IP de la red a la que se está conectado mediante ip route show y varios grep (uno de ellos utilizando expresiones regulares para determinar el formato de la dirección IP), proporcionar ese comando a la herramienta de escaneo ARP arp-scan, la cual proporcionará la dirección IP de los dispositivos conectados a la red, filtrando por último el dispositivo de interés (el puente Philips Hue) para obtener únicamente su dirección IP mediante awk. Mientras no se obtenga la dirección del puente Hue como resultado y por tanto no se pueda conectar con él, el programa quedará iterando en estos comandos, a la espera de realizar la conexión.

### 10.5.2.2. Asociación de usuario al puente Philips Hue

1 | def linkUserConfig():
2 | global data
3 | created = False
4 | print MSG_LINK
5 | data = MSG_LINK
6 | while not created:
7 | response = bridge.config.createUser(USERNAME)[’resource’]
8 | if ’error’ in response[0]:
9 | if response[0][’error’][’type’] != 101:
10 | print ’Unhandled error creating configuration on the Hue’
11 | sys.exit(response)
12 | else:
13 | created = True

Entre los métodos de este programa se encuentra linkUserConfig, el cual se encarga de asociar el usuario configurado al puente Philips Hue si no estuviese ya creado y admitido dentro de la lista de usuarios con permisos para controlar el puente, mediante la función createUser de la clase Config.

### 10.5.2.3. Alerta mediante puente Philips Hue

1 | def lightAlert(alert_color):
2 | global bridge
3 | if not bridge.config.isConnected():
4 | print ’Unauthorized user’
5 | linkUserConfig()
6 | bridge.light.findNewLights()
7 | numlights = bridge.light.getNumLights()
8 | oldstate = dict()
9 | for i in range(1,numlights+1):
10 | oldstate[i] = bridge.light.getLightState(i)
11 | for i in range(1,4):
12 | for j in range(1,numlights+1):
13 | if bridge.light.isPhisicallyOn(j):

MEMORIA

bridge.light.setLightOn(j) bridge.light.setLightColor(j, 254, alert_color, 254) time.sleep(1)
for j in range(1,numlights+1):
if bridge.light.isPhisicallyOn(j):
bridge.light.setLightState(j, oldstate[j][’on’], oldstate[j][’bri’], oldstate[ j][’hue’], oldstate[j][’sat’], oldstate[j][’xy’])
time.sleep(0.3)
for j in range(1,numlights+1):
if bridge.light.isPhisicallyOn(j) and not oldstate[j][’on’]: bridge.light.setLightOff(j)
time.sleep(1)

El método para mostrar las alertas a modo de parpadeo de luces de colores en las bombillas es lightAlert, el cual recibe el identificador de color de la alerta y comprueba si el usuario tiene permisos de conexión al puente mediante el método isConnected de la clase Config. Si no los tiene, se utilizará el método linkUserConfig() de este mismo programa. Además, al igual que se realiza al principio de la ejecución del programa al crear el objeto Bridge, se comprueba si se pueden asociar nuevas bombillas al puente Hue, para tener control en todo momento sobre todas las bombillas al alcance del puente. Tras esto se realiza una serie de operaciones para almacenar el estado previo de todas las bombillas conectadas al puente (mediante el método getLightState de la clase Light), cambia su estado a uno de encendido y con el color suministrado mediante parámetro, y vuelve a colocar las bombillas en su estado anterior (teniendo en cuenta si alguna de ellas estaba anteriormente apagada). Esta operación se realiza varias veces para dar un efecto de parpadeo a la alerta.

### 10.5.2.4. Alerta mediante aplicación para smartphone

def sendAlertToAndroid():
while True:
global data
req, client_address = sock.recvfrom(1024) # get the request, 1kB max # Look in the first line of the request for a valid command
# The command should be ’http://server/getAlert’

match = re.match(’GET /getAlert’, req)
if match:
if data != "":
sock.sendto(data,(client_address[0],8081)) data = ""
else:
sock.sendto("",(client_address[0],8081))
else:
# If there was no recognised command then return a 404 (page not found) print "Returning 404"

sock.sendto("HTTP/1.1 404 Not Found\r\n",(client_address,8081))

El último de los métodos secundarios del programa principal, sendAlertToAndroid es el encargado de quedar a la espera de conexiones entrantes mediante el socket establecido en el método principal del programa. Si se recibe una petición, se controla que es una petición válida (deberá contener el texto “/getAlert”), y se envían los datos definidos en el programa hacia el smartphone, utilizando la dirección IP que realizaba la petición, y el puerto 8081. Si la petición no es válida, se generará un mensaje de error y se enviará de la misma manera.

MEMORIA

Es ya en la función main() donde se realizan los últimos ajustes e inicializaciones para que el sistema se ponga en marcha, y donde se desarrolla la ejecución principal del programa.

### 10.5.2.5. Método principal del programa

def main():
global data
global bridge
global sock

# UDP socket configuration:

sock = socket.socket(socket.AF_INET, socket.SOCK_DGRAM) sock.bind((’’, 8080))

# Gets Hue bridge’s IP and create an Bridge object.

HUE_IP = os.popen(cmd).read().strip()
bridge = Bridge(device={’ip’:HUE_IP}, user={’name’:USERNAME})

# Sets message vars.

if LANG == ’es’:
locale.setlocale(locale.LC_TIME, "es_ES.utf8") MSG_LINK = MSG_LINK_ES
MSG_DING = MSG_DING_ES
MSG_INTERCOM = MSG_INTERCOM_ES
else:
locale.setlocale(locale.LC_TIME, "") MSG_LINK = MSG_LINK_EN
MSG_DING = MSG_DING_EN
MSG_INTERCOM = MSG_INTERCOM_EN

t = threading.Thread(target=sendAlertToAndroid) t.start()
while True:
data = ""
if not GPIO.input(INTERCOM):
cad = MSG_INTERCOM
data = time.strftime(" %d/ %b %H: %M: %S")+" - "+cad lightAlert(RED)

if not GPIO.input(DING):
cad = MSG_DING
data = time.strftime(" %d/ %b %H: %M: %S")+" - "+cad lightAlert(BLUE)

En este método se crea un socket UDP en el puerto 8080, el cual será el encargado de recibir peticiones de nuevas alertas desde el smartphone, y enviar estas alertas hacia el dispositivo.

A continuación, se obtiene la dirección IP del puente Hue con la secuencia de comandos anteriormente descrita, y se crea un objeto de la clase Bridge (el cual creará a su vez una instancia de las clases Config y Light), para poder comunicar este programa con el puente. Tras ajustar las variables de mensajes al idioma seleccionado, se inicia un hilo que tendrá como objetivo el método sendAlertToAndroid().

MEMORIA

Una vez que está listo todo lo anterior, empieza la iteración sin pausa de la parte principal de este programa. Se comprueban los pines GPIO asociados al timbre y al telefonillo, con el objetivo de detectar alertas generadas por estos. De realizar una lectura positiva de alerta, se ejecuta la función lightAlert con el color asociado al tipo de alerta, estableciendo como parámetro la fecha y hora de la alerta, junto con una cadena de texto a mostrar en el smartphone.

### 10.5.3. Estructura final de ficheros

En la figura 10.2 se muestra la estructura final de directorios y ficheros del software implementado para el nodo central.

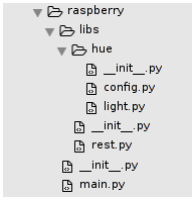
[picture p24: figure]

Figura 10.2: Estructura de directorios y ficheros del software del nodo central.

## 10.6. Elección de electrónica para la detección de alertas

Teniendo en cuenta la facilidad que supone el uso de relés y la sencillez de su montaje electrónico e inclusión en el sistema, se opta por esta opción.

### 10.6.1. Detección de alertas del telefonillo

Para la detección de alertas por parte del telefonillo, se utiliza un relé de 12 Vac para detectar las llamadas. Este relé se conecta, por la toma de entrada, a la salida del telefonillo (la salida de su interruptor) y a corriente eléctrica de 12 Vac. La salida del relé se conecta al nodo central (la Raspberry Pi), conectando un extremo a un pin GND del GPIO (en concreto el pin 9 de la numeración física [26]) y el otro, mediante resistencia de pull-up de 4,7 KΩ, al pin 18 GPIO (de numeración GPIO) y a una salida de corriente de 3,3 V (pin 17 de la numeración física [26]), tal como se observa en la figura 10.3.

### 10.6.1.1. Implementación

Para la implementación de este circuito en el sistema, se crea una placa de circuito impreso (PCB) con los componentes y conexionado necesario. El esquemático y el diseño del layout de

MEMORIA

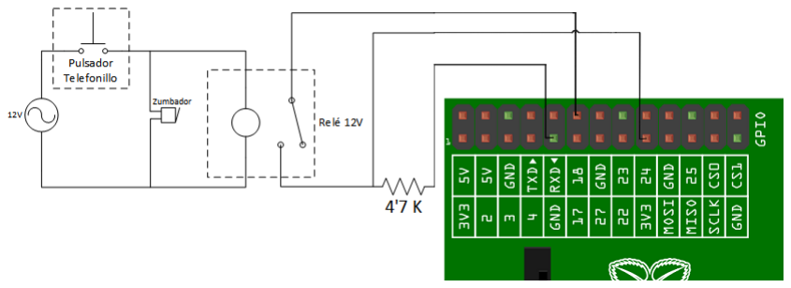
[picture p25: figure]

Figura 10.3: Diseño del circuito de interconexión telefonillo-nodo central.

esta PCB se encuentran en el documento de Planos, en los planos número 1 (apartado 15) y número 2 (apartado 16), respectivamente.

Teniendo en cuenta que el consumo del telefonillo no supera los 2 A de corriente, a un voltaje de 12 V, y utilizando una longitud de pistas de entrada al relé de 2 cm, se calcula que el ancho de las pistas que soporte esta tensión debe ser como mínimo de 780 µm.

Por otro lado, al conectarse esta PCB a los pines GPIO de Raspberry Pi, que generan una corriente de 3,3 V a 50 mA [15], y suponiendo que estas placas de circuito impreso se sitúen a una distancia estimada de 30 m de la Raspberry Pi, utilizando cableado de 20 AWG de diámetro se obtendría una caída de voltaje de 51,35 mV (1,56 %), lo que supone una caída de voltaje despreciable, obteniendo un voltaje final de entrada al pin GPIO de Raspberry Pi de 3,25 V.

### 10.6.2. Detección de alertas del timbre

Para la detección de las alertas producidas por llamadas al timbre, se utiliza un relé de 230 Vac. Este relé se conecta, por la toma de entrada, a la salida del timbre (la salida de su interruptor) y a corriente eléctrica de 230 Vac. A su vez, la salida del relé se conecta a la Raspberry Pi conectando un extremo a un pin GND del GPIO (en concreto el pin 6 de la numeración física [26]) y el otro, mediante resistencia de pull-up de 4,7 KΩ, al pin 17 GPIO (de numeración GPIO) y a una salida de corriente de 3,3 V (pin 1 de la numeración física [26]), tal como se observa en la figura 10.4.

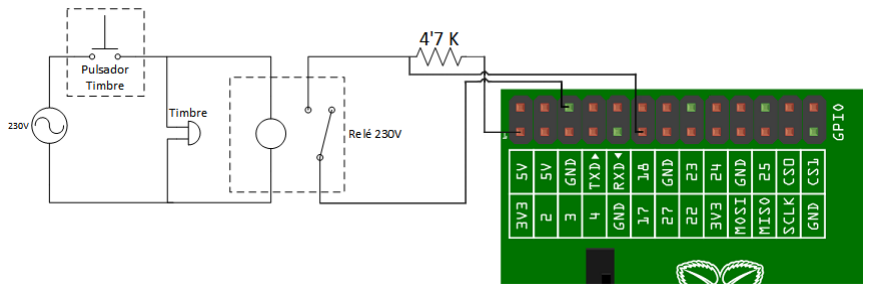
[picture p26: figure]

Figura 10.4: Diseño del circuito de interconexión timbre-nodo central.

MEMORIA

### 10.6.2.1. Implementación

Para la implementación de este circuito en el sistema, se crea una placa de circuito impreso (PCB) con los componentes y conexionado necesario. El esquemático y el diseño del layout de esta PCB se encuentran en el documento de Planos, en los planos número 3 (apartado 13) y número 4 (apartado 14), respectivamente.

Teniendo en cuenta que el consumo del timbre no supera los 0,2 A de corriente, a un voltaje de 220 V, y utilizando una longitud de pistas de entrada al relé de 2,5 cm, se calcula que el ancho de las pistas que soporte esta tensión debe ser como mínimo de 32 µm.

Por otro lado, el cálculo de caída de voltaje se realiza de la misma manera que para la placa anterior, y utilizando el mismo cableado resulta el mismo porcentaje de caída de voltaje, 1,56 %, suponiendo que la entrada del telefonillo a la vivienda también se sitúe a 30 m de la Raspberry Pi y por tanto se ubique ahí esta placa de circuito impreso.

## 10.7. Integración del sistema

Para la integración del sistema completo, el nodo central tendrá que comunicar con el resto de dispositivos y sistemas que conforman el sistema final, siendo el nodo central la Raspberry Pi, y los nodos subyacentes los sistemas de interconexión con el telefonillo y el timbre (de los que recibirá información el nodo central), el puente Philips Hue y el smartphone Android, con los que se comunicará a través del router integrado y se recibirá información además de enviar alertas hacia ellos.


Figura 10.5: Diagrama de integración del sistema con el nodo central.

Complementando este diagrama, en la figura 10.6 se puede observar el diseño final del sistema

MEMORIA

de forma detallada, incluyendo todos los elementos que lo conforman, una vez se ha definido el conexionado entre los sistemas de interconexión, el nodo central, el puente Philips Hue y el smartphone.

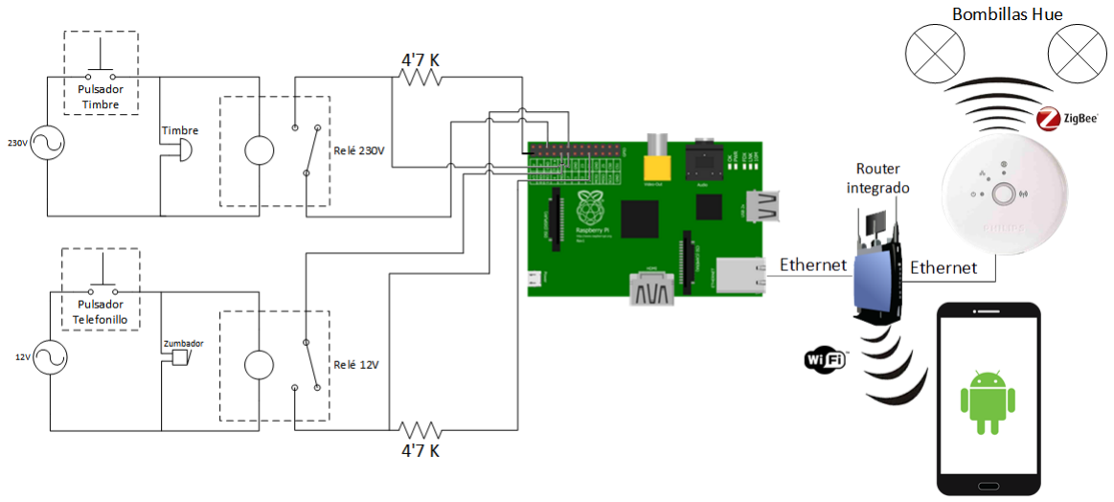
[picture p27: figure]

Figura 10.6: Diseño final de la arquitectura del sistema.

## 10.8. Aplicación para Android

### 10.8.1. Diseño de la aplicación

El diseño de la aplicación sigue las normas de diseño de Google, utilizando una interfaz basada en MaterialDesign. Tras realizar un diseño de prototipo, el cual se puede observar en el apartado 18.3, previo al uso del IDE Android Studio, se decide basar el estilo general de la aplicación en el predeterminado generado por Android Studio al utilizar MaterialDesign como base. En cada pantalla de la aplicación se encuentra la barra superior de la aplicación, ActionBar, en la que se encuentra el acceso al menú de configuración o el botón de vuelta a la pantalla anterior, según la vista en la que se encuentre el usuario. En la figura 10.7 se puede observar la pantalla principal de la aplicación.

MEMORIA


Figura 10.7: Pantalla principal de la aplicación para Android.

En esta pantalla principal se encuentra la lista de alertas recibidas desde el servidor de alertas (la Raspberry Pi), además de un texto que indica el estado de conexión o de alertas entrantes. Tal como se muestra en la figura 10.8, estas alertas pueden ser eliminadas a mano desde la propia aplicación, de tal manera que cuando el usuario pulsa en una de ellas, la aplicación mostrará un mensaje preguntando si se desea eliminar la alerta.


Figura 10.8: Borrado de alertas en aplicación para Android.

MEMORIA

Además de esta pantalla principal, la aplicación cuenta con un menú de configuración, fácilmente accesible mediante el menú desplegable superior, donde se puede configurar la dirección IP del servidor de alertas, tal y como se observa en la figura 10.9.

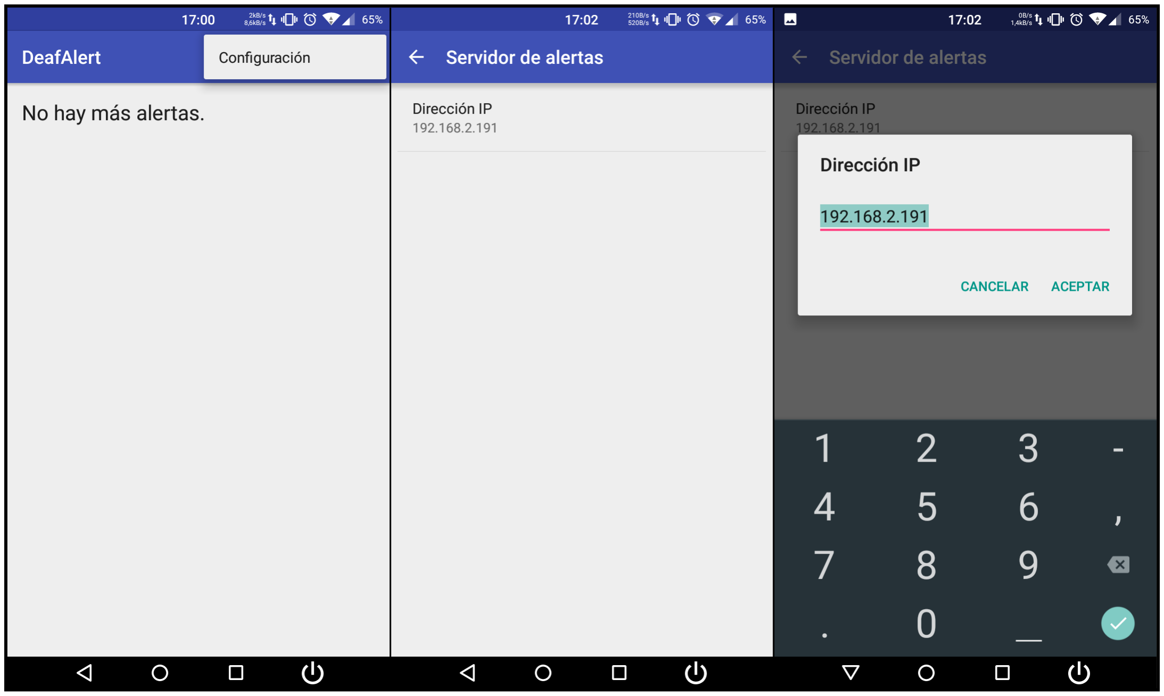
[picture p28: figure]

Figura 10.9: Menú de configuración de aplicación para Android.

### 10.8.2. Estructura software principal

La aplicación Android, desarrollada con el IDE Android Studio, se basa en tres clases java principales, divididas en archivos del mismo nombre:

MainActivity: Clase principal de la aplicación, encargada de construir la vista principal de la aplicación Android, y dar funcionalidad a la misma. Es además la encargada de comunicar con el nodo central, tratar las alertas y mostrarlas en la pantalla principal.

AlertListAdapter: Clase utilizada por MainActivity, para controlar la lista de alertas entrantes e ir refrescando la vista principal de la aplicación con esas alertas.

SettingsActivity: Clase generada por el propio IDE, la cual implementa el menú de configuración de la aplicación, modificada para dotar a la aplicación de un menú de configuración que se adapte a las necesidades.

Además de estas clases java, la aplicación cuenta con otra clase java más generada por Android Studio, la cual no se analizará, pues es código generado automáticamente.

### 10.8.2.1. Actividad principal

En la actividad principal (MainActivity) es donde se desarrolla la funcionalidad principal de la aplicación, y es la encargada de generar la vista principal de la misma (la vista a la que se accede una vez se abre la aplicación).

1 public class MainActivity extends AppCompatActivity {

2

MEMORIA

private InetAddress raspberryAddr; private ListView alertList;
private ArrayList<String> alerts; private AlertListAdapter alertAdapter; private TextView textRaspberry; private int NotifCount;
private boolean appIsInForegroundMode;

@Override
protected void onCreate(Bundle savedInstanceState) { super.onCreate(savedInstanceState); setContentView(R.layout.activity_main);
Toolbar toolbar = (Toolbar) findViewById(R.id.toolbar); setSupportActionBar(toolbar);
textRaspberry = (TextView) findViewById(R.id.textRaspberry); alertList = (ListView) findViewById(R.id.alertList);
alerts = new ArrayList<>();
alertAdapter = new AlertListAdapter(MainActivity.this, alerts); alertList.setAdapter(alertAdapter);
NotifCount = 0;
appIsInForegroundMode = false;
Timer timer = new Timer(); timer.scheduleAtFixedRate(new TimerTask() { @Override
public void run() {
printRaspberryData();

}
}, 0, 1500);
StrictMode.ThreadPolicy policy = new StrictMode.ThreadPolicy.Builder(). permitAll().build();
StrictMode.setThreadPolicy(policy);

}

Esta clase cuenta con varios atributos necesarios para almacenar la dirección IP del servidor de alertas, referencias a partes de la vista principal, una lista de cadenas que constituyen las alertas, un adaptador para estas alertas que será el encargado de refrescar las vistas, y otros atributos utilizados para control de notificaciones.

La función principal de la clase y por tanto de la actividad es el método onCreate, el cual se encarga de dotar de funcionalidad a la aplicación cuando la vista principal es cargada. Además de inicializar algunos de los atributos anteriormente citados con valores predeterminados establecidos en la aplicación, se establece un objeto AlertListAdapter asociado a la actividad y a la lista de alertas. Una vez que esto está hecho, se crea un objeto de la clase Timer, el cual se encarga de ejecutar un método determinado cada cierto periodo de tiempo. Este método es printRaspberryData, el cual se examinará más adelante.

Con todos los atributos inicializados y el Timer puesto en marcha, se establecen las políticas de la aplicación y se pone esta en funcionamiento.

private void printRaspberryData(){this.runOnUiThread(printAlerts);}

private Runnable printAlerts = new Runnable() {
@Override

MEMORIA

5 | public void run() {
6 | ConnectivityManager connManager = (ConnectivityManager) getSystemService(
| Context.CONNECTIVITY_SERVICE);
7 | NetworkInfo wifi = connManager.getNetworkInfo(ConnectivityManager.TYPE_WIFI
| );
8 | boolean stop = false;
9 | if (wifi != null && wifi.isConnected()) {
10 | SharedPreferences sharedPref = PreferenceManager.
| getDefaultSharedPreferences(MainActivity.this);
11 | String raspberry = sharedPref.getString("ip_address", getText(R.string.
| pref_default_ip_address).toString());

12
13 | DatagramSocket socket;
14 | try {
15 | raspberryAddr = InetAddress.getByName(raspberry);
16 | socket = new DatagramSocket(8081);
17 | socket.connect(raspberryAddr, 8080);
18 | if(socket.isConnected()){
19 | byte[] reqBuff = "GET /getAlert".getBytes();
20 | DatagramPacket reqPacket = new DatagramPacket(reqBuff, reqBuff.
| length, raspberryAddr, 8080);
21 | try {
22 | socket.send(reqPacket);
23 | } catch (IOException e) {
24 | e.printStackTrace();
25 | stop = true;
26 | textRaspberry.setText(getText(R.string.
| mainactivity_send_packet_error));
27 | }
28 | if(!stop) {
29 | boolean stop2 = false;
30 | byte[] recvBuff = new byte[1024];
31 | DatagramPacket recvPacket = new DatagramPacket(recvBuff,
| recvBuff.length);
32 | try {
33 | socket.receive(recvPacket);
34 | } catch (IOException e) {
35 | textRaspberry.setText(getText(R.string.
| mainactivity_no_data_error));
36 | e.printStackTrace();
37 | stop2 = true;
38 | }
39 | if (!stop2) {
40 | String cad = new String(recvPacket.getData(), 0, recvPacket
| .getLength());
41 | if (!cad.equals("")) {
42 | textRaspberry.setText(getText(R.string.
| mainactivity_conn_ok));
43 | alertAdapter.setData(cad);
44 | if (!appIsInForegroundMode) notifyAlertToNotification(cad
| );
45 | }else textRaspberry.setText(getText(R.string.
| mainactivity_no_data_error));
46 | }
47 | socket.close();
48 | }//stop
49 | }else{
50 | textRaspberry.setText(getText(R.string.mainactivity_conn_error));

MEMORIA

socket.close();

}
socket.close();
} catch (Exception e) {
textRaspberry.setText(getText(R.string.mainactivity_server_conn_error ));
e.printStackTrace();

}

} else {
textRaspberry.setText(getText(R.string.mainactivity_wifi_error));

}

}

};

El método printRaspberryData tiene un funcionamiento bastante sencillo, el cual se limita a establecer un objeto de tipo Runnable para el hilo principal de la interfaz de la aplicación.

Es en este objeto Runnable donde se desarrolla el funcionamiento principal de la aplicación. En él se establece el comportamiento del método run(), método asociado a cada ejecución del hilo. Lo primero que realiza este método es comprobar la conexión WiFi del dispositivo. Si este no está habilitado, muestra un mensaje de error y sale del método, esperando a la próxima ejecución de este método a raíz del Timer establecido en onCreate para comprobar de nuevo si la conexión WiFi ha sido habilitada.

Una vez el dispositivo cuente con conexión WiFi, se obtienen las preferencias almacenadas en el contenedor SharedPreferences de la aplicación. De estas preferencias se obtiene la dirección IP del servidor de alertas del que recibir las mismas.

A continuación, se crea un objeto DatagramSocket, un socket de conexión UDP, el cual se configura para conectar a la dirección del servidor de alertas (la Raspberry Pi) a través del puerto 8080. Además se establece el puerto de escucha de datos entrantes en el puerto 8081. Si la conexión se lleva a cabo correctamente, se realiza una petición con el dato asociado “GET /getAlert”, incluyendo este mensaje en un objeto DatagramPacket, paquete UDP que será enviado a través del socket.

Si el envío surte efecto, se crea un nuevo objeto DatagramPacket, pero esta vez no será enviado, sino que servirá para almacenar los datos entrantes. A continuación, el hilo queda a la espera de alguna conexión entrante a través del socket. Una vez hay datos entrantes, el paquete se almacena en el objeto creado anteriormente, se extrae el dato (la alerta), y se añade a la lista de alertas, mostrándola por pantalla a través del objeto AlertListAdapter. Además, se muestra un mensaje de conexión satisfactoria en la aplicación, y si la aplicación estuviera en segundo plano o el dispositivo se encontrase en modo reposo (bloqueado), se envía una notificación al sistema con la alerta entrante. El comportamiento del objeto AlertListAdapter, así como lo que ocurre con la lista de alertas, se tratan en el apartado 10.8.2.2.

@Override
protected void onResume(){ super.onResume();

MEMORIA

4 | appIsInForegroundMode = true;
5 | alertList.setOnItemClickListener(new AdapterView.OnItemClickListener() {
6 | @Override
7 | public void onItemClick(AdapterView<?> parent, View view, final int
| position, long id) {
8 | AlertDialog.Builder builder = new AlertDialog.Builder(MainActivity.this
| );
9 | builder.setMessage(getText(R.string.question))
10 | .setCancelable(true)
11 | .setNeutralButton(getText(R.string.cancel), new DialogInterface.
| OnClickListener() {
12 | public void onClick(DialogInterface dialog, int id) {
13 | dialog.cancel();
14 | }

15
16 | })
17 | .setPositiveButton(getText(R.string.okey), new DialogInterface.
| OnClickListener() {
18 | public void onClick(DialogInterface dialog, int id) {
19 | alertAdapter.remove(position);
20 | }
21 | });
22 | AlertDialog alert = builder.create();
23 | alert.show();
24 | }
25 | });
26 | registerForContextMenu(alertList);
27 | }

Además, en el método onResume se establece el comportamiento de la app cuando se pulse en alguna de las alertas de la lista, utilizando para ello el método OnItemClickListener de la clase AdapterView, el cual crea una instancia de un objeto de escucha de clicks en items o elementos de la lista. Redefiniendo el método onItemClick se establece este comportamiento. En primer lugar, se crea un objeto AlerDialog.Builder, el cual se encargará de generar un diálogo emergente de alerta. A continuación se establecen el mensaje del diálogo (mediante el método setMessage), la funcionalidad al pulsar el botón “Cancelar”, el cual simplemente saldrá del diálogo de alerta, y la funcionalidad del botón “Sí”, el cual eliminará la alerta de la lista. Finalmente, se genera el objeto de alerta y se muestra la alerta mediante el método show.

1 | @Override
2 | public boolean onCreateOptionsMenu(Menu menu) {
3 | // Inflate the menu; this adds items to the action bar if it is present.
4 | getMenuInflater().inflate(R.menu.menu_main, menu);
5 | return true;
6 | }

7
8 | @Override
9 | public boolean onOptionsItemSelected(MenuItem item) {
10 | switch (item.getItemId()){
11 | case R.id.settings_menu:
12 | Intent intent = new Intent(this, SettingsActivity.class);
13 | this.startActivity(intent);
14 | break;
15 | default:
16 | return super.onOptionsItemSelected(item);

MEMORIA

17 | }
18 | return true;
19 | }

Por otro lado, mediante el método onCreateOptionsMenu se establece el menú de la aplicación, generando un botón para acceder al menú mediante el método getMenuInflater.

Además, se dota de funcionalidad al menú con el método onOptionsItemSelected, donde se asocia cada elemento del menú con una actividad a iniciar (una nueva vista de la aplicación). Esto se realiza mediante el uso de objetos de la clase Intent, asociando en este caso una instancia de esta clase a la clase SettingsActivity, clase que implementa la actividad del menú, que se expone en el apartado 10.8.2.3. A continuación, se inicia la actividad por medio de este objeto Intent.

1 | private void notifyAlertToNotification(String cad){
2 | NotificationCompat.Builder mBuilder = (NotificationCompat.Builder) new
| NotificationCompat.Builder(this)
3 | .setSmallIcon(R.drawable.ic_notify_icon)
4 | .setContentTitle("DeafAlert")
5 | .setContentText(cad)
6 | .setLights(Color.WHITE, 500, 1000)
7 | .setOnlyAlertOnce(true)
8 | .setPriority(2)
9 | .setVibrate(new long[] { 1000, 500, 500, 500, 500 })
10 | .setAutoCancel(true);
11 | Intent resultIntent = new Intent(this, MainActivity.class);

12
13 | TaskStackBuilder stackBuilder = TaskStackBuilder.create(this);
14 | stackBuilder.addParentStack(MainActivity.class);
15 | stackBuilder.addNextIntent(resultIntent);
16 | PendingIntent resultPendingIntent = stackBuilder.getPendingIntent(0,
| PendingIntent.FLAG_UPDATE_CURRENT);
17 | mBuilder.setContentIntent(resultPendingIntent);
18 | NotificationManager mNotificationManager = (NotificationManager)
| getSystemService(Context.NOTIFICATION_SERVICE);
19 | mNotificationManager.notify(NotifCount, mBuilder.build());
20 | NotifCount++;
21 | }

Finalmente, el último método de la actividad principal, notifyAlertToNotification, utilizado en el hilo Runnable explicado anteriormente, es el encargado de generar y enviar notificaciones al sistema. Lo primero que se realiza en esta función es crear un objeto Builder de la clase NotificationCompat, el cual se inicializa con una serie de opciones para la notificación, como son el icono de la notificación, el título, el texto que debe contener, y distintos tipos de alerta como el color con el que el led del smartphone debe parpadear, la vibración, y cómo generar estas alertas. De este modo, la persona que utilice la aplicación podrá sentir mediante vibración o notar visualmente la alerta mediante el led, sin necesidad de tener el dispositivo desbloqueado.

Tras crear este objeto, se crea una instancia de la clase Intent asociada a la actividad principal de la aplicación, y mediante un objeto de la clase TaskStackBuilder, se asigna el camino de vuelta al pulsar el botón “Volver” del propio dispositivo. A continuación, mediante un objeto de

MEMORIA

la clase NotificationManager se obtiene el servicio del sistema relacionado con las notificaciones, y se notifica la alerta mediante el método notify propio de esa clase, utilizando un número de identificación para la notificación, y el objeto builder creado al principio de la función.

### 10.8.2.2. Gestión de alertas

La gestión de las alertas a mostrar en la aplicación, así como la funcionalidad de refrescar las mismas en la lista de alertas dentro de la vista principal, se realiza mediante la clase AlertListAdapter, clase que hereda de la clase BaseAdapter, clase java de Android utilizada para actualizar el contenido de una vista ListView, vista utilizada en la vista principal para mostrar la lista de alertas.

1 | public class AlertListAdapter extends BaseAdapter{
2 | private ArrayList<String> alerts;
3 | private static LayoutInflater inflater = null;

4

5
6 | public AlertListAdapter(Activity activity, ArrayList<String> alerts){
7 | this.alerts = alerts;
8 | this.inflater = activity.getLayoutInflater();
9 | }
10 | public class ViewHolder
11 | {
12 | TextView raspberryText;
13 | }

El constructor de la clase recibe un objeto Activity, la actividad asociada al Adapter, y un Array-List de String, la lista de alertas. Mediante la instancia de Activity obtiene un objeto Inflater, necesario para obtener más adelante el objeto ListView a actualizar.

Además, se crea una subclase ViewHolder, la cual incluye un objeto de tipo TextView, tipo utilizado para generar cada elemento de la lista ListView.

1 | public void setData(String newalert){
2 | this.alerts.add(newalert);
3 | this.notifyDataSetChanged();
4 | }

5

6
7 | public void remove(int position){
8 | this.alerts.remove(position);
9 | this.notifyDataSetChanged();
10 | }

Los métodos encargados de manipular la lista son setData y remove. El primero recibe una cadena con la alerta, la almacena en la lista, y mediante el método notifyDataSetChanged actualiza la información mostrada en la vista principal, refrescando el ListView asociado. El segundo método elimina un elemento de la lista y luego notifica de igual manera el cambio.

1 | @Override

MEMORIA

2 | public View getView(int position, View convertView, ViewGroup parent) {
3 | View vi = convertView;
4 | ViewHolder holder;

5
6 | if(convertView==null){
7 | vi = inflater.inflate(R.layout.item,null);
8 | holder = new ViewHolder();
9 | holder.raspberryText = (TextView)vi.findViewById(R.id.textRaspberry);
10 | vi.setTag(holder);
11 | }else{
12 | holder = (ViewHolder)vi.getTag();
13 | }
14 | holder.raspberryText.setText(this.alerts.get(position));
15 | return vi;
16 | }

Es necesario además sobrecargar el método getView de BaseAdapter, para poder obtener la vista a modificar cuando se deba actualizar el contenido de la lista de alertas. Este método usa un objeto de tipo View y otro de la subclase creada anteriormente, ViewHolder. Primero se obtiene el layout o vista a modificar de la apliación mediante el Inflater obtenido en el constructor, para a partir de esta referencia obtener la vista interna que actualizar, mediante su identificador. Hecho esto, ya se puede incluir el texto de la alerta en el TextView asociado al objeto ViewHolder utilizado.

### 10.8.2.3. Menú de configuración

El menú de configuración está basado en el menú generado por Android Studio. Este menú incluye opciones sobrantes, por lo que se retiran todas las partes sobrantes dejando un único submenú con un campo de texto a rellenar, para configurar la dirección IP del servidor de alertas.

Este menú se implementa mediante la clase SettingsActivity, el cual incluye subclases en su interior que heredan de la clase PreferenceFragment (propia del SDK de Android) por cada submenú. En este caso, al haber un único submenú, hay una única subclase, ServerAlertsPreference-Fragment.

1 | public static class ServerAlertsPreferenceFragment extends PreferenceFragment
| {

2
3 | private static final Pattern PARTIAL_IP_ADDRESS =
4 | Pattern.compile("^((25[0-5]|2[0-4][0-9]|[0-1][0-9]{2}|[1-9][0-9]|[0-9])
| \\.){0,3}" +
5 | "((25[0-5]|2[0-4][0-9]|[0-1][0-9]{2}|[1-9][0-9]|[0-9])){0,1}$");

6
7 | private EditTextPreference IPEditTextPref;

8
9 | @Override
10 | public void onCreate(Bundle savedInstanceState) {
11 | super.onCreate(savedInstanceState);
12 | addPreferencesFromResource(R.xml.pref_server_alerts);
13 | setHasOptionsMenu(true);

14
15 | IPEditTextPref = (EditTextPreference) getPreferenceManager().findPreference
| ("ip_address");

MEMORIA

IPEditTextPref.setOnPreferenceChangeListener(new Preference. OnPreferenceChangeListener() {
public boolean onPreferenceChange(Preference preference, Object newValue) {

try {
return PARTIAL_IP_ADDRESS.matcher(newValue.toString()).matches();

}
catch(Exception e) {
return false;

}

}
});

bindPreferenceSummaryToValue(findPreference("ip_address"));

}

}

Esta clase cuenta con una constante de la clase Pattern, una plantilla, que define como debe estar formada una dirección IP, para poder comparar la preferencia establecida con esta plantilla, y así su validez.

Es en el método onCreate donde se genera el campo para establecer la dirección IP. A continuación se genera una vista de texto para preferencias (EditTextPreference). Una vez hecho, se obtiene la preferencia con identificador ip_address, y se establece una escucha para cuando el valor de esta preferencia cambie, con el método setOnPreferenceChangeListener. Como parámetro de este método, se crea un objeto onPreferenceChangeListener, para el cual se redefine la función onPreferenceChange.

Esta función será la encargada de quedar a la espera de un cambio en el valor de la preferencia, comprobando cuando esto ocurra, si el valor es una dirección IP válida, mediante el método matcher de la clase Pattern. Finalmente, se almacena el valor de la preferencia mediante el método bindPreferenceSummaryToValue.

# 11. Planificación Temporal

La planificación temporal del Proyecto se basa en el tiempo que ha tomado realizar el Trabajo de Fin de Grado que envuelve este Proyecto, desde la toma de contacto con el director del Proyecto, hasta la finalización del mismo. La planificación se divide en varias etapas, pasando por el estudio de la situación actual y la elicitación de requisitos, investigación y búsqueda de información sobre los distintos dispositivos y distintas tecnologías a utilizar en el Proyecto y estudiando las alternativas que surgieran. Finalmente, teniendo claro todo el estudio realizado, se comienzan algunas pruebas, tras concretar las especificaciones del sistema y los requisitos del mismo. Se decidió la comunicación a emplear en todo el sistema, así como la utilizada entre los nodos informativos visuales y los dispositivos generadores de alertas.

Tras las pruebas realizadas, y descartando finalmente el uso de una de las alternativas para nodo central, Arduino, se comienza a realizar el sistema final, teniendo ya avanzado gran parte del trabajo gracias a todo el estudio e investigación anterior. Simultáneamente a todo lo anterior, se va generando también la documentación del Proyecto, realizando recurrentemente las modifica-

MEMORIA

ciones en la misma para que fuese acorde con las soluciones tomadas y los estudios realizados.

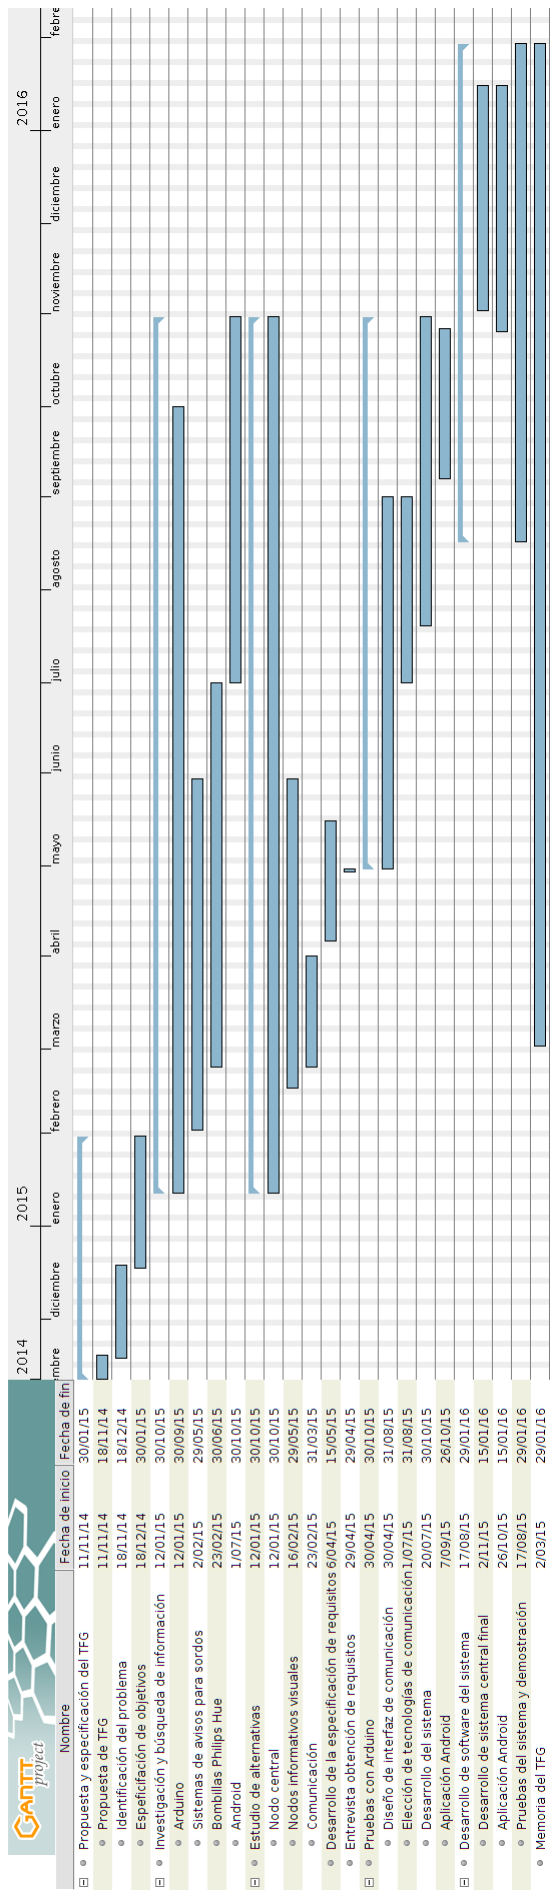
[picture p29: figure]

Figura 11.1: Diagrama de Gantt de la planificación temporal del Proyecto

MEMORIA

# 12. Resumen del Presupuesto

Los costes de presupuesto para la implantación en una vivienda real son de 277.08 e, debiéndose sumar además el coste de mano de obra, que asciende a los 130 e. Esto supone un coste total de 407.08 e. Se debe tener en cuenta además que este precio es el relativo a instalar 3 bombillas Hue, teniendo un coste de 52.99 e por bombilla extra a instalar [2], tal como se muestra en la tabla 12.1.

Descripción | Precio
Implantación del Proyecto en vivienda real | 277.08 e
Mano de obra | 130 e
Total | 407.08 e

Tabla 12.1: Resumen del presupuesto de implantación del Proyecto

En el apartado 24.2 se desglosa el presupuesto del Proyecto de forma más detallada.

# SISTEMA DE AVISOS PARA DISCAPACITADOS

# AUDITIVOS

REF: 000001

# PLANOS

CLIENTE: UNIVERSIDAD DE CÁDIZ (ESCUELA SUPERIOR DE INGENIERÍA) AVENIDA DE LA UNIVERSIDAD DE CÁDIZ No 10, 11519 PUERTO REAL
956 48 32 00
DIRECCION.ESI@UCA.ES

AUTOR: RAÚL DÍEZ SÁNCHEZ
INGENIERO INFORMÁTICO
77171812-G
RA.DIEZSANCHEZ@ALUM.UCA.ES

Cádiz, 3 de febrero de 2016

# Índice

13. Plano 1: Esquemático PCB para conexión con telefonillo | 53
14. Plano 2: Layout PCB para conexión con telefonillo | 54
15. Plano 3: Esquemático PCB para conexión con timbre | 55
16. Plano 4: Layout PCB para conexión con timbre | 56

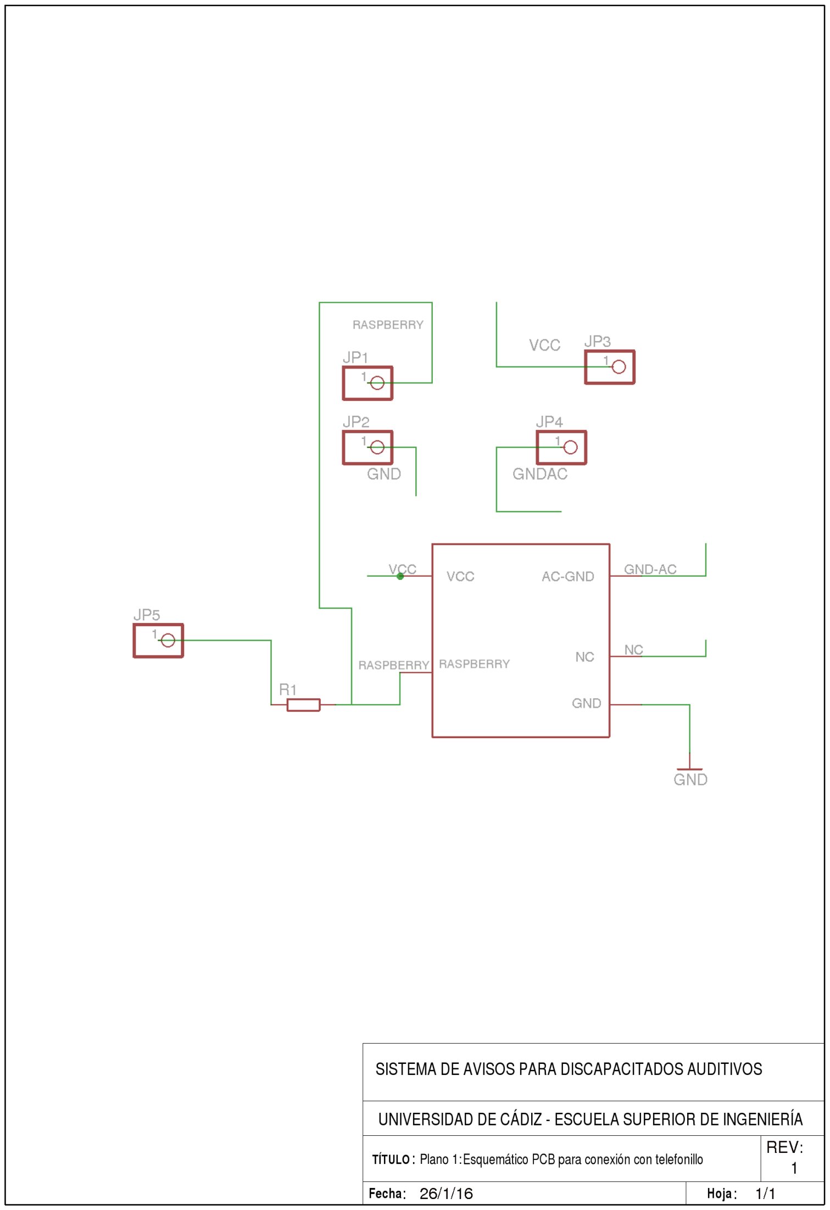
[picture p30: page 73]

Plano 1:

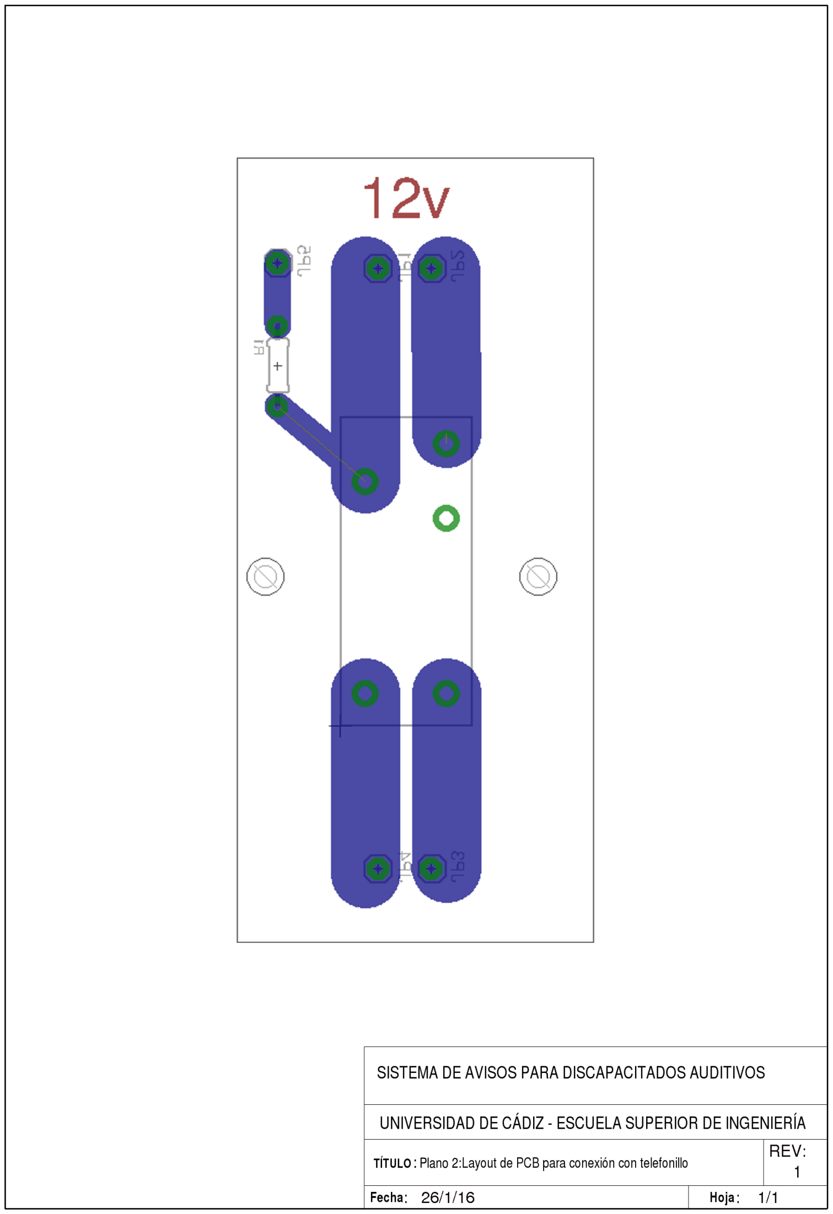
[picture p31: page 74]

Plano 2:

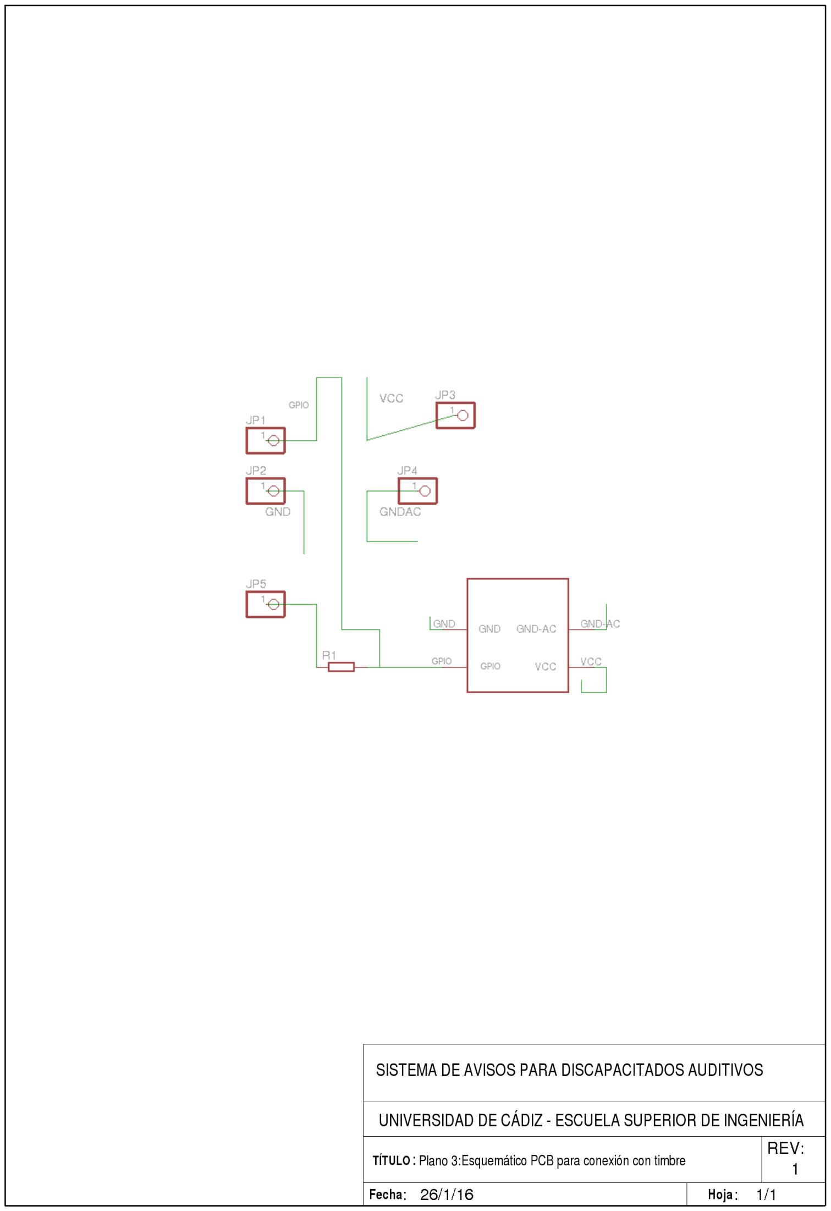
[picture p32: page 75]

Plano 3:

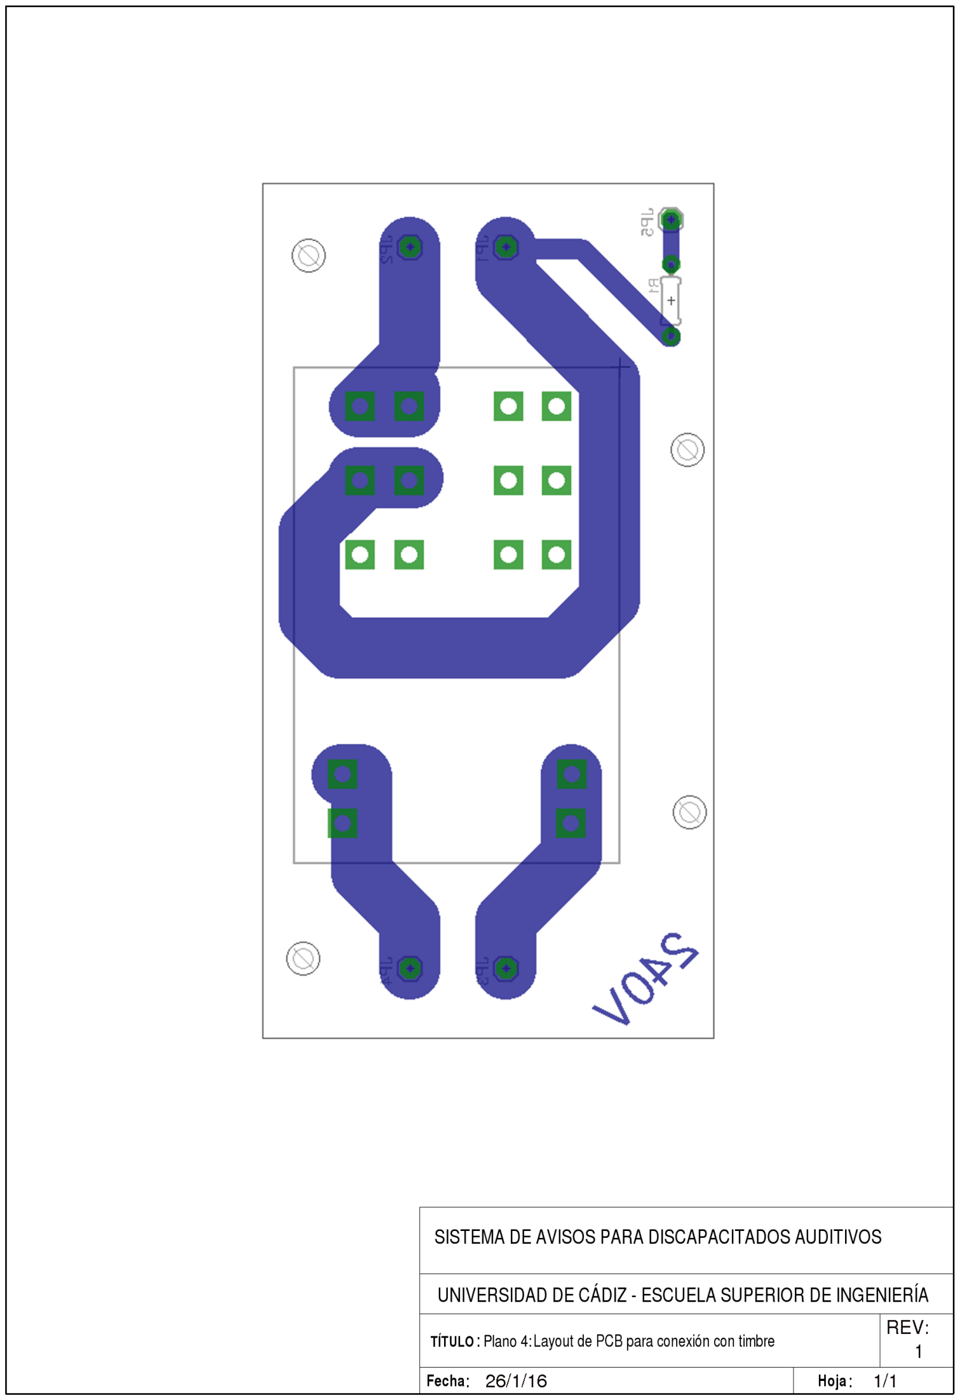
[picture p33: page 76]

Plano 4:

# SISTEMA DE AVISOS PARA DISCAPACITADOS

# AUDITIVOS

REF: 000001

# ANEXOS

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

AUTOR: RAÚL DÍEZ SÁNCHEZ
INGENIERO INFORMÁTICO
77171812-G
RA.DIEZSANCHEZ@ALUM.UCA.ES

Cádiz, 3 de febrero de 2016

# Índice

17. Documentación de Entrada | 61
18. Análisis y Diseño del Sistema | 62
19. Plan de Pruebas | 76
20. Instalación de Sistema Operativo en Raspberry Pi | 82
21. Estimación de Tamaño y Esfuerzos | 85
22. Hojas técnicas de componentes empleados | 86

CUESTIONARIO

El presente cuestionario está enmarcado en un Trabajo de Fin de Grado en el que se pretende crear un sistema de avisos para sordos basado en nuevas tecnologías y con la característica de que sea económico.

1.- ¿Qué avisos son importantes para ti en tu hogar?

ð Llamada a la puerta.
ð Llamada al telefonillo.
ð Llamada al teléfono.
ð Otros avisos (indique cuál).

2.- En la actualidad ¿cómo te percatas de estos avisos?

ð Te avisa un oyente.
ð Luces (explique cómo).
ð Vibración (explique cómo).
ð Otra forma (explique cuál y cómo)

3.- Haciendo uso de las nuevas tecnologías ¿crees que puede mejorarse?, ¿cómo te gustaría percatarte de los avisos?

ð Luces (explique cómo).
ð Vibración (explique cómo).
ð Otra forma (explique cuál y cómo).

4.- Continuando con las nuevas tecnologías ¿crees que sería útil recibir las mismas alertas en smartphones Android?

ð Sí, utilizo un smartphone y sería útil.
ð No, no utilizo smartphone o no me parece útil.

5.- Comentarios:

ANEXOS

# 17. Documentación de Entrada

## 17.1. Cuestionario realizado a personas con discapacidad auditiva

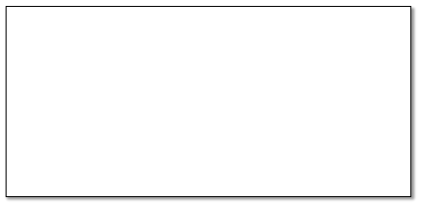
[picture p34: figure]

ANEXOS

# 18. Análisis y Diseño del Sistema

## 18.1. Análisis de requisitos específicos de sistema software

En este apartado se estudian los objetivos y requisitos específicos para cada sistema software utilizado, tanto el sistema desarrollado para el nodo central como la aplicación para smartphone, profundizando más allá de las Especificaciones del Sistema disponibles en el apartado 23.

### 18.1.1. Requisitos específicos de sistema central

### 18.1.1.1. Objetivos específicos

OBJ-01 | Utilizar puente Hue.
Descripción | El sistema deberá conectar con el puente Philips Hue empleado y poder realizar las operaciones necesarias.
Importancia | Alta.
Estabilidad | Alta.
Comentarios | Ninguno.

Tabla 18.1: Objetivo 1 del nodo central: Utilizar el puente Hue.

OBJ-02 | Detectar llamadas.
Descripción | El sistema deberá detectar las llamadas al timbre y al telefonillo.
Importancia | Alta.
Estabilidad | Alta.
Comentarios | Ninguno.

Tabla 18.2: Objetivo 2 del nodo central: Detectar llamadas.

OBJ-03 | Alertar mediante bombillas.
Descripción | El sistema deberá alertar al usuario mediante las bombillas, cam-biando su estado.
Importancia | Alta.
Estabilidad | Alta.
Comentarios | Ninguno.

Tabla 18.3: Objetivo 3 del nodo central: Alertar mediante bombillas.

ANEXOS

OBJ-04 | Alertar mediante smartphone.
Descripción | El sistema deberá alertar al usuario mediante el envío de alertas al smartphone.
Importancia | Alta.
Estabilidad | Alta.
Comentarios | Ninguno.

Tabla 18.4: Objetivo 4 del nodo central: Alertar mediante smartphone.

### 18.1.1.2. Requisitos funcionales específicos

### 18.1.1.2.1. Diagrama de Casos de Uso

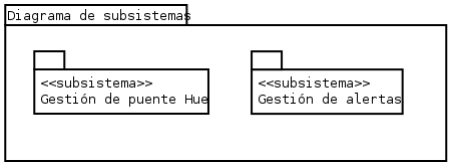
[picture p35: figure]

Figura 18.1: Diagrama de subsistemas.

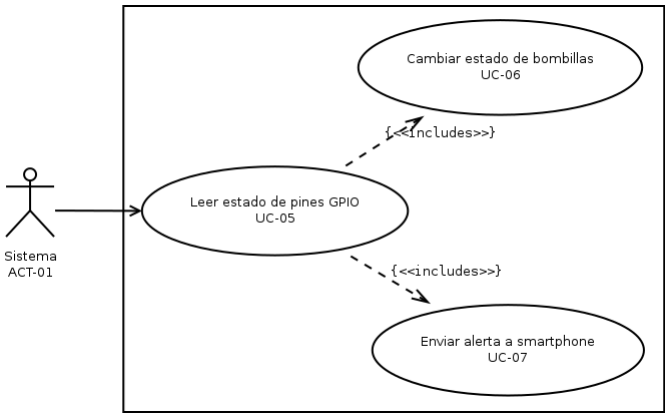
[picture p36: figure]

Figura 18.2: Diagrama de subsistema de gestión de alertas.

ANEXOS


Figura 18.3: Diagrama de subsistema de gestión de puente Hue.

### 18.1.1.2.2. Definición de actores

ACT-01 | Sistema.
Descripción | Este actor representa al propio sistema nodo central, que tendrá funcionamiento automático y será el encargado de interactuar con los distintos elementos que lo conforman.

Tabla 18.5: Actor 01: Sistema.

### 18.1.1.2.3. Casos de Uso

### 18.1.1.2.3.1. Subsistema de gestión de puente Hue

ANEXOS

UC-01 | Conectar con puente Hue.
Objetivos asociados | OBJ-01 Utilizar el puente Hue.
Descripción | El sistema deberá comportarse tal como se describe en el siguiente caso de uso cuando se conecte con el puente Hue.
Precondición | El sistema no está conectado al puente Hue.
Secuencia normal | Paso | Acción
| 1 | El sistema envía petición de conexión al puente Hue.
| 2 | Se establece la conexión.
Postcondición | El sistema queda conectado al puente Hue.
Excepciones | Paso | Acción
| 2 | No se establece la conexión porque no se puede conec-tar con el puente Hue. A continuación este caso de uso queda sin efecto y el sistema debe reiniciarse.
Rendimiento | Paso | Cota de tiempo
Frecuencia | 1 vez.
Comentarios | Ninguno

Tabla 18.6: Caso de Uso 01: Conectar con puente Hue.

UC-02 | Configurar puente Hue.
Objetivos asociados | OBJ-01 Utilizar el puente Hue.
Descripción | El sistema deberá comportarse tal como se describe en el siguiente caso de uso cuando se realicen operaciones de con-figuración del puente Hue.
Precondición | El sistema está conectado al puente Hue.
Secuencia normal | Paso | Acción
| 1 | El sistema envía configuración al puente Hue.
| 2 | El puente Hue devuelve información relacionada con la configuración.
| 3 | Se ha realizado la configuración.
Postcondición | El sistema queda configurado de acuerdo a los parámetros dados.
Excepciones | Paso | Acción
| 3 | Hay errores en la configuración enviada y el puente Hue no se configura de acuerdo a esos parámetros. A continuación este caso de uso queda sin efecto y el sistema sigue su funcionamiento.
Rendimiento | Paso | Cota de tiempo
Frecuencia | PD
Comentarios | Ninguno

Tabla 18.7: Caso de Uso 02: Configurar puente Hue.

ANEXOS

UC-03 | Enviar petición a puente Hue.
Objetivos asociados | OBJ-01 Utilizar el puente Hue.
Descripción | El sistema deberá comportarse tal como se describe en el siguiente caso de uso cuando se realice cualquier operación para utilizar el puente Hue.
Precondición | El sistema está conectado al puente Hue.
Secuencia normal | Paso | Acción
| 1 | El sistema envía datos al puente Hue.
| 2 | El puente Hue devuelve información relacionada con la petición realizada.
Postcondición | El sistema recibe información de la petición y actúa en con-secuencia.
Excepciones | Ninguna.
Rendimiento | Paso | Cota de tiempo
Frecuencia | PD
Comentarios | Ninguno

Tabla 18.8: Caso de Uso 03: Enviar petición a puente Hue.

UC-04 | Encontrar nuevas bombillas.
Objetivos asociados | OBJ-01 Utilizar el puente Hue.
Descripción | El sistema deberá comportarse tal como se describe en el siguiente caso de uso cuando busque nuevas bombillas en el entorno para asociarlas.
Precondición | El sistema está conectado al puente Hue.
Secuencia normal | Paso | Acción
| 1 | El sistema envía una petición al puente Hue para ob-tener información sobre nuevas bombillas.
| 2 | El puente Hue devuelve información sobre nuevas bom-billas instaladas.
| 3 | El sistema asocia las nuevas bombillas instaladas.
Postcondición | Las nuevas bombillas instaladas quedan asociadas al sistema.
Excepciones | Paso | Acción
| 3 | No hay nuevas bombillas instaladas. A continuación este caso de uso queda sin efecto y el sistema sigue su funcionamiento.
Rendimiento | Paso | Cota de tiempo
Frecuencia | PD
Comentarios | Ninguno

Tabla 18.9: Caso de Uso 04: Encontrar nuevas bombillas.

### 18.1.1.2.3.2. Subsistema de gestión de alertas

ANEXOS

UC-05 | Leer estado de pines GPIO.
Objetivos asociados | OBJ-02 Detectar llamadas.
Descripción | El sistema deberá comportarse tal como se describe en el siguiente caso de uso cuando se reciba una señal a través de los pines GPIO.
Precondición | El sistema recibe una señal eléctrica TTL a través de GPIO.
Secuencia normal | Paso | Acción
| 1 | El sistema filtra la señal a través de GPIO.
| 2 | El sistema discrimina si es una señal del telefonillo o del timbre.
Postcondición | El sistema realiza las acciones determinadas en los casos de uso UC-06 y UC-07.
Excepciones | Ninguna
Rendimiento | Paso | Cota de tiempo
Frecuencia | PD
Comentarios | Ninguno

Tabla 18.10: Caso de Uso 05: Leer estado de pines GPIO.

UC-06 | Cambiar estado de bombillas.
Objetivos asociados | OBJ-03 Alertar mediante bombillas.
Descripción | El sistema deberá comportarse tal como se describe en el siguiente caso de uso cuando termine el caso de uso UC-05.
Precondición | El sistema está conectado al puente Hue y acaba de terminar el caso de uso UC-05.
Secuencia normal | Paso | Acción
| 1 | El sistema almacena el antiguo estado de las bombillas conectadas.
| 2 | El sistema envía petición de cambio de estado de las bombillas al puente Hue, de acuerdo a la salida del caso de uso UC-05.
| 3 | El sistema vuelve a enviar una petición de cambio de estado al puente Hue para revertir el cambio, estable-ciendo ahora el antiguo estado.
Postcondición | El sistema vuelve a quedar en estado de espera de alertas.
Excepciones | Ninguna
Rendimiento | Paso | Cota de tiempo
Frecuencia | PD
Comentarios | Ninguno

Tabla 18.11: Caso de Uso 06: Cambiar estado de bombillas.

ANEXOS

UC-07 | Enviar alerta a smartphone.
Objetivos asociados | OBJ-04 Alertar mediante smartphone.
Descripción | El sistema deberá comportarse tal como se describe en el siguiente caso de uso cuando termine el caso de uso UC-05.
Precondición | El sistema acaba de terminar el caso de uso UC-05.
Secuencia normal | Paso | Acción
| 1 | El sistema espera a solicitud de alerta por parte del smartphone.
| 2 | El sistema envía la alerta al smartphone a modo de texto, de acuerdo a la salida del caso de uso UC-05.
Postcondición | El sistema vuelve a quedar en estado de espera de alertas.
Excepciones | Ninguna
Rendimiento | Paso | Cota de tiempo
Frecuencia | PD
Comentarios | Ninguno

Tabla 18.12: Caso de Uso 07: Enviar alerta a smartphone.

### 18.1.2. Requisitos específicos de aplicación para smartphone

### 18.1.2.1. Objetivos específicos

OBJ-01 | Conectar con nodo central.
Descripción | El sistema deberá permitir la conexión con el nodo central y la configuración de esta conexión.
Importancia | Alta.
Estabilidad | Alta.
Comentarios | Ninguno.

Tabla 18.13: Objetivo 1 de la aplicación para smartphone: Conectar con nodo central.

OBJ-02 | Mostrar alerta a usuario.
Descripción | El sistema deberá mostrar las alertas recibidas en modo texto al usuario.
Importancia | Alta.
Estabilidad | Alta.
Comentarios | Ninguno.

Tabla 18.14: Objetivo 2 de la aplicación para smartphone: Mostrar alerta a usuario.

ANEXOS

OBJ-03 | Gestionar alertas.
Descripción | El sistema deberá permitir la gestión de las alertas por parte del usuario.
Importancia | Alta.
Estabilidad | Alta.
Comentarios | Ninguno.

Tabla 18.15: Objetivo 3 de la aplicación para smartphone: Gestionar alertas.

### 18.1.2.2. Requisitos funcionales específicos

### 18.1.2.2.1. Diagrama de Casos de Uso


Figura 18.4: Diagrama de casos de uso de aplicación para smartphone.

### 18.1.2.2.2. Definición de actores

ACT-01 | Usuario.
Descripción | Este actor representa al usuario de la aplicación para smartphone.

Tabla 18.16: Actor 01: Usuario.

### 18.1.2.2.3. Casos de Uso

ANEXOS

UC-01 | Configurar aplicación.
Objetivos asociados | OBJ-01 Conectar con nodo central.
Descripción | El sistema deberá comportarse tal como se describe en el si-guiente caso de uso cuando el usuario configure la aplicación.
Precondición | El usuario ha accedido a la configuración del sistema.
Secuencia normal | Paso | Acción
| 1 | El sistema muestra un menú de configuración donde introducir la dirección del nodo central.
| 2 | Se comprueba la dirección del nodo central.
| 3 | La dirección es correcta y el sistema conecta con el nodo central.
Postcondición | El sistema queda conectado al nodo central.
Excepciones | Paso | Acción
| 3 | La dirección proporcionada por el usuario es incorrecta y el sistema no conecta con el nodo central. A conti-nuación este caso de uso se reinicia.
Rendimiento | Paso | Cota de tiempo
Frecuencia | PD
Comentarios | Ninguno

Tabla 18.17: Caso de Uso 01: Configurar aplicación.

UC-02 | Mostrar alerta en pantalla.
Objetivos asociados | OBJ-02 Mostrar alerta a usuario.
Descripción | El sistema deberá comportarse tal como se describe en el siguiente caso de uso cuando se recibe una alerta del nodo central.
Precondición | El usuario ha accedido a la pantalla principal de la aplicación y la aplicación se encuentra en primer plano.
Secuencia normal | Paso | Acción
| 1 | El sistema recibe una alerta del nodo central.
| 2 | Se almacena la alerta temporalmente y se muestra por pantalla.
| 3 | El usuario ve la alerta, pudiendo pasar al caso de uso UC-04.
Postcondición | El sistema queda a la espera de más alertas.
Excepciones | Ninguna
Rendimiento | Paso | Cota de tiempo
Frecuencia | PD
Comentarios | Ninguno

Tabla 18.18: Caso de Uso 02: Mostrar alerta en pantalla.

ANEXOS

UC-03 | Mostrar notificación en sistema.
Objetivos asociados | OBJ-02 Mostrar alerta a usuario.
Descripción | El sistema deberá comportarse tal como se describe en el siguiente caso de uso cuando se recibe una alerta del nodo central.
Precondición | El usuario tiene la aplicación funcionando en segundo plano.
Secuencia normal | Paso | Acción
| 1 | El sistema recibe una alerta del nodo central.
| 2 | Se almacena la alerta temporalmente y se envía una notificación al sistema.
| 3 | El usuario ve la notificación, pudiendo pasar al caso de uso UC-04.
Postcondición | El sistema queda a la espera de más alertas.
Excepciones | Ninguna
Rendimiento | Paso | Cota de tiempo
Frecuencia | PD
Comentarios | Ninguno

Tabla 18.19: Caso de Uso 03: Mostrar notificación en sistema.

UC-04 | Eliminar alerta vista.
Objetivos asociados | OBJ-03 Gestionar alertas.
Descripción | El sistema deberá comportarse tal como se describe en el si-guiente caso de uso cuando el usuario pulsa sobre una alerta.
Precondición | El usuario pulsa sobre una alerta.
Secuencia normal | Paso | Acción
| 1 | El sistema comprueba la alerta sobre la que se pulsa.
| 2 | El sistema muestra un diálogo para que el usuario acepte eliminar la alerta.
| 3 | El usuario acepta eliminar la alerta.
| 4 | El sistema elimina la alerta de la lista temporal.
Postcondición | El sistema queda a la espera de más alertas.
Excepciones | Paso | Acción
| 3 | El usuario no acepta eliminar la alerta. A continuación este caso de uso queda sin efecto y el sistema sigue su funcionamiento.
Rendimiento | Paso | Cota de tiempo
Frecuencia | PD
Comentarios | Ninguno

Tabla 18.20: Caso de Uso 04: Eliminar alerta vista.

## 18.2. Diseño software del sistema

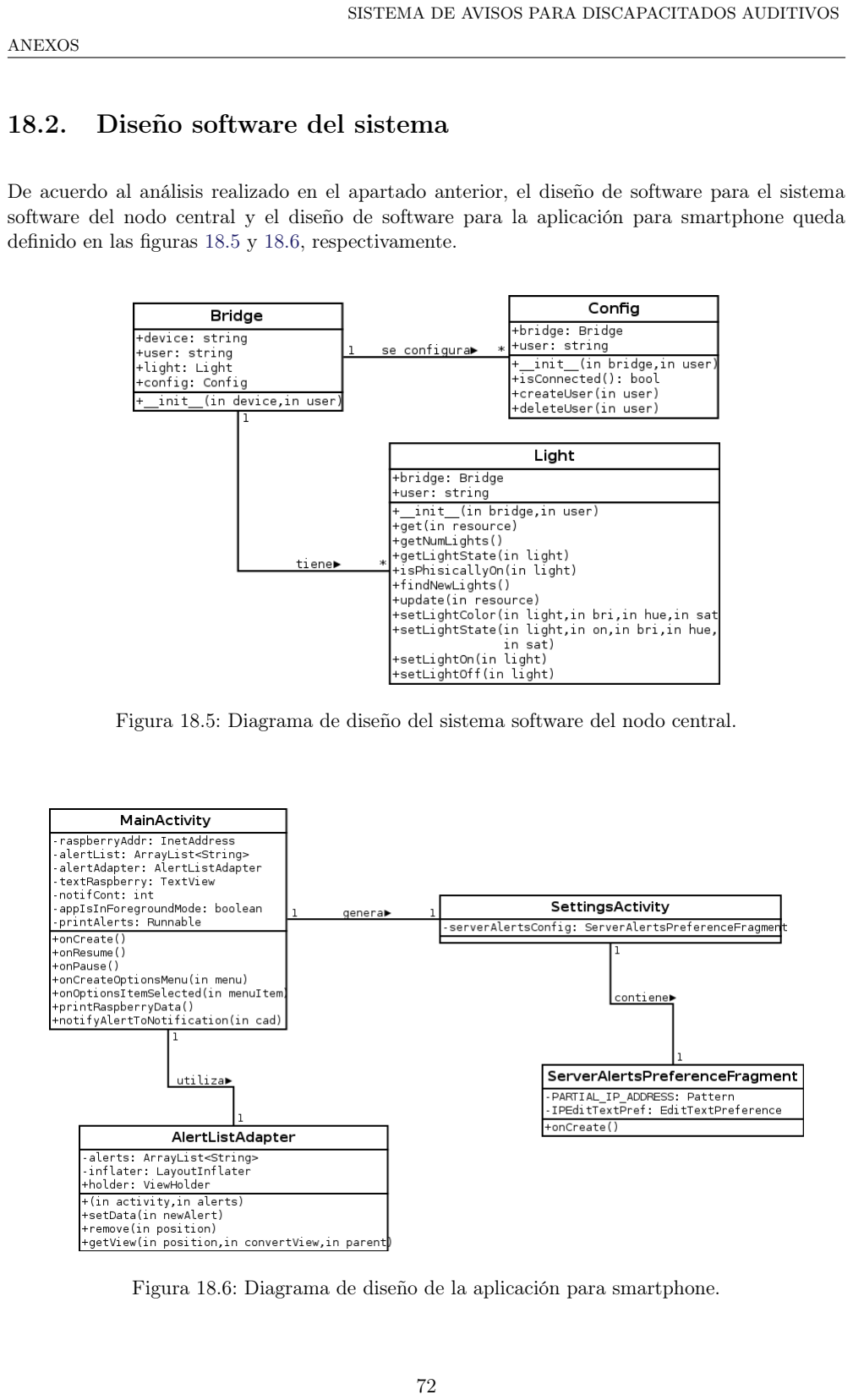
[picture p37: page 92]

ANEXOS

De acuerdo al análisis realizado en el apartado anterior, el diseño de software para el sistema software del nodo central y el diseño de software para la aplicación para smartphone queda definido en las figuras 18.5 y 18.6, respectivamente.

Figura 18.5: Diagrama de diseño del sistema software del nodo central.

Figura 18.6: Diagrama de diseño de la aplicación para smartphone.

ANEXOS

## 18.3. Diseño de prototipo de aplicación para smartphone

El diseño del prototipo de la aplicación se compone de una pantalla principal con la lista de alertas y un botón para menú de configuración (figuras 18.7 y 18.8), un sistema de borrado de alertas mediante ventanas emergentes (figura 18.9), y un menú de configuración (figura 18.10) en el que se pueda introducir la dirección del servidor de alertas, el nodo central del sistema.


Figura 18.7: Prototipo de la pantalla principal de la aplicación para smartphones.

ANEXOS


Figura 18.8: Prototipo del menú desplegable.

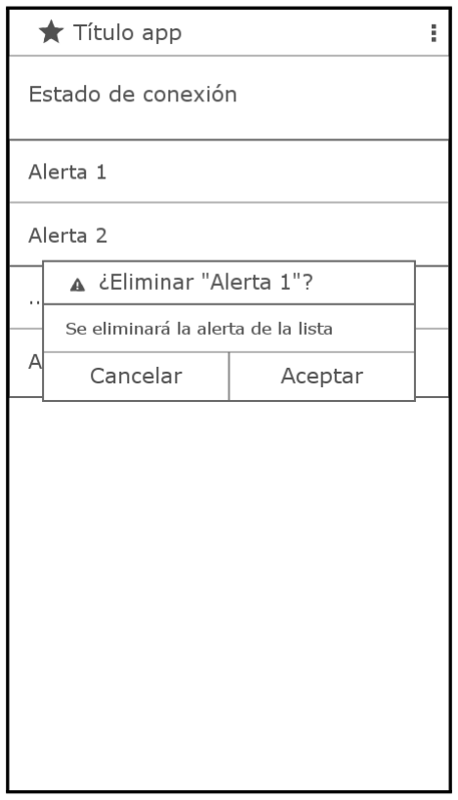
[picture p38: figure]

Figura 18.9: Prototipo de ventana emergente para eliminar alertas.

ANEXOS

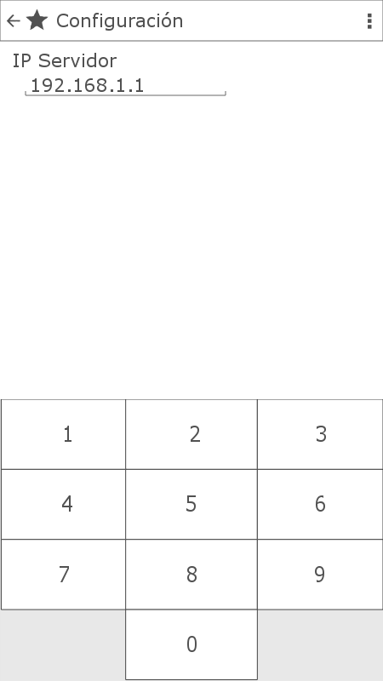
[picture p39: figure]

Figura 18.10: Prototipo de menú de configuración.

ANEXOS

# 19. Plan de Pruebas

## 19.1. Trazabilidad de Casos de Prueba - Requisitos

En este apartado se expone la tabla 19.1 que muestra la trazabilidad entre Casos de Prueba y Requisitos Funcionales (Casos de Uso), tanto requisitos generales, como requisitos específicos de cada subsistema software, es decir, se expone que se satisfacen los requisitos para cada Caso de Prueba.

CP-01 | Requisitos Generales | Requisitos Específicos Sistema Central | Requisitos Específicos Aplicación para smartphone
UC-01 | UC-02 | UC-03 X | UC-04 | UC-01 X | UC-02 X | UC-03 X | UC-04 | UC-05 X | UC-06 X | UC-07 | UC-01 | UC-02 | UC-03 | UC-04
CP-02 | | | | X | | | | | X | | X | X | X
CP-03 | | | X | | X | X | X | X | X | X
CP-04 | X | | X | X | X | X | X | | X | X | X | X | X
CP-05 | | X | X | X | X | X | X | | X | X | X | X | X
CP-06 | | | | X | | | | | X | | X | X | | X
CP-07 | | | | X | | | | | X | | X | X | X | X | X
CP-08 | X | X | X | X | X | X | X | | X | X | X | X | X
CP-09 | X | X | X | | X | X | X | X | X | X

Tabla 19.1: Trazabilidad de Casos de Prueba - Requisitos (Casos de Uso)

## 19.2. Definición de los Casos de Prueba

Comprobar recepción de alertas en Raspberry Pi y Hue CP-01 Descripción:
Mediante este Caso de Prueba se pretende comprobar la recepción de las alertas visuales en las bombillas Philips Hue.
Prerrequisitos:
El sistema está conectado y encendido. Hay al menos una bombilla Hue encendida.
Pasos:
Se pulsa el interruptor del timbre o del telefonillo.
Se espera a ver las alertas en las bombillas Hue.
Resultado esperado:
Las bombillas Hue conectadas y encendidas físicamente parpadean entre un color y el estado anterior, mostrando así la alerta.
Resultado obtenido:
Las bombillas Hue conectadas parpadean entre un color y el estado anterior, mostrando así la alerta. El resultado es el esperado.

Tabla 19.2: CP-01: Comprobar recepción de alertas en Raspberry Pi y Hue

ANEXOS

Comprobar recepción de alertas en smartphone | CP-02
Descripción:
Mediante este Caso de Prueba se pretende comprobar la recepción de las alertas en la aplicación para smartphone.
Prerrequisitos:
El sistema está conectado y encendido. Un smartphone con la aplicación instalada está conectado al sistema.
Pasos:
Se inicia la aplicación para smartphone.
Se pulsa el interruptor del timbre o del telefonillo.
Se espera a recibir la alerta en la aplicación para smartphone.
Se muestra una alerta con la fecha y hora, así como el evento ocurrido.
Resultado esperado:
Se recibe una alerta en la aplicación del smartphone que se muestra en la pantalla principal, incluyendo fecha, hora y evento registrado.
Resultado obtenido:
Se recibe la alerta en la pantalla principal con el formato indicado. El resultado es el esperado

Tabla 19.3: CP-02: Comprobar recepción de alertas en smartphone

Comprobar funcionamiento con nuevas bombillas Hue CP-03 Descripción:
Mediante este Caso de Prueba se pretende comprobar el funcionamiento del sistema con nuevas bombillas Hue, utilizándolas automáticamente según se instalen.
Prerrequisitos:
El sistema está conectado y encendido. Hay al menos una bombilla Hue encendida.
Pasos:
Se instala una nueva bombilla Hue y se enciende.
Se pulsa el interruptor del timbre o del telefonillo.
Se espera a ver las alertas en las bombillas Hue.
Resultado esperado:
Las bombillas Hue conectadas y encendidas físicamente parpadean entre un color y el estado anterior, mostrando así la alerta. Además esta alerta se muestra también en la nueva bombilla.
Resultado obtenido:
La alerta se muestra en todas las bombillas, incluida la recién instalada. El resultado es el esperado

Tabla 19.4: CP-03: Comprobar funcionamiento con nuevas bombillas Hue

ANEXOS

Comprobar recepción de alerta de telefonillo en bombillas Hue y aplicación para smartphone

CP-04

Descripción:
Mediante este Caso de Prueba se pretende comprobar la recepción de las alertas del telefonillo de forma visual en las bombillas Hue y en la aplicación para smartphone.
Prerrequisitos:
El sistema está conectado y encendido. Hay al menos una bombilla Hue encendida. Un smartphone con la aplicación instalada está conectado al sistema.
Pasos:
Se inicia la aplicación para smartphone.
Se pulsa el interruptor del telefonillo.
Se espera a ver las alertas en las bombillas Hue y en la aplicación para smartphone.
Resultado esperado:
Las bombillas Hue conectadas y encendidas físicamente parpadean entre un color definido (rojo) y el estado anterior, mostrando así la alerta. Además, se recibe una alerta de llamada al telefonillo en la apliación del smartphone.
Resultado obtenido:
Las bombillas parapdean en el color esperado (rojo) y se recibe la alerta en el smartphone. El resultado es el esperado.

Tabla 19.5: CP-04: Comprobar recepción de alerta de telefonillo en bombillas Hue y aplicación para smartphone

ANEXOS

Comprobar recepción de alerta de timbre en bombillas Hue y aplicación para smartphone

CP-05

Descripción:
Mediante este Caso de Prueba se pretende comprobar la recepción de las alertas del timbre de forma visual en las bombillas Hue y en la aplicación para smartphone.
Prerrequisitos:
El sistema está conectado y encendido. Hay al menos una bombilla Hue encendida. Un smartphone con la aplicación instalada está conectado al sistema.
Pasos:
Se inicia la aplicación para smartphone.
Se pulsa el interruptor del timbre.
Se espera a ver las alertas en las bombillas Hue y en la aplicación para smartphone.
Resultado esperado:
Las bombillas Hue conectadas y encendidas físicamente parpadean entre un color definido (azul) y el estado anterior, mostrando así la alerta. Además, se recibe una alerta de llamada al timbre en la apliación del smartphone.
Resultado obtenido:
Las bombillas parapdean en el color esperado (azul) y se recibe la alerta en el smartphone. El resultado es el esperado.

Tabla 19.6: CP-05: Comprobar recepción de alerta de timbre en bombillas Hue y aplicación para smartphone

Comprobar recepción de notificación en smartphone CP-06 Descripción:
Mediante este Caso de Prueba se pretende comprobar la recepción de las alertas en el smartphone a modo de notificación del sistema. Prerrequisitos:
El sistema está conectado y encendido. Un smartphone con la aplicación instalada está conectado al sistema.
Pasos:
Se inicia la aplicación para smartphone.
Se deja la aplicación en segundo plano, por ejemplo bloqueándolo. Se pulsa el interruptor del timbre o del telefonillo.
Se espera a recibir una notificación del sistema en el smartphone. Resultado esperado:
Se recibe una notificación propia del sistema del smartphone en él, con la información sobre la alerta.
Resultado obtenido:
Se recibe la notificación en el smartphone, a modo de notificación de Android, con la fecha, hora y evento ocurrido. El resultado es el esperado.

Tabla 19.7: CP-06: Comprobar recepción de notificación en smartphone

ANEXOS

Comprobar gestión de alertas en smartphone | CP-07
Descripción:
Mediante este Caso de Prueba se pretende comprobar la gestión de alertas en la aplicación para smartphone, en concreto la eliminación de alertas ya vistas.
Prerrequisitos:
El sistema está conectado y encendido. Un smartphone con la aplicación instalada está conectado al sistema.
Pasos:
Se inicia la aplicación para smartphone.
Se pulsa el interruptor del timbre o del telefonillo.
Se espera a recibir una notificación del sistema en el smartphone. Se pulsa sobre la notificación y se acepta para eliminar la alerta. Resultado esperado:
La alerta se marca como vista y se elimina de la pantalla principal. Resultado obtenido:
La alerta es eliminada de la lista de alertas de la pantalla principal. El resultado es el esperado.

Tabla 19.8: CP-07: Comprobar gestión de alertas en smartphone

Comprobar funcionamiento tras caída de red eléctrica CP-08 Descripción:
Mediante este Caso de Prueba se pretende comprobar el funcionamiento del sistema tras una caída de la red eléctrica o una desconexión de todo de todo el sistema.
Prerrequisitos:
El sistema está conectado y encendido.
Pasos:
Se desconecta todo el sistema de la red eléctrica.
Se vuelve a conectar el sistema a la red eléctrica.
Se espera hasta que el indicador de conexión LAN del puente Hue esté encendido más un tiempo prudencial (10 segundos) para que se realice la conexión entre todo el sistema.
Se inicia la aplicación para smartphone.
Se pulsa el interruptor del timbre o del telefonillo.
Se espera a recibir la alerta en las bombillas Hue y en en el smartphone.
Resultado esperado:
Tras la desconexión de la red eléctrica y su reconexión, el sistema debe funcionar de acuerdo al resto de Casos de Prueba, mostrándose la alerta tanto en las bombillas Hue como en la aplicación para smartphone. Resultado obtenido:
Se recibe alerta en el smartphone y se muestra también en las bombillas. El sistema sigue funcionando adecuadamente. El resultado es el esperado.

Tabla 19.9: CP-08: Comprobar funcionamiento tras caída de red eléctrica

ANEXOS

Comprobar compatibilidad con aplicación oficial de control de bombillas Hue

CP-09

Descripción:
Mediante este Caso de Prueba se pretende comprobar el funcionamiento del sistema tras una caída de la red eléctrica o una desconexión de todo de todo el sistema.
Prerrequisitos:
El sistema está conectado y encendido.
Pasos:
Se pulsa el interruptor del timbre o del telefonillo.
Se espera a recibir la alerta en las bombillas Hue.
Se modifica el estado de las bombillas mediante la aplicación oficial de Hue.
Se vuelve a pulsar el mismo interruptor, para comprobar que la alerta sea la misma.
Se comprueba que el funcionamiento es el mismo.
Resultado esperado:
Tras modificar el estado de las bombillas, el parpadeo es el mismo y del mismo color que en el caso anterior, quedando luego las bombillas como se ha establecido mediante la aplicación oficial de Hue.
Resultado obtenido:
El funcionamiento es correcto y el parpadeo es el mismo. Las bombillas han quedado en el estado que se establece mediante la aplicación oficial de Hue. El sistema sigue funcionando adecuadamente. El resultado es el esperado.

Tabla 19.10: CP-09: Comprobar compatibilidad con aplicación oficial de control de bombillas Hue

ANEXOS

# 20. Instalación de Sistema Operativo en Raspberry Pi

Para obtener un funcionamiento igual al de las pruebas realizadas, se especifica en este apartado la instalación y configuración del Sistema Operativo utilizado en Raspberry Pi, de cara a la implantación del Proyecto en un entorno final.

## 20.1. Sistema Operativo base

Se elige Arch Linux ARM como Sistema Operativo base para Raspberry Pi. Para su instalación, es necesario introducir una tarjeta SD (o microSD con adaptador SD) en un ordenador con algún sistema GNU/Linux instalado y conexión a internet. A continuación, ingresar a un terminal e introducir los siguientes comandos, como superusuario o usuario root:

1. Iniciar fdisk en la SD (donde mmblk0 es el identificador de la tarjeta SD):

# fdisk /dev/mmcblk0

2. Dentro del prompt de fdisk, borrar las particiones antiguas y crear nuevas:
a) Escribir o para borrar las particiones de la SD.
b) Escribir n y luego p para crear partición primaria. Introducir 1 para crear la primera partición, pulsar ENTER y luego escribir +100M para los sectores a comprender.
c) Escribir t y luego c para formatear la partición como FAT32.
d) Escribir n y luego presionar ENTER 4 veces para crear la segunda partición primaria con los valores por defecto
e) Por último, escribir w para escribir los cambios a la tarjeta SD y salir.
3. Crear y montar el sistema FAT32:

# mkfs.vfat /dev/mmcblk0p1 && mkdir boot && mount /dev/mmcblk0p1 ,→ boot

4. Crear y montar el sistema ext4:

# mkfs.ext4 /dev/mmcblk0p2 && mkdir root && mount /dev/mmcblk0p2 ,→ root

5. Descargar y descomprimir Arch Linux ARM a la tarjeta SD:

# wget http://archlinuxarm.org/os/ArchLinuxARM-rpi-latest.tar.gz ,→ && bsdtar -xpf ArchLinuxARM-rpi-latest.tar.gz -C root && sync

6. Mover archivos necesarios a la partición boot:

ANEXOS

# mv root/boot/* boot

7. Desmontar particiones:

# umount boot root

Una vez acabado esto, Arch Linux ARM estará instalado en la tarjeta SD.

## 20.2. Configuración del Sistema

Con el Sistema Operativo ya instalado, se debe introducir la tarjeta SD en la Raspberry Pi, conectando además un cable Ethernet y el cable de corriente. Una vez encendida, ingresar mediante un terminal vía SSH desde un ordenador a la Raspberry Pi, utilizando alarm como usuario y alarm como contraseña. Para configurar Arch Linux ARM e instalar los programas necesarios para el correcto funcionamiento del sistema de alertas, ejecutar las siguientes órdenes:

1. Ingresar como superusuario, utilizando root como contraseña:

# su

2. Configurar los locales del sistema a Español:

# sed -i "s^#es_ES.UTF-8 UTF-8^es_ES.UTF-8 UTF-8^g"

,→ /etc/locale.gen
# locale-gen

# localectl set-locale LANG="es_ES.UTF8", LC_TIME="es_ES.UTF8" # rm -f /etc/localtime ; ln -s /usr/share/zoneinfo/Europe/Madrid ,→ /etc/localtime

3. Sincronizar los repositorios y actualizar el sistema:

# pacman -Syyu --noconfirm

4. Instalación de paquetería necesaria para desarrollo, así como las herramientas git, Python y ARP-Scan:

# pacman -S base-devel wget python2 git bash-completion

,→ python2-pip arp-scan --noconfirm
5. Añadir el grupo wheel a los usuarios de sudo, grupo al que pertenece el usuario alarm:

# sed -i "s^# %wheel ALL=(ALL) ALL^%wheel ALL=(ALL) ALL^g"

,→ /etc/sudoers
6. Reiniciar el sistema para aplicar todos los cambios:

# reboot

7. Una vez iniciado de nuevo e ingresado mediante el usuario anterior (alarm), instalar la librería RPi.GPIO, necesaria para el uso de los pines GPIO de Raspberry Pi:

$ sudo pip2 install RPi.GPIO

ANEXOS

Una vez terminado, el sistema ya está listo para introducir en él el programa del sistema de alertas y ponerlo en marcha. Con el programa del sistema de alertas copiado a la Raspberry Pi, se procede a instalar el servicio del sistema operativo que iniciará el sistema de alertas automáticamente al arranque.

Para ello, crear el archivo /usr/lib/systemd/system/alertsystem.service y editarlo utilizando nano:

$ sudo nano /usr/lib/systemd/system/alertsystem.service

E incluir en este archivo el contenido del servicio:

[Unit]
Description=Alert system service for systemd After=network.target

[Service]
User=root
Type=idle
ExecStart=/usr/bin/python2.7 /RUTA/HACIA/FICHERO/main.py RemainAfterExit=yes

[Install]
WantedBy=multi-user.target

Donde se debe modificar la ruta hacia el fichero main.py del sistema del nodo central por la ruta completa hacia ese fichero. Por último, activar e iniciar el servicio:

$ sudo systemctl enable alertsystem.service $ sudo systemctl start alertsystem.service

ANEXOS

# 21. Estimación de Tamaño y Esfuerzos

Para la implantación de este sistema, es necesario contar con los siguientes componentes:

Una Raspberry Pi, junto con su adaptador de corriente, tarjeta SD, y latiguillo Ethernet RJ-45 o adaptador WiFi USB.

Un puente Philips Hue, junto con su adaptador de corriente y latiguillo Ethernet RJ-45.

Tantas bombillas Philips Hue de rosca E27 como se deban implantar en la vivienda. En este caso, como no se implanta el sistema en una vivienda final, se han utilizado dos bombillas.

Un smartphone Android, con la aplicación final instalada.

2 placas de circuito impreso (PCB) diseñadas conforme a los diseños incluidos en estos Anexos, junto con la electrónica y componentes necesarios para su montaje, que son:

- Un relé 4031 de 12V a 5V.
- Un relé T92S7A12 de 240V a 5V.
- 4 terminales para PCB de doble conexión.
- 2 resistencias de 4,7 KΩ.
- 2 conectores macho para PCB.

Un router WiFi o cable/módem WiFi.

Cables AWG 20 con conectores hembra para conexión con GPIO de Raspberry Pi.

Cableado de corriente para telefonillo y timbre.

Un timbre con su pulsador.

Un telefonillo.

ANEXOS

# 22. Hojas técnicas de componentes empleados

## Características

## Serie 40 - Mini-relé para circuito impreso enchufable 8 - 10 - 16 A

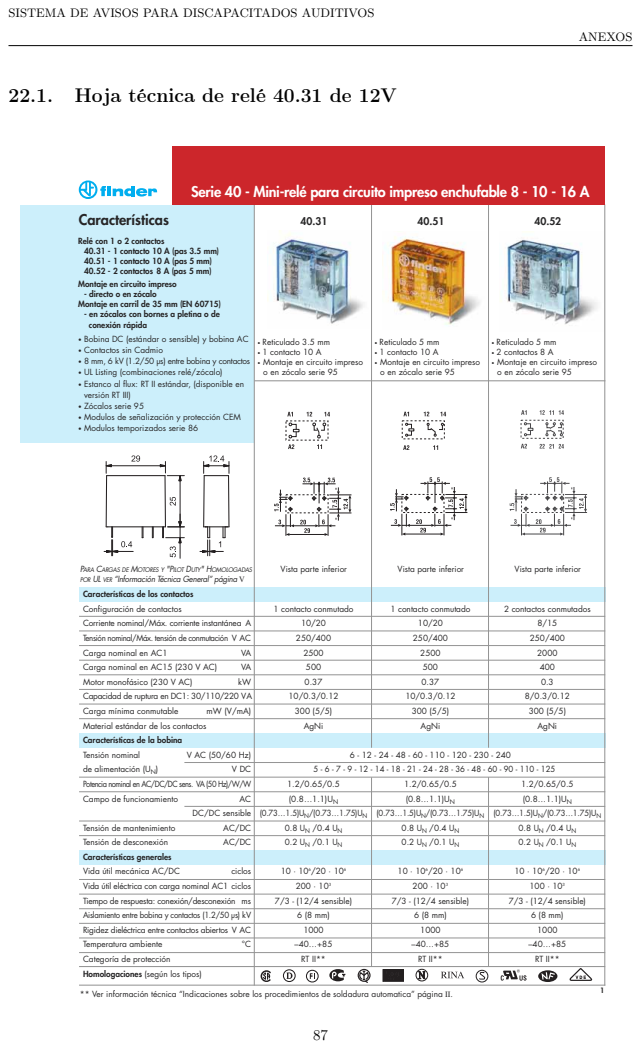
[picture p40: page 107]
1 contacto conmutado; 2 contactos conmutados; AgNi; 7/3 - (12/4 sensible); Carga nominal en AC1; Carga nominal en AC15 (230 V AC); Motor monofásico (230 V AC); Carga mínima conmutable; Tensión nominal; de alimentación (UN); Campo de funcionamiento; Tensión de mantenimiento; Tensión de desconexión; Vida útil mecánica AC/DC; ciclos; Temperatura ambiente; Vista parte inferior; ANEXOS

22.1. Hoja técnica de relé 40.31 de 12V

Relé con 1 o 2 contactos
40.31 - 1 contacto 10 A (pas 3.5 mm)
40.51 - 1 contacto 10 A (pas 5 mm)
40.52 - 2 contactos 8 A (pas 5 mm)
Montaje en circuito impreso
- directo o en zócalo
Montaje en carril de 35 mm (EN 60715)
- en zócalos con bornes a pletina o de
conexión rápida
• Bobina DC (estándar o sensible) y bobina AC
• Contactos sin Cadmio
• 8 mm, 6 kV (1.2/50 µs) entre bobina y contactos
• UL Listing (combinaciones relé/zócalo)
• Estanco al flux: RT II estándar, (disponible en
versión RT III)
• Zócalos serie 95
• Modulos de señalización y protección CEM
• Modulos temporizados serie 86

• Reticulado 3.5 mm
• 1 contacto 10 A
• Montaje en circuito impreso
o en zócalo serie 95

• Reticulado 5 mm

• 2 contactos 8 A

PARA CARGAS DE MOTORES Y "PILOT DUTY" HOMOLOGADAS
POR UL VER “Información Técnica General” página V
Características de los contactos
Configuración de contactos
Corriente nominal/Máx. corriente instantánea A
Tensión nominal/Máx. tensión de conmutación V AC
Capacidad de ruptura en DC1: 30/110/220 VA
Material estándar de los contactos
Características de la bobina
Potencia nominal en AC/DC/DC sens. VA (50 Hz)/W/W

DC/DC sensible

Características generales
Vida útil eléctrica con carga nominal AC1 ciclos
Tiempo de respuesta: conexión/desconexión ms
Aislamiento entre bobina y contactos (1.2/50 µs) kV
Rigidez dieléctrica entre contactos abiertos V AC
Categoría de protección
Homologaciones (según los tipos)
1 ** Ver información técnica “Indicaciones sobre los procedimientos de soldadura automatica” página II.

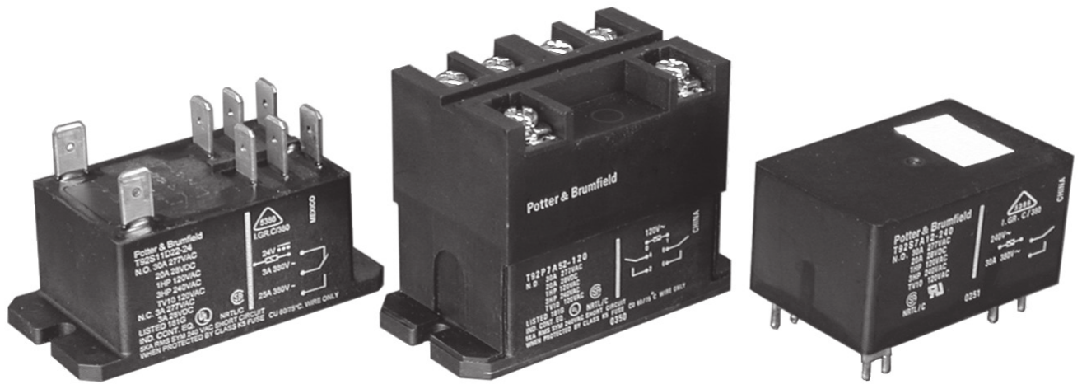
[picture p41: figure]

1
11-2012, Rev. 1112
www.te.com
© 2012 Tyco Electronics Corporation, a TE Connectivity Ltd. company.
Catalog and product specifi | cation according
to IEC 61810-1 and to be used only together
with the ‘Defi | nitions’ section.

Catalog and product data is subject to the terms of the disclaimer and all chapters of the ‘Defi nitions’ section, available at http://relays.te.com/definitions

Catalog product data, ‘De | finitions’ section,
application notes and all speci | fications are
subject to change.
Potter & Brum | field

General Purpose
High Power PCB Relays

### T92 Series Two-pole 30A PCB or Panel Mount Relay

Potter & Brum | field

Contact ratings ¹⁾ (continued)
ARI 780-86 Endurance Test (section 6.6):

HVAC Definite Purpose Contactor Standard

Normally Open Contacts
Single Phase/Two Pole (Both poles together switching a single load) 110 LRA, 25.3 FLA, 200K operations (DC Coil)

Figure 1

Single Phase Per Pole (Single load per pole) 110 LRA, 18 FLA, 200K operations (DC Coil). 60 LRA, 14 FLA, 200K operations (AC Coil).

Figure 2

1) Contact ratings at 25°C (unless otherwise noted) with relay properly vented.
FLA, LRA ratings are compatible with 3.5 ton compressor applications.
Mechanical endurance | 10x10⁶ ops.

Coil Data
Coil voltage range | 5 to 110VDC; 12 to 240VAC
Max. coil power | 1.7W; 4.0VA
Max. coil temperature | 155°C
Coil insulation system according UL | Class F
Coil versions, DC coil
Coil | Rated | Operate | Release | Coil | Rated coil
code | voltage | voltage | voltage | resistance | power
VDC | VDC | VDC | Ω±10% | W
6 | 6 | 4.5 | 0.6 | 22 | 1.7
9 | 9 | 6.75 | 0.9 | 48 | 1.7
12 | 12 | 9 | 1.2 | 86 | 1.7
18 | 18 | 13.5 | 1.8 | 197 | 1.7
24 | 24 | 18 | 2.4 | 350 | 1.7
48 | 48 | 36 | 4.8 | 1390 | 1.7
110 | 110 | 82.5 | 11 | 7255 | 1.7
Coil versions, AC coil
Coil | Rated Frequency Operate | Release | Coil | Rated coil
code voltage | voltage | voltage resistance power
VAC | Hz | VAC, 60Hz VAC, 60Hz Ω±10% | VA
12 | 12 | 60 | 9.6 | 1.2 | 9.1 | 4
24 | 24 | 60 | 19.2 | 2.4 | 36.6 | 4
120 110/120 | 50/60 | 96 | 12 | 950 | 4
240 220/240 | 50/60 | 192 | 24 | 3800 | 4
277 250/277 | 50/60 | 222 | 28 | 5485 | 4
All fi | gures are given for coil without preenergization, at ambient temperature +23°C.

n 40A, 2 form A (NO) and 2 form C (CO) switching capability
n Designed to control compressor loads to 3.5 tons, 110LRA / 25.3FLA n Meets requirements of UL 508 and UL 873 spacings - 8mm through air, 9.5mm over surface
n Meets requirements of VDE 8mm spacing, 4kV dielectric coil-tocontact
n Meets requirements of UL Class F construction
n UL approved for 600VAC switching (1.5HP)
n New screw terminal version (consult factory for availability, ratings)

Typical applications
HVAC, residential / commercial appliances, industrial controls.

Approvals
UL E58304 (Recognized and Listed); CSA LR48471; VDE 40019600
Technical data of approved types on request.
Contact Data
Contact arrangement | 2 form A (NO), 2 form C (CO)
Rated voltage | 277VAC
Max. switching voltage | 600VAC
Rated current | 30A NO; 3A NC
Limiting continuous current | 40A NO; 3A NC
Limiting making current | 40A NO; 3A NC
Limiting breaking current | 40A NO; 3A NC
Contact material | AgSnOInO, AgCdO
Min. recommended contact load | 500ma (NO)/ 100ma (NC), 12VAC
Frequency of operation, with load | 360hr
Operate/release time max., including bounce | 25/25ms

Contact ratings ¹⁾
Type | Load | Cycles
UL508
AgCdO
NO | 40A, 277VAC, resistive | 6x10³
NO | 30A, 120/277VAC, resistive | 100x10³
NO | 10A, 600VAC, general purpose | 100x10³
NO | 1HP, 120VAC | 100x10³
NO | 3HP, 240VAC | 1x10³
NO | 1.5HP, 480 or 600VAC | 100x10³
NO | 110LRA/25.3FLA, 240VAC (DC coil only) | 100x10³
NO | 60LRA/14FLA, 240VAC (AC coil only) | 100x10³
NO | 3A, 240VAC, pilot duty | 100x10³
NO | 20A, 28VDC, resistive | 100x10³
NO | TV10, 120VAC | 100x10³
NC | 3A, 277VAC | 100x10³
NC | 2A, 480VAC | 100x10³
NC | 1A, 600VAC | 100x10³
AgSnOInO
NO | 30A, 120/277VAC, resistive (DC coil only) | 200x10³
NO | 30A, 120/277VAC, resistive (AC coil only) | 100x10³
NO | 20A, 480VAC, resistive | 100x10³
NO | 1.5HP, 120VAC, 2 pole making/breaking (Fig.1) 100x10³
NO | 3HP, 240VAC, 3 phase (DC coil only) | 100x10³
NO | 3HP, 480VAC, 3 phase (DC coil only) | 100x10³
NO | 2HP, 600VAC, 3 phase (DC coil only) | 100x10³
VDE
AgCdO, fl | ange mount relays
NO | 20A, 400VAC | 100x10³
NC | 3A, 400VAC | 30x10³
CO | 20A NO / 3A NC, 400VAC | 30x10³
AgCdO, PC mount relays
NO | 30A, 400VAC | 100x10³
NC | 3A, 400VAC | 30x10³
CO | 30A NO / 3A NC, 400VAC | 30x10³
L1 | L2
T1 | T2
L1 | L2
T1 | T2

ANEXOS

## 22.2. Hoja técnica de relé T92S7A12 de 240V

# SISTEMA DE AVISOS PARA DISCAPACITADOS

# AUDITIVOS

REF: 000001

# ESPEFICICACIONES DEL SISTEMA

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

AUTOR: RAÚL DÍEZ SÁNCHEZ
INGENIERO INFORMÁTICO
77171812-G
RA.DIEZSANCHEZ@ALUM.UCA.ES

Cádiz, 3 de febrero de 2016

# Índice

23. Especificaciones del Sistema | 93

ESPECIFICACIONES DEL SISTEMA

# 23. Especificaciones del Sistema

## 23.1. Estudio de las especificaciones

### 23.1.1. Dominio del problema

El dominio de este problema engloba a todas las personas con discapacidad auditiva que puedan requerir el uso del sistema a implementar. Para tratar el problema en cuestión, se realiza una entrevista con un grupo de personas con esta discapacidad.

### 23.1.2. Selección de personas a entrevistar

Para la obtención de unos datos ajustados a la realidad, se entrevista a personas con discapacidad auditiva pertenecientes a la asociación “Albor Cádiz”, de la que hay disponible más información en su página de Facebook: https://www.facebook.com/alborcadiz.

### 23.1.3. Objetivo y contenido de la entrevista

El objetivo de esta entrevista es el de obtener los requisitos del sistema, de la manera más real posible. El contenido de la entrevista se puede encontrar en el apartado 17.1 del Anexo.

### 23.1.4. Planificación de la entrevista

La entrevista se realiza el día 29 de Abril de 2015, a las 18:30 horas, en la sede de la asociación “Albor Cádiz”.

### 23.1.5. Análisis de los resultados obtenidos en la entrevista

1 ¿Qué avisos son importantes para ti en tu hogar?
En la figura 23.1 se puede observar como las alertas de mayor interés son las llamadas a la puerta (timbre) o al telefonillo, además de varias sugerencias para otros avisos. Queda así descartado el control de alertas para llamadas de teléfono, pues no supone gran interés.

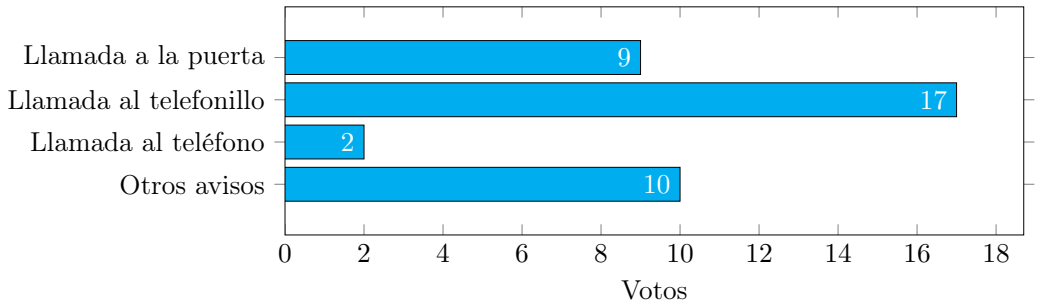
[picture p42: figure]
Otros avisos; Llamada al teléfono; Llamada al telefonillo; Llamada a la puerta; Votos

Figura 23.1: Resultados para “¿Qué avisos son importantes para ti en tu hogar?”

ESPECIFICACIONES DEL SISTEMA

### 2 En la actualidad, ¿cómo te percatas de estos avisos?

Se observa en la figura 23.2 los resultados para esta pregunta. La mayoría de los encuestados utilizan actualmente sistemas de alertas mediante luces.

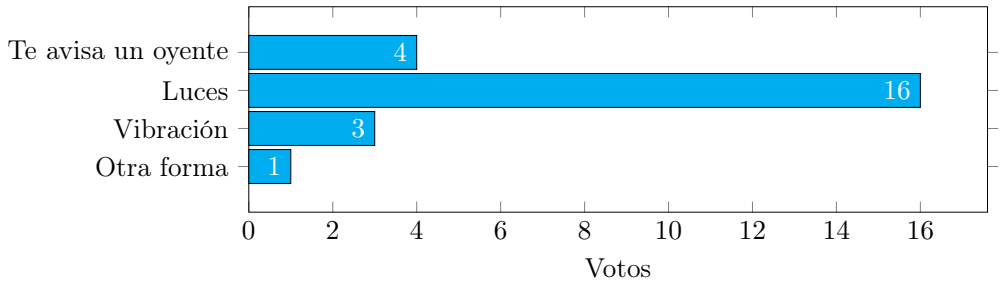
[picture p43: figure]
Otra forma; Vibración; Luces; Te avisa un oyente; Votos

Figura 23.2: Resultados para “En la actualidad, ¿cómo te percatas de estos avisos?”

### 3 Haciendo uso de las nuevas tecnologías, ¿crees que puede mejorarse?, ¿cómo te

gustaría percatarte de los avisos?
Los resultados para esta pregunta se exponen en la figura 23.3. La mayoría de los encuestados prefieren alertas con luces, en concreto, de colores y parpadeantes, según comentan; además de vibraciones, esta última forma genera cierto rechazo ya que puede sobresaltar al usuario.
0 | 2 | 4 | 6 | 8 | 10 | 12 | 14 | 16 | 18

Otras

Vibración

Luces

0

7

17

Votos

Figura 23.3: Resultados para “Haciendo uso de las nuevas tecnologías, ¿crees que puede mejorarse?,¿cómo te gustaría percatarte de los avisos?”

### 4 Continuando con las nuevas tecnologías, ¿crees que sería útil recibir las mismas

alertas en smartphones Android?
Para esta última pregunta, en la figura 23.4 se observan los resultados obtenidos. Casi todos los discapacitados encuestados prefieren recibir las mismas alertas en sus smartphones Android, apostando por el uso de aplicaciones para estas alertas.
0 | 2 | 4 | 6 | 8 | 10 | 12 | 14

No

Sí

6

14

Votos

Figura 23.4: Resultados para “Continuando con las nuevas tecnologías, ¿crees que sería útil recibir las mismas alertas en smartphones Android?”

ESPECIFICACIONES DEL SISTEMA

En cualquier caso, los resultados no están lejos de los esperados, llegando así en resumen a las siguientes conclusiones:

Los avisos tratados serán las llamadas a la puerta de la vivienda (timbre) y las llamadas al telefonillo o portero automático.

Los avisos se tratarán como alertas visuales mediante luces de colores.

Además de las luces, se desarrollará una aplicación para Android en la que se notifiquen las mismas alertas, ya que es el sistema operativo para smartphone más extendido en el mercado.

## 23.2. Descripción del problema

El usuario tiene una discapacidad auditiva.

El usuario necesita percatarse de las alertas sonoras que se dan en el entorno de alguna manera.

Las alertas serán: llamada al telefonillo y llamada al timbre de la puerta de la vivienda.

Las alertas se deben conectar a un sistema.

El sistema alertará visualmente al usuario mediante luces de colores, y mostrando notificaciones en su smartphone.

## 23.3. Objetivos del sistema

OBJ-01 | Alertar a usuario de llamada al timbre.
Descripción | El sistema deberá alertar visualmente mediante el cambio de color de las luces y mediante notificación vía smartphone de la llamada al timbre al usuario.
Importancia | Alta.
Estabilidad | Alta.
Comentarios | Ninguno.

Tabla 23.1: Objetivo 1 del sistema: Alertar a usuario de llamada al timbre.

OBJ-02 | Alertar a usuario de llamada al telefonillo.
Descripción | El sistema deberá alertar visualmente mediante el cambio de color de las luces y mediante notificación vía smartphone de la llamada al telefonillo al usuario.
Importancia | Alta.
Estabilidad | Alta.
Comentarios | Ninguno.

Tabla 23.2: Objetivo 2 del sistema: Alertar a usuario de llamada al telefonillo.

ESPECIFICACIONES DEL SISTEMA

## 23.4. Requisitos de información

CRQ-01 | Relación entre alertas.
Objetivos asociados | OBJ-01 Alertar a usuario de llamada al timbre. OBJ-02 Alertar a usuario de llamada al telefonillo.
Requisitos asociados | IRQ-01 Información de alertas.
Descripción | Solo se podrá mostrar una alerta a la vez.
Importancia | Alta.
Estabilidad | Alta.

Tabla 23.3: Requisitos de restricciones de información.

IRQ-01 | Información de alertas.
Objetivos asociados | OBJ-01 Alertar a usuario de llamada al timbre. OBJ-02 Alertar a usuario de llamada al telefonillo.
Requisitos asociados | UC-01 Alertar timbre. UC-02 Alertar telefonillo. UC-03 Mostrar alerta.
Descripción | El sistema deberá alertar de los eventos que sucedan. Estos eventos se almacenarán de forma temporal en la memoria del sistema central, a modo de variables del programa.
Datos específicos | Fecha y hora. Tipo de alerta (llamada a la puerta o al telefonillo).
Importancia | Alta.
Estabilidad | Alta.

Tabla 23.4: Requisitos de almacenamiento de información.

## 23.5. Diagrama de Casos de Uso

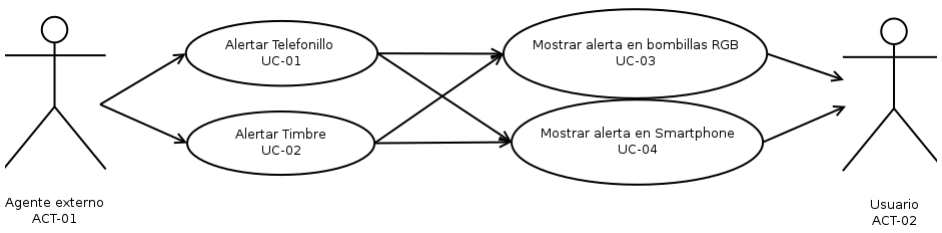
[picture p44: figure]

Figura 23.5: Diagrama de Casos de Uso.

ESPECIFICACIONES DEL SISTEMA

## 23.6. Definición de actores

ACT-01 | Agente externo.
Descripción | Persona externa al sistema que efectúa la alerta.

Tabla 23.5: Actor 01: agente externo.

ACT-02 | Usuario.
Descripción | Usuario final del sistema.

Tabla 23.6: Actor 02: usuario del sistema.

## 23.7. Requisitos funcionales (Casos de Uso)

UC-01 | Alertar telefonillo.
Objetivos asociados | OBJ-02 Alertar a usuario de llamada al telefonillo.
Requisitos asociados | IRQ-01 Información de alertas.
Descripción | El sistema deberá comportarse tal como se describe en este Caso de Uso cuando un Agente Externo llame al telefonillo.
Precondición | Un Agente Externo llama al telefonillo.
Secuencia normal | Paso | Acción
| 1 | Llaman al telefonillo.
| 2 | Se envía una alerta al sistema.
| 3 | Se realizan los Casos de Uso UC-03 y UC-04.
Postcondición | Se envía la alerta al sistema.
Excepciones | Ninguna.
Rendimiento | Paso | Cota de tiempo
| 2 | <1 segundo.
Comentarios | La frecuencia dependerá de factores externos al sistema que se estudia en el Proyecto.

Tabla 23.7: Caso de Uso 01: Alertar telefonillo.

ESPECIFICACIONES DEL SISTEMA

UC-02 | Alertar timbre.
Objetivos asociados | OBJ-01 Alertar a usuario de llamada al timbre.
Requisitos asociados | IRQ-01 Información de alertas.
Descripción | El sistema deberá comportarse tal como se describe en este Caso de Uso cuando un Agente Externo llame al timbre de la puerta.
Precondición | Un Agente Externo llama al timbre.
Secuencia normal | Paso | Acción
| 1 | Llaman al timbre.
| 2 | Se envía una alerta al sistema.
| 3 | Se realizan los Casos de Uso UC-03 y UC-04.
Postcondición | Se envía la alerta al sistema.
Excepciones | Ninguna.
Rendimiento | Paso | Cota de tiempo
| 2 | <1 segundo.
Comentarios | La frecuencia dependerá de factores externos al sistema que se estudia en el Proyecto.

Tabla 23.8: Caso de Uso 02: Alertar timbre.

UC-03 | Mostrar alerta en bombilla RGB.
Objetivos asociados | OBJ-01 Alertar a usuario de llamada al timbre. OBJ-02 Alertar a usuario de llamada al telefonillo.
Requisitos asociados | IRQ-01 Información de alertas.
Descripción | El sistema cambiará el estado de las bombillas RGB de acuer-do a la alerta recibida siempre que estas no ocurran de ma-nera simultánea.
Precondición | Se dan uno de los dos Casos de Uso asociados a alertas: UC-01 o UC-02.
Secuencia normal | Paso | Acción
| 1 | Se recibe la alerta en el sistema.
| 2 | Se almacena el estado de las bombillas RGB.
| 3 | Se genera alerta luminosa cambiando el estado de las bombillas RGB.
| 4 | Se regresa al estado previo a la alerta.
Postcondición | El Usuario percibe la alerta.
Excepciones | Paso | Acción
| 1 | Se solapen 2 o más alertas y se omita el aviso.
Rendimiento | Paso | Cota de tiempo
| 2 | ∼1 segundo.
Comentarios | La frecuencia dependerá de factores externos al sistema que se estudia en el Proyecto.

Tabla 23.9: Caso de Uso 03: Mostrar alerta en bombilla RGB.

ESPECIFICACIONES DEL SISTEMA

UC-04 | Mostrar alerta en smartphone.
Objetivos asociados | OBJ-01 Alertar a usuario de llamada al timbre. OBJ-02 Alertar a usuario de llamada al telefonillo.
Requisitos asociados | IRQ-01 Información de alertas.
Descripción | El sistema enviará una notificación al smartphone de acuerdo a la alerta recibida siempre que estas no ocurran de manera simultánea.
Precondición | Se dan uno de los dos Casos de Uso asociados a alertas: UC-01 o UC-02.
Secuencia normal | Paso | Acción
| 1 | Se recibe la alerta en el sistema.
| 2 | Se envía la notificación al smartphone.
Postcondición | El Usuario percibe la alerta.
Excepciones | Paso | Acción
| 1 | Se solapen 2 o más alertas y se omita el aviso.
Rendimiento | Paso | Cota de tiempo
| 2 | ∼1 segundo.
Comentarios | La frecuencia dependerá de factores externos al sistema que se estudia en el Proyecto.

Tabla 23.10: Caso de Uso 04: Mostrar alerta en smartphone.

ESPECIFICACIONES DEL SISTEMA

## 23.8. Requisitos no funcionales

Teniendo en cuenta las restricciones obtenidas a través de las encuestas realizadas, los requisitos no funcionales resultantes son los siguientes:

NFR–01: Se deben utilizar bombillas de luz LED RGB, para generar distintos colores en las alertas.

NFR–02: Se debe desarrollar una aplicación para Android en la que se reflejen también las mismas alertas.

Además, según el desarrollo del Proyecto y el estudio de distintas alternativas para la solución final, surgen otros requisitos funcionales:

NFR–03: Las bombillas a utilizar deben ser de rosca E27 (de acuerdo al Informe de diagnóstico del apartado 4.1).

NFR-04: El nodo central debe ser capaz de manipular peticiones HTTP (de acuerdo a la elección de bombillas en el apartado 10.2).

NFR–05: El nodo central debe ser capaz de manipular cadenas JSON (de acuerdo a la elección de bombillas en el apartado 10.2).

# SISTEMA DE AVISOS PARA DISCAPACITADOS

# AUDITIVOS

REF: 000001

# PRESUPUESTO

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

AUTOR: RAÚL DÍEZ SÁNCHEZ
INGENIERO INFORMÁTICO
77171812-G
RA.DIEZSANCHEZ@ALUM.UCA.ES

Cádiz, 3 de febrero de 2016

# Índice

24. Presupuesto | 105

PRESUPUESTO

# 24. Presupuesto

## 24.1. Presupuesto para la realización del Proyecto

En la tabla 24.1 se incluye el presupuesto total para la realización de este Proyecto, incluyendo también los costes asociados a la implementación del sistema de demostración, IVA incluido.

Artículo | Detalles | Cantidad | Precio | Total
Raspberry Pi B | [34] | 1 | 31,52 e/u | 31,52 e
Adaptador de corriente para Raspberry Pi | [31] | 1 | 5,78 e/u | 5,78 e
Relé 40.31 12V | [35] | 1 | 5,37 e/u | 5,37 e
Relé T92S7A12-240 240V | [36] | 1 | 17,69 e/u | 17,69 e
Terminal para PCB | [39] | 4 | 0,24 e/u | 0,96 e
Tarjeta SD 8GB para Raspberry Pi | [38] | 1 | 12,95 e/u | 12,95 e
Kit de inicio Philips Hue | [3] | 1 | 199,95 e/u | 199,95 e
Latiguillo 1m RJ-45 Cat5e | [33] | 1 | 2,06 e/u | 2,06 e
Resistencia de 4,7KΩ | [37] | 2 | 0,04 e/u | 0,8 e
Arduino Mega | [29] | 1 | 56,94 e/u | 56,94 e
Arduino Ethernet Shield | [28] | 1 | 24,01 e/u | 24,01 e
Cable USB para Arduino Mega | [30] | 1 | 3,31 e/u | 3,31 e
Zumbador 230V para timbre | - | 1 | 4,50 e/u | 4,50 e
Zumbador 12V para telefonillo | [40] | 1 | 2,71 e/u | 2,71 e
Fuente de alimentación 12V | [32] | 1 | 14,92 e/u | 14,92 e
Pulsador timbre | - | 1 | 2,75 e/u | 2,75 e
Portalámparas E27 | - | 2 | 0,90 e/u | 1,80 e
Total | | | | 388,02 e

Tabla 24.1: Presupuesto para la realización del Proyecto.

PRESUPUESTO

## 24.2. Presupuesto de implantación del Proyecto

En la tabla 24.2 se incluye el presupuesto total para la implantación de este Proyecto, IVA incluido.

Artículo | Detalles | Cantidad | Precio | Total
Raspberry Pi B | [34] | 1 | 31,52 e/u | 31,52 e
Adaptador de corriente para Raspberry Pi | [31] | 1 | 5,78 e/u | 5,78 e
Relé 40.31 12V | [35] | 1 | 5,37 e/u | 5,37 e
Relé T92S7A12-240 240V | [36] | 1 | 17,69 e/u | 17,69 e
Terminal para PCB | [39] | 4 | 0,24 e/u | 0,96 e
Tarjeta SD 8GB para Raspberry Pi | [38] | 1 | 12,95 e/u | 12,95 e
Kit de inicio Philips Hue | [3] | 1 | 199,95 e/u | 199,95 e
Latiguillo 1m RJ-45 Cat5e | [33] | 1 | 2,06 e/u | 2,06 e
Resistencia de 4,7KΩ | [37] | 2 | 0,04 e/u | 0,8 e
Total | | | | 277,08 e

Tabla 24.2: Presupuesto de implantación del Proyecto.

Este presupuesto no cubre el coste de un router integrado, el cual como se observa en el apartado 4.1.4, se supone ya instalado en la vivienda.

### 24.2.1. Mano de obra

La mano de obra asociada al Proyecto es de 35 e por instalación de dispositivo en portal, más 35 e por instalación de dispositivo en la puerta de la vivienda, más 60 e por instalación del sistema central y configuración. Esto hace un total de 130 e, tal como se observa en la tabla 24.3.

Descripción | Precio
Instalación de dispositivo en portal | 35 e
Instalación de dispositivo en puerta de la vivienda | 35 e
Instalación de sistema central y configuración | 60 e
Total | 130 e

Tabla 24.3: Presupuesto de mano de obra.

### 24.2.2. Resumen del presupuesto

Los costes de presupuesto para la implantación en una vivienda real son de 277.08 e, debiéndose sumar además el coste de mano de obra, que asciende a los 130 e. Esto supone un coste total

PRESUPUESTO

de 407.08 e. Se debe tener en cuenta además que este precio es el relativo a instalar 3 bombillas Hue, teniendo un coste de 52.99 e por bombilla extra a instalar [2], tal como se muestra en la tabla 24.4.

Descripción | Precio
Implantación del Proyecto en vivienda real | 277.08 e
Mano de obra | 130 e
Total | 407.08 e

Tabla 24.4: Resumen del presupuesto de implantación del Proyecto
