raudiez/tfg/src_tex/contenido/7_requisitos_iniciales.tex

    \label{chap:requisitosiniciales}

A partir de la encuesta realizada, disponible en el apartado~\ref{sec:especificaciones}, junto con información facilitada por el Cliente, se obtienen los requisitos iniciales del Proyecto:
    \begin{itemize}
        \item Se deben detectar las llamadas de timbre.
        \item Se deben detectar las llamadas de telefonillo.
        \item Alertar de los avisos mediante luces de distintos colores.
        \item Conectar smartphones Android al sistema de avisos.
        \item Notificar las alertas en smartphones Android.
    \end{itemize}

Estos requisitos se exponen de una manera más detallada en el apartado~\ref{sec:especificaciones}, ``Especificaciones del Sistema''.
