raudiez/tfg/src_tex/contenido/8_alcance.tex

El alcance de este proyecto engloba los siguientes puntos:
\begin{itemize}
    \item Desarrollo de la especificación de requisitos del sistema y su análisis.
    \item Diseño de la arquitectura general del sistema.
    \item Diseño de la interfaz de conexión entre los dispositivos generadores de alertas y los nodos informativos visuales.
    \item Elección de la tecnología de comunicación a emplear en el sistema.
    \item Implementación del software del sistema.
    \item Implementación del sistema con dos nodos informativos visuales como demostración. 
\end{itemize}
