raudiez/tfg/src_tex/content_planos/esque_12v_CAJETIN.pdf

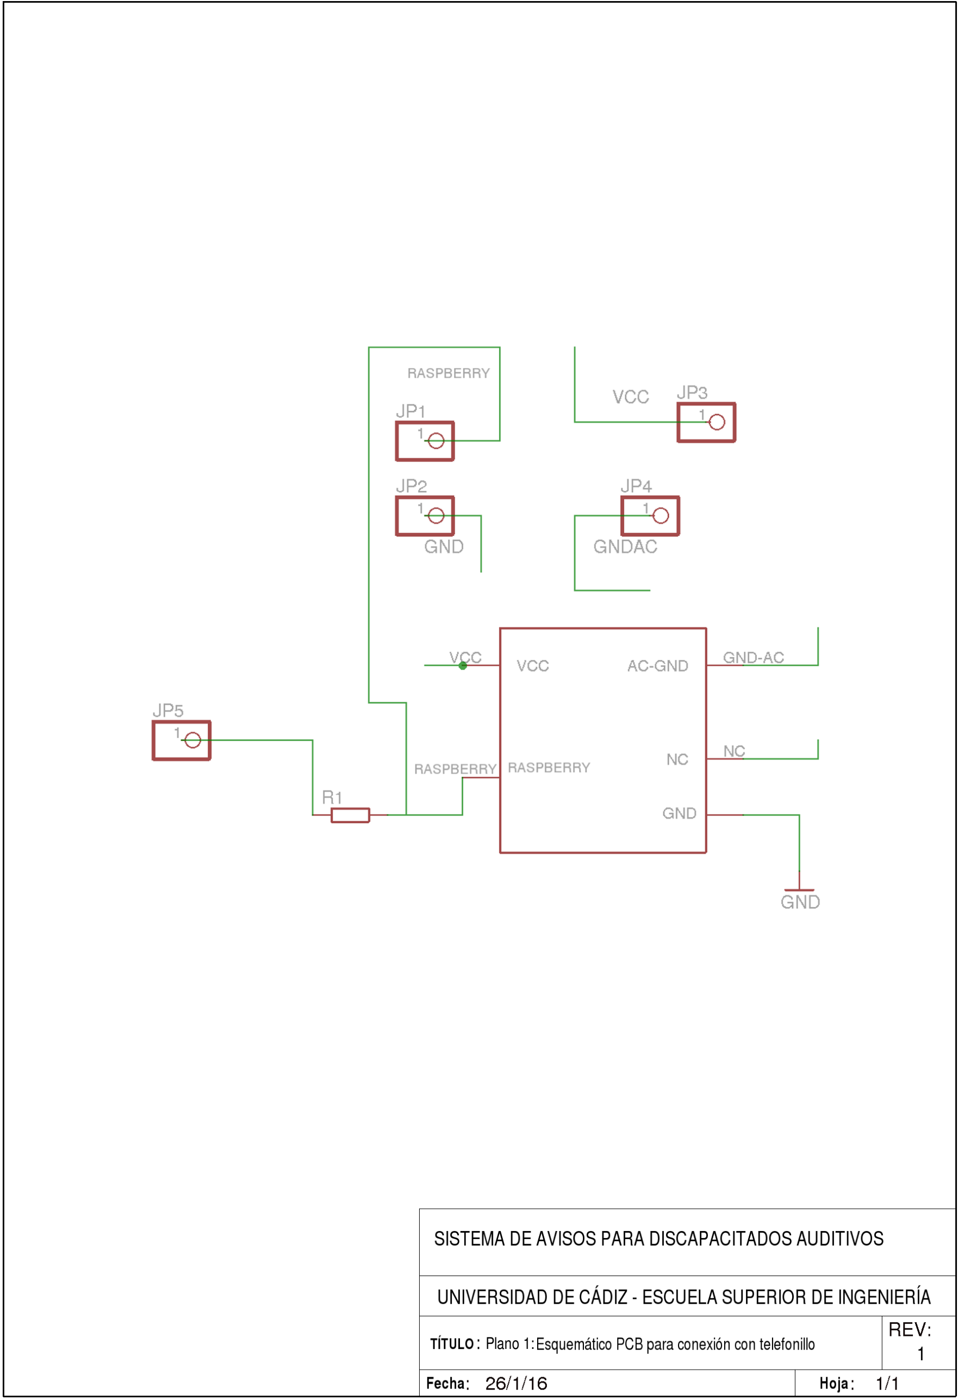
[picture p46: page 1]

Plano 1:
