raudiez/tfg/src_tex/content_planos/esque_240v_CAJETIN.pdf

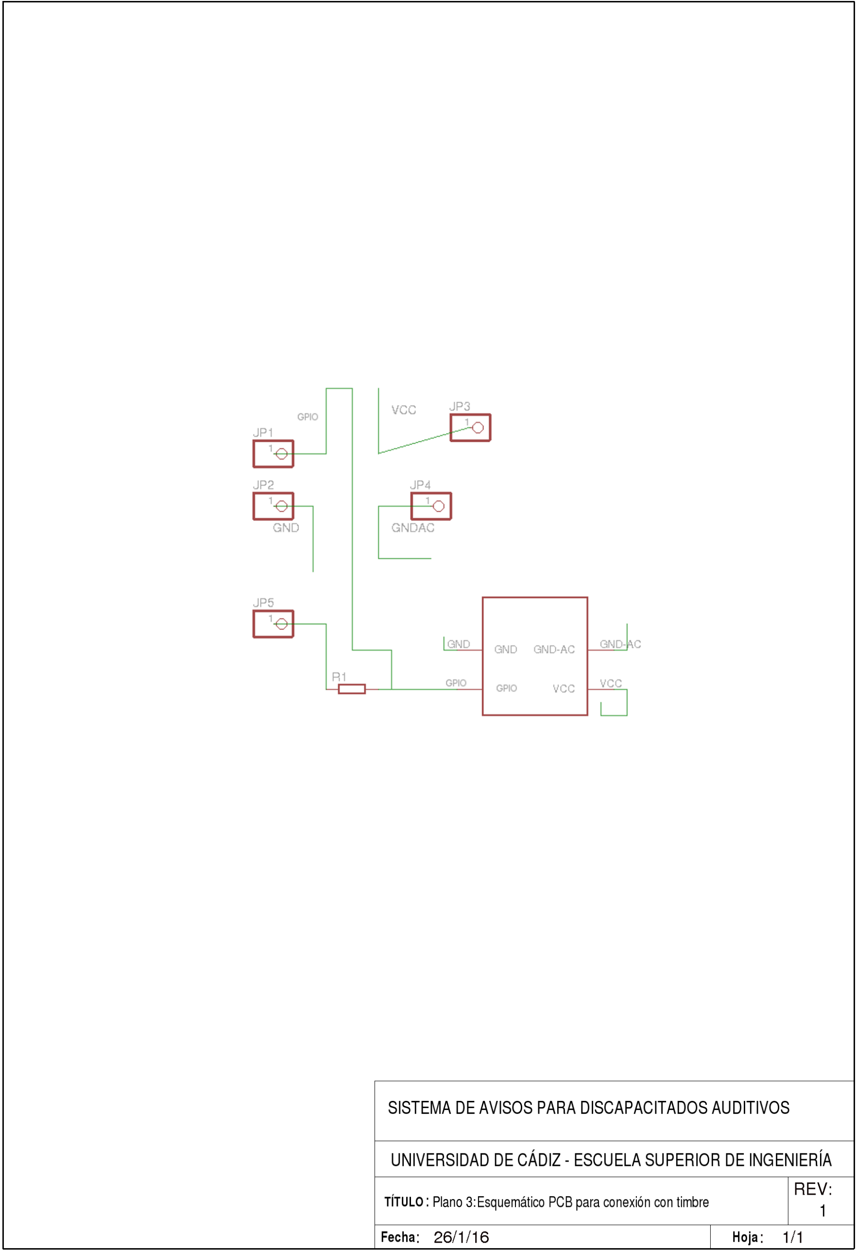
[picture p47: page 1]

Plano 3:
