raudiez/tfg/src_tex/content_planos/pcb_12v_CAJETIN.pdf

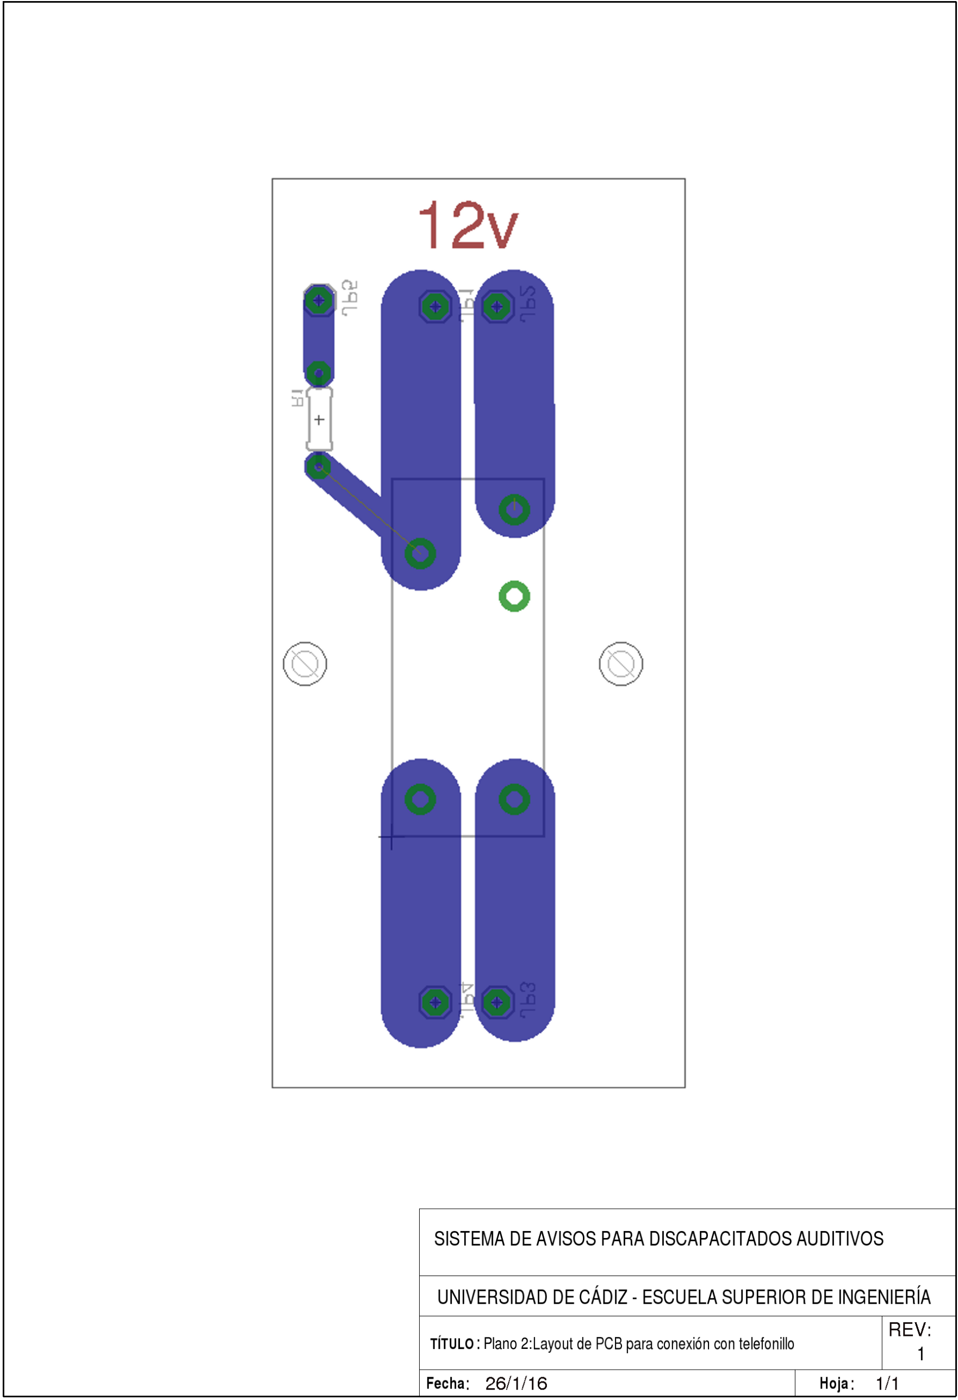
[picture p48: page 1]

Plano 2:
