raudiez/tfg/src_tex/content_planos/pcb_240v_CAJETIN.pdf

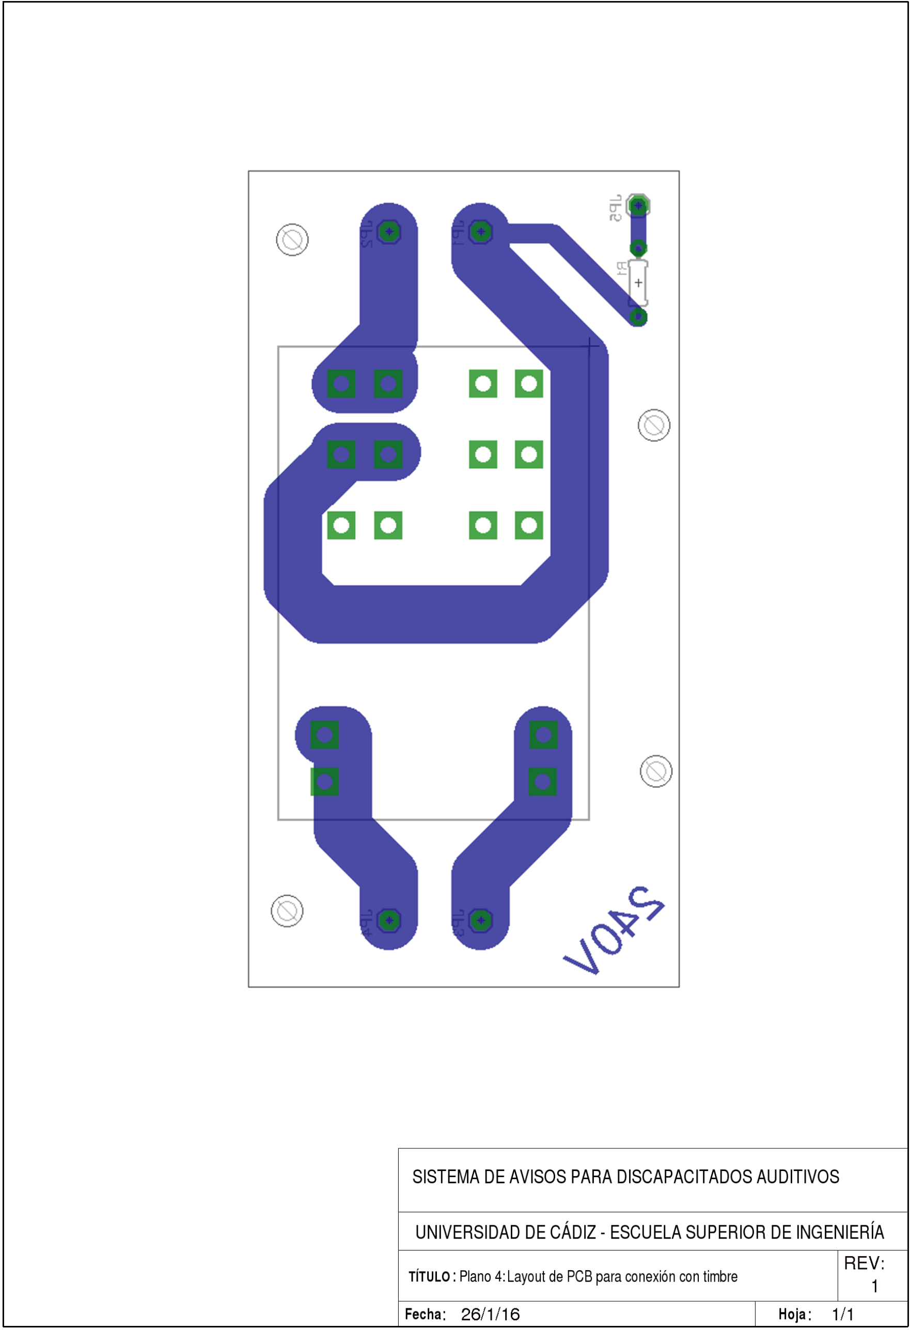
[picture p49: page 1]

Plano 4:
