raudiez/tfg/(commit log)

2016-01-13 Testing with socket always waiting.
2016-01-13 Adding thread to listen for socket connections.
2016-01-13 Messages with locales. Some comm fixes.
    [main.py]
2016-01-20 Doc updated with new PCB design.
